kosikhar/Analog-Drum-Machine/README.md

# Analog-Drum-Machine
Capstone 2019 Analog Drum Machine project.
