kosikhar/Analog-Drum-Machine/Mixer/Notes on Line Level.docx

# Notes on Line Level for Mixer Circuit

Andrew Schroeder | 1452924 | 2019-02-18

Current output from instruments: 2V
