kosikhar/Analog-Drum-Machine/Cowbell/Block Diagram/Block Diagram-1.jpg

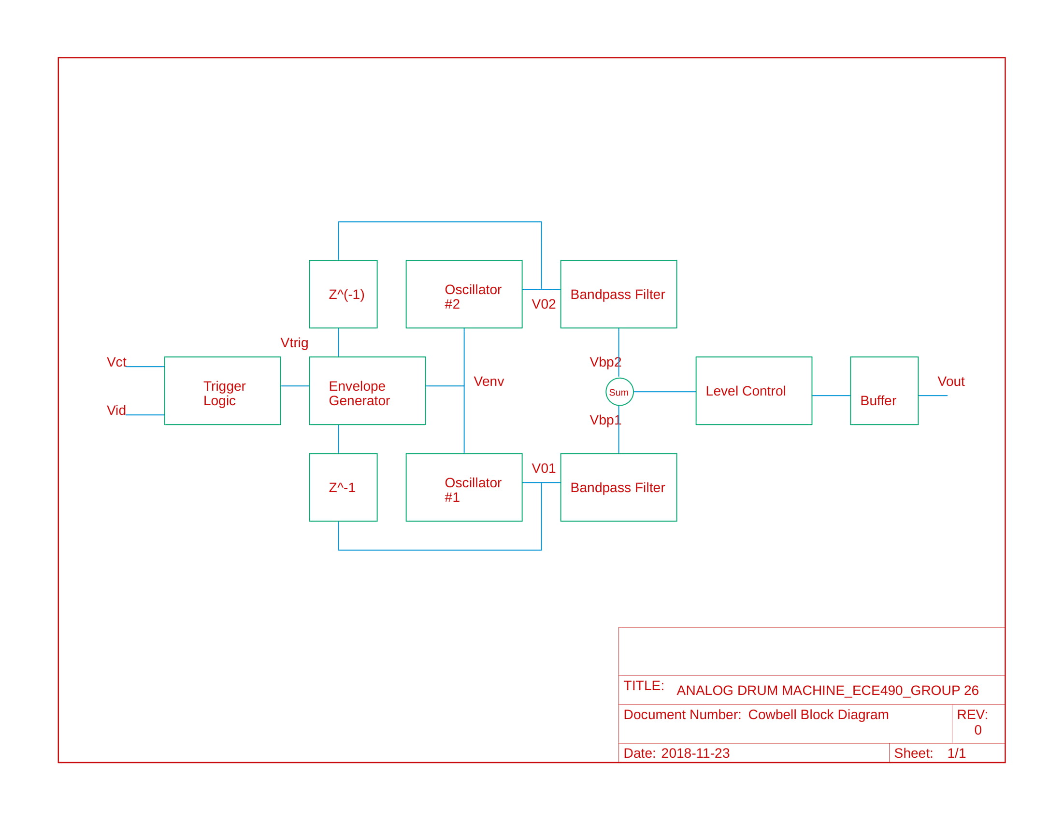
Cowbell/Block Diagram/Block Diagram-1.jpg
