kosikhar/Analog-Drum-Machine/Cowbell/Eagle Files/Cowbell_Brd.png

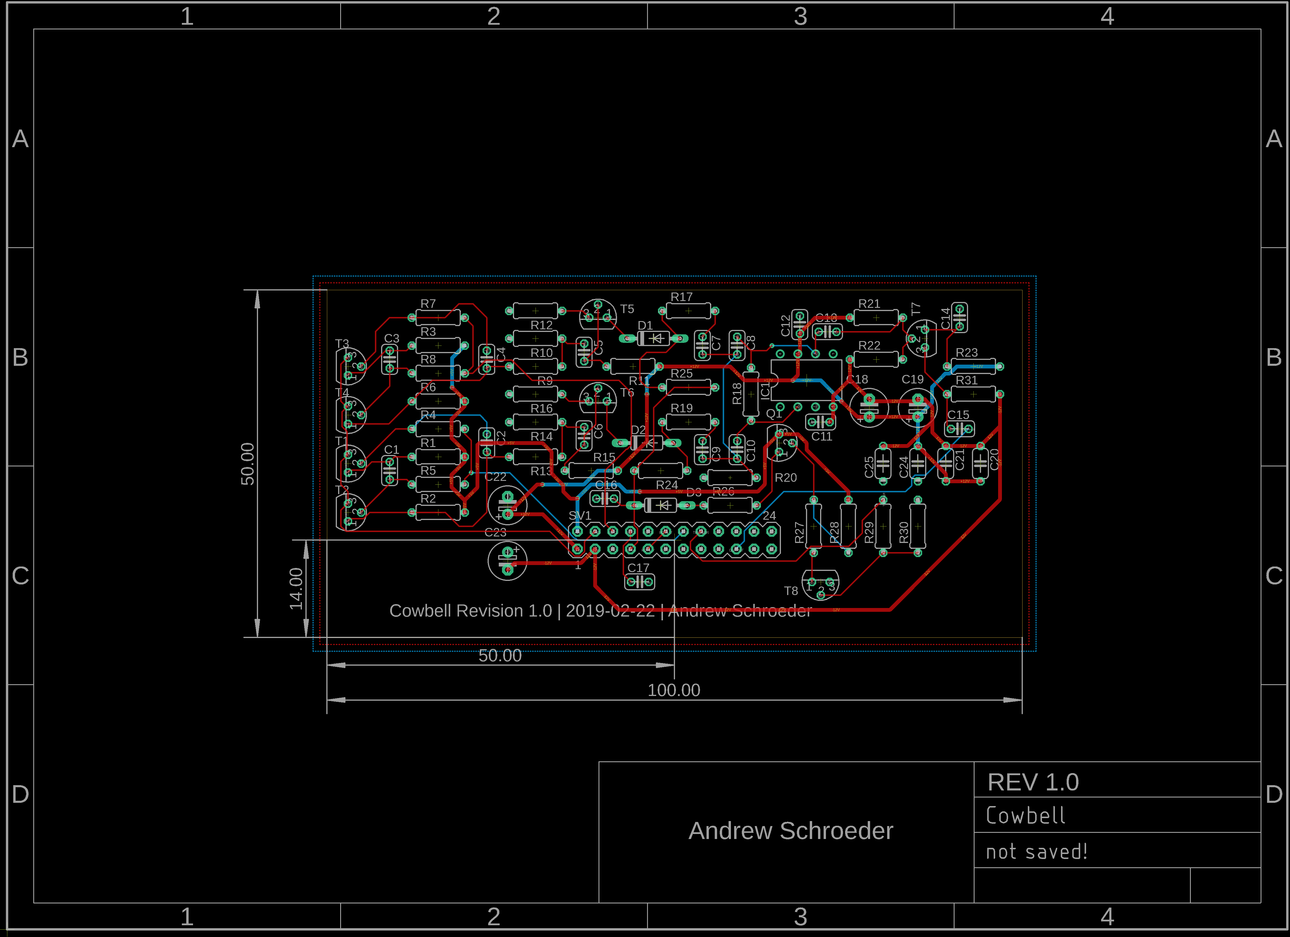
Cowbell/Eagle Files/Cowbell_Brd.png
