kosikhar/Analog-Drum-Machine/Cowbell/Eagle Files/Cowbell_Sch.png

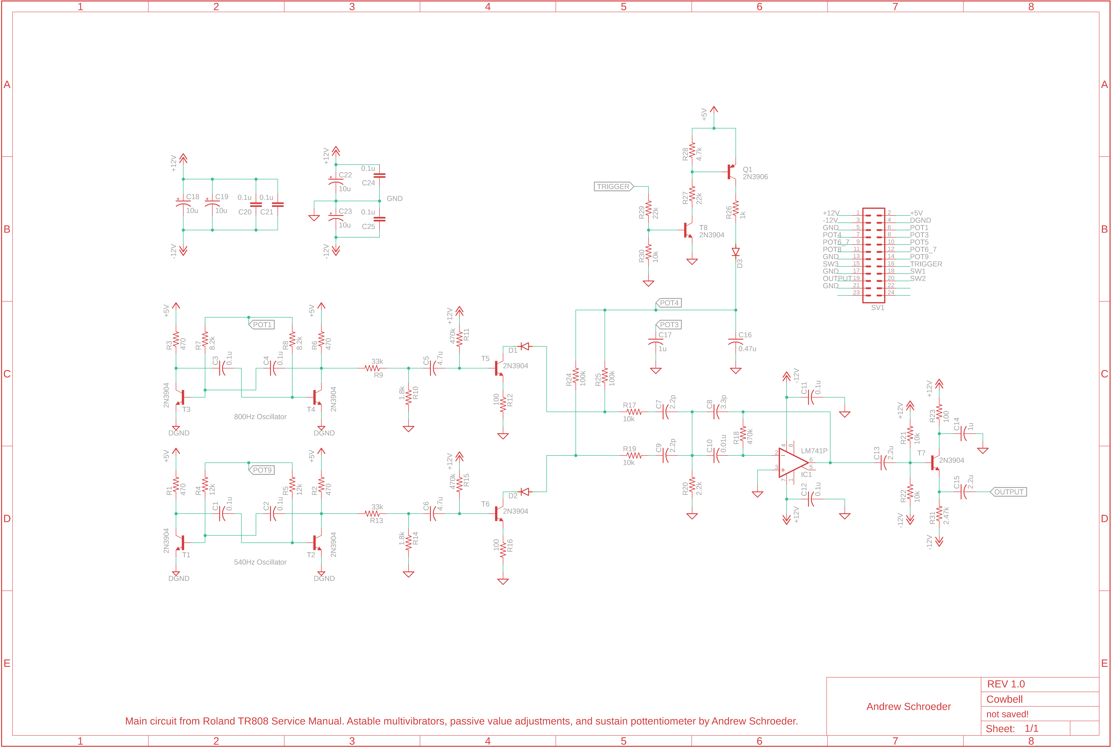
Cowbell/Eagle Files/Cowbell_Sch.png
