kosikhar/Analog-Drum-Machine/Mixer/Design References/Working with Cranky Op-Amps_files/hs-opamp-schem.png

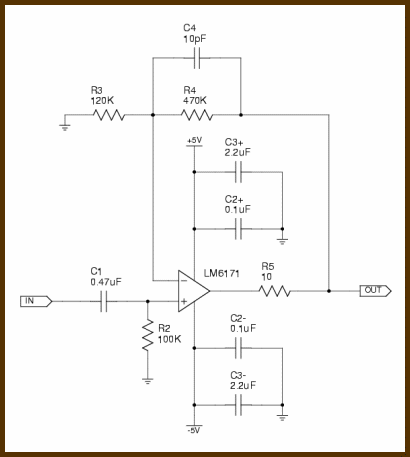
Mixer/Design References/Working with Cranky Op-Amps_files/hs-opamp-schem.png
