kosikhar/Analog-Drum-Machine/Mixer/Eagle Files/Mixer_Brd.png

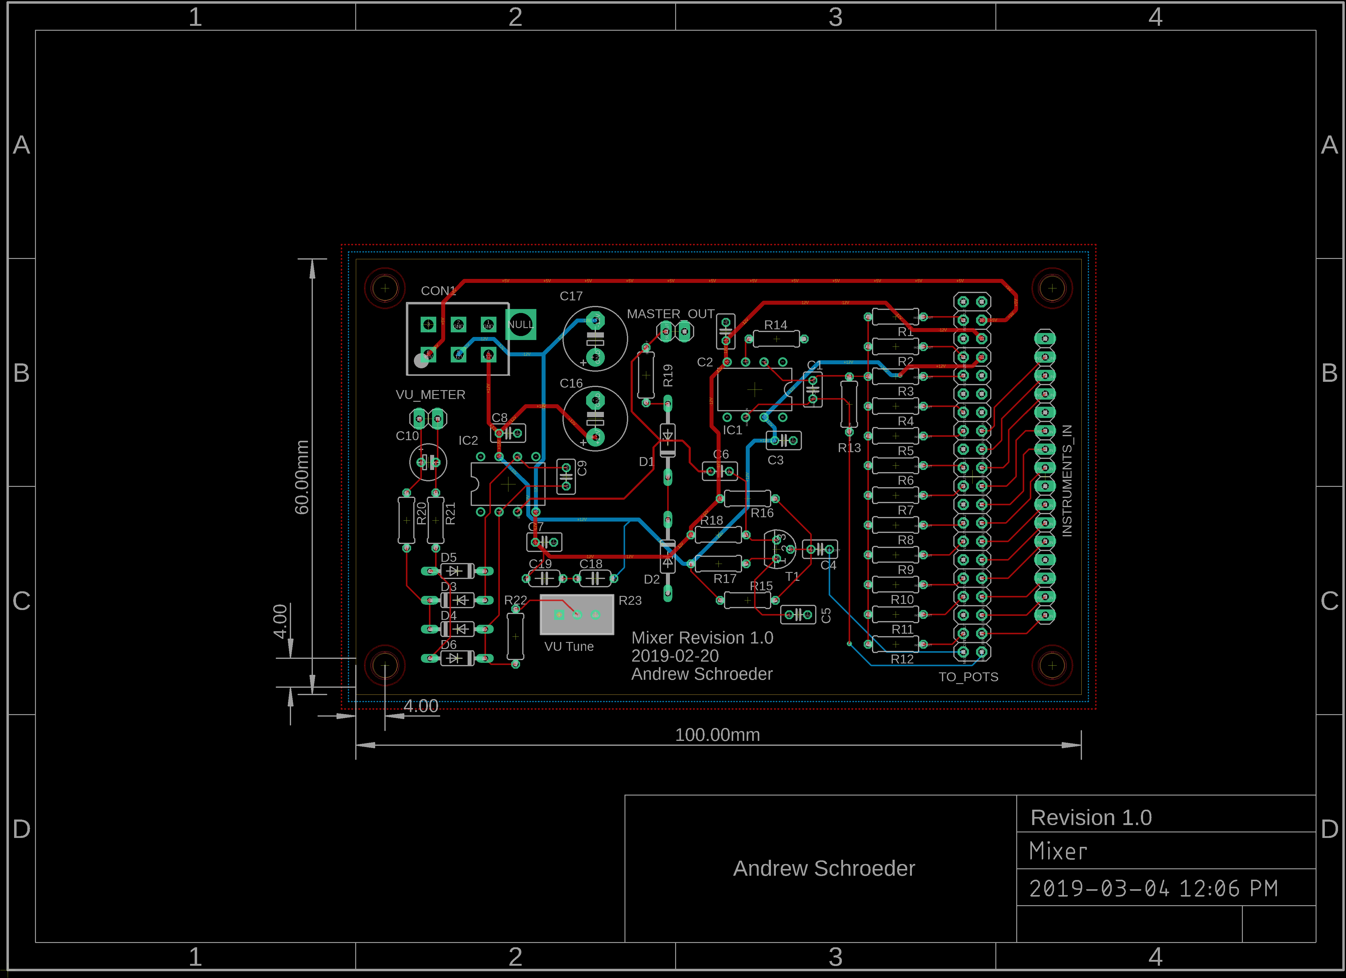
Mixer/Eagle Files/Mixer_Brd.png
