kosikhar/Analog-Drum-Machine/Mixer/Eagle Files/Mixer_Sch.png

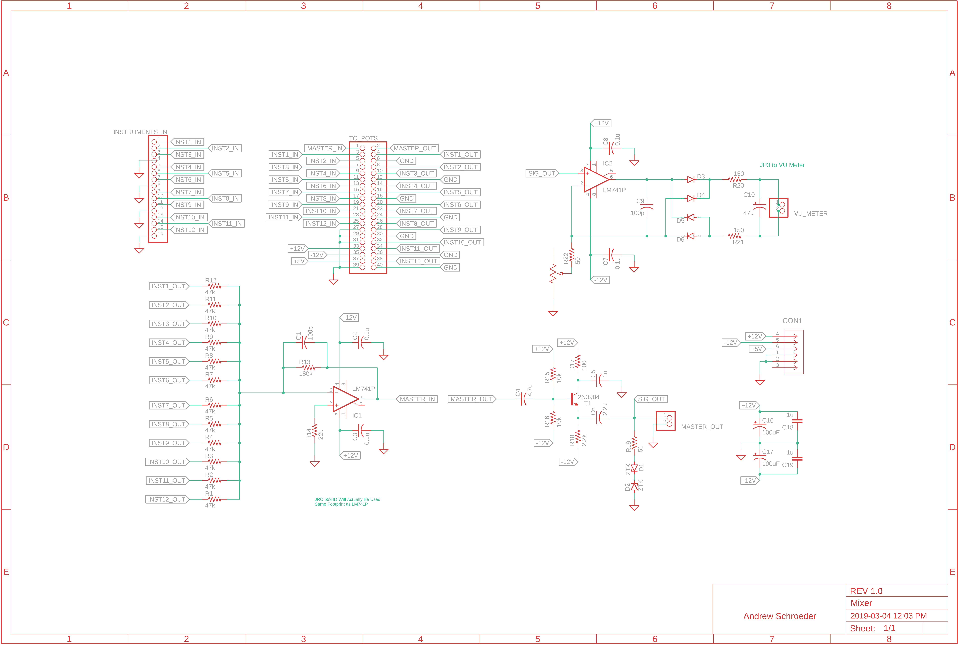
Mixer/Eagle Files/Mixer_Sch.png
