kosikhar/Analog-Drum-Machine/Cowbell/CB_BOM.xlsx

Shematic Reference Number | Part Description | Manufacturer Part Number | Price | Quantity Required | Owned | Total Cost | Location | Notes
C1, C6 | capacitor, 10µF | UCA2G100MPD1TD | $1.19 | 2 | 0 | $2.38 | ECE 302 or 303 Lab Kit
C2, C7 | capacitor, 2.2nF | VY1222M47Y5UQ63V0 | $0.66 | 2 | 0 | $1.32 | ECE 302 or 303 Lab Kit
C3 | capacitor, 10nF | C981U103MYVDBA7317 | $1.06 | 1 | 0 | $1.06 | Michael
C4, C15 | capacitor, 2.2µF | UMA1V2R2MCD2TP | $2.35 | 2 | 0 | $2.35 | General
C5, C9 | capacitor, 1µF | UVK1H010MDD1TD | $2.81 | 2 | 0 | $2.81 | General
C8 | capacitor, 3.3nF | DE2E3KY332MA3BM02F | $0.63 | 1 | 0 | $0.63 | CB Bag
C10 | capacitor, 470nF | C322C474M5U5TA | $0.72 | 1 | 0 | $0.72 | General
C11, C12 | capacitor, 15nF | K153K10X7RF5UH5 | $0.29 | 2 | 0 | $0.58 | CB Bag
C13, C14 | capacitor, 33nF | K333K15X7RF5TL2 | $0.34 | 2 | 0 | $0.68 | General
D1, D, D3 | Diode | 1n4148 | $0.93 | 3 | 0 | $0.93 | General
Q1, Q2, Q4-Q9 | NPN BJT | 2N3904 |  | 0 | 8 | $0.00 | Rick
Q3 | PNP BJT | 2N3906 |  | 0 | 1 | $0.00 | Rick
R1, R10, R17 | resistor, 33K | CF14JT33K0 | $0.63 | 3 | 0 | $0.63 | Resistor Bag
R2, R6, R11 | ` | CF14JT2K20 | $0.63 | 3 | 0 | $0.63 | Rick
R3, R7, R12 | resistor, 470K | CF14JT470K | $0.63 | 3 |  | $0.63 | Resistor Bag
R4, R13, R31 | resistor, 100 | CF14JT100R | $0.63 | 3 |  | $0.63 | Resistor Bag
R5, R8, R9, R16, R22 | resistor, 10K | CF14JT10K0 | $0.63 | 5 |  | $0.63 | Resistor Bag
R14, R15 | resistor, 100K | CF14JT100K | $0.63 | 2 |  | $0.63 | Resistor Bag
R18, R34 | resistor, 1K | CF14JT1K00 | $0.63 | 2 |  | $0.63 | Resistor Bag
R19, R21 | resistor, 22K | CF14JT22K0 | $0.63 | 2 |  | $0.63 | Resistor Bag
R20 | resistor, 4.7K | CF14JT4K70 | $0.63 | 1 |  | $0.63 | Resistor Bag
R23, R24, R27, R28 | resistor, 390 | CF14JT390R | $0.63 | 4 |  | $0.63 | Rick
R25, R26, R29, R30 | Duel Gang Log Pot, 100K | PDB182-K430K-104A | $2.81 | 2 |  | $5.62
R32 | resistor, 2.4K | CF14JT2K40 | $0.63 | 1 |  | $0.63 | Rick
R33 | resistor, 8K | CF14JT8K00 | $0.63 | 1 |  | $0.63
U1 | Op Amp | LM741 |  | 0 | 1 | $0.00
 |  |  |  |  |  | $26.64
 |  |  |  |  |  | #NAME?
