kosikhar/Analog-Drum-Machine/Mixer/Mixer_BOM.xlsx

Shematic Reference Number | Part Description | Digikey Part Number | Price | Quantity | Total Cost | Notes | Parts Received | Location of Parts
C1, C2, C5, C6 | capacitor, 100nF | 493-10420-1-ND | $14.24 | 26 | $14.24 | For 100 | 100 | Mixer Bag, General Bag
C4, C18 | capacitor, 2.2µF | 493-10467-1-ND | $4.70 | 13 | $4.70 | For 20 | 30 | Mixer Bag
C8 | capacitor, 10µF | 493-7383-1-ND | $1.24 | 1 | $1.24 |  | Use 4.7uF | Mixer Bag
C16 | capacitor, 4.7µF | 493-13004-1-ND | $1.04 | 1 | $1.04 |  | 5 | Mixer Bag
C17 | capacitor, 1µF | 493-12567-1-ND | $0.41 | 1 | $0.41 |  | 30 | General Bag
Q1 | bipolar transistor | 2N3904 |  | 0
R1 | resistor, 80.6K | RNF14FTD80K6CT-ND | $0.15 | 1 | $0.15 |  | 3 | Mixer Bag
R2, R4 | resistor, 1K | CF14JT1K00CT-ND | $0.16 | 24 | $0.16
R3, R5-R12, R15-R18, R21-R23 | resistor, 47K | CF14JT47K0CT-ND | $1.13 | 16 | $1.13 | For 25
R13 | resistor, 100 | CF14JT100RCT-ND | $0.16 | 1 | $0.16
R14 | resistor, 2.4K | PPC2.4KW-1CT-ND | $0.35 | 1 | $0.35
U2, U3 | Op Amp | uA741 |  | 13
U1, U4 | Pot | Rtot=50K wiper=1 |  | 13 |  |  | 1 | Mixer Bag
C3, C7 | capacitor, 100pF | BC5223CT-ND | $4.38 | 13 | $4.38 |  | 2 | Mixer Bag
 |  |  |  |  | $27.96
