kosikhar/Analog-Drum-Machine/Power Supply/Power Supply BOM V4.xlsx

Description | Digikey Part Number | Quantity | Individual Cost | Total
33VCT XFMR (already have) | HM563-ND | 1 | $36.11 | $36.11
6.3VCT XFMR (already have) | 237-1917-ND | 1 | $11.01 | $11.01
4A NPN | KSD526YTU-ND | 2 | $1.06 | $2.12
4A PNP | KSB596YTU-ND | 1 | $1.23 | $1.23
700mA NPN | KSC2331YTACT-ND | 2 | $0.62 | $1.24
700mA PNP | KSA931YTACT-ND | 1 | $0.57 | $0.57
LM741 | LM741CNNS/NOPB-ND | 1 | $1.31 | $1.31
8 pin DIP socket | AE9986-ND | 1 | $0.25 | $0.25
3A rectifier diode | 1N5402DICT-ND | 8 | $0.55 | $4.40
2.3A 47uH inductor | 732-3769-ND | 3 | $1.36 | $4.08
4.7V Zener | 1N5230B-ND | 2 | $0.20 | $0.40
9.1V Zener | 1N5239B-ND | 2 | $0.20 | $0.40
5.1V Zener | 1N5231CTRCT-ND | 1 | $0.20 | $0.20
6.2V Zener | 1N5234B-ND | 1 | $0.20 | $0.20
15V Zener | 1N5245BFS-ND | 1 | $0.20 | $0.20
50V 6800uF Capacitor, 1000 hours at 105C | 493-1349-ND | 2 | $5.25 | $10.50
50V 1uF ceramic capacitor | 445-173579-1-ND | 10 | $0.32 | $3.20
50V 0.1uF ceramic capacitor | 445-173588-1-ND | 10 | $0.26 | $2.60
25V 100uF capacitor, 5000 hours at 105C | 1189-2237-ND | 3 | $0.33 | $0.99
16V 10,000uF capacitor, 1000 hours at 105C | 493-12463-ND | 1 | $2.82 | $2.82
Fuse Holder 5x20mm | F6094-ND | 3 | $0.68 | $2.04
2A, 250VAC Fuse, 5x20mm | 507-1249-ND | 1 | $0.31 | $0.31
Chassis mount fuse holder, 5x20mm | F1502-ND | 1 | $2.25 | $2.25
1A, 250VAC Fuse, 5x20mm | 507-1261-ND | 1 | $0.30 | $0.30
Thyristor | C106M1GOS-ND | 3 | $0.93 | $2.79
1K resistor, 0.5W | CF12JT1K00CT-ND | 2 | $0.15 | $0.30
100 ohm resistor, 0.5W | CF12JT100RCT-ND | 4 | $0.15 | $0.60
IEC 3 pin power connector | Q212-ND | 1 | $1.16 | $1.16
Power Switch | EG1510-ND | 1 | $1.61 | $1.61
 |  |  |  | $95.19
