kosikhar/Analog-Drum-Machine/Analog Drums/BOM - Analog Drum.xlsx

Description | Part # | Digikey # | Digikey Link | Price | Quantity | # Owned | Total | Notes: | TOTAL
Signal NPN | 2N3904 | 2N3904-APCT-ND | https://www.digikey.ca/product-detail/en/micro-commercial-co/2N3904-AP/2N3904-APCT-ND/950591 | 0.27 | 3 | 0 | 0.81 | Doesn't have to 2N3904, 2N2222 will also work fine. | 28.09
Signal PNP | 2N3906 | 2N3906-APCT-ND | https://www.digikey.ca/product-detail/en/micro-commercial-co/2N3906-AP/2N3906-APCT-ND/950592 | 0.27 | 2 | 0 | 0.54
Diode | 1N4148 | 1N4148FS-ND | https://www.digikey.ca/product-detail/en/on-semiconductor/1N4148/1N4148FS-ND/458603 | 0.14 | 4 | 0 | 0.56 | Doesn't have to be this diode, but diode needs to be small sig
OP Amp | LM741CN | LM741CNNS/NOPB-ND | https://www.digikey.ca/product-detail/en/texas-instruments/LM741CN-NOPB/LM741CNNS-NOPB-ND/6322 | 1.36 | 5 | 5 | 0 | EE Club/Rick
50k linear Pot | P160KNP-0QC15B50K | 987-1733-ND | https://www.digikey.ca/product-detail/en/tt-electronics-bi/P160KNP-0QC15B50K/987-1733-ND/5957477 | 1.12 | 5 | 5 | 0 | We using the pots that we already have
10k Trim Pot | PV36W103C01B00 | 490-2875-ND | https://www.digikey.ca/product-detail/en/bourns-inc/PV36W103C01B00/490-2875-ND/666502 | 2.35 | 4 | 4 | 0 | These are in EE Club room
100k Trim Pot | PV36W104C01B00 | 490-2876-ND | https://www.digikey.ca/product-detail/en/bourns-inc/PV36W104C01B00/490-2876-ND/666503 | 2.35 | 6 | 0 | 14.1 | Sorry
 |  |  |  |  |  |  | 0
Resistors |  |  |  |  |  |  | 0
2.2M |  |  |  | 0.15 | 1 | 0 | 0.15
1M |  |  |  | 0.15 | 2 | 2 | 0 | Get whatever resistor
100k |  |  |  | 0.15 | 2 | 1 | 0.15
47k |  |  |  | 0.15 | 3 | 0 | 0.45
22k |  |  |  | 0.15 | 2 | 0 | 0.3
11k |  |  |  | 0.15 | 1 | 0 | 0.15 | Yes I need it to be 11k
10k |  |  |  | 0.15 | 2 | 2 | 0
8.2k |  |  |  | 0.15 | 1 | 1 | 0
4.7k |  |  |  | 0.06 | 10 | 10 | 0
2.7k |  |  |  | 0.15 | 1 | 1 | 0
1k |  |  |  | 0.15 | 2 | 2 | 0
220 |  |  |  | 0.15 | 1 | 1 | 0
 |  |  |  |  |  |  | 0
Capacitors |  |  |  |  |  |  | 0 | I would prefer ceramics
100uF |  |  |  |  | 4 | 0 | 0 | EE Lab Kits
10uF |  |  |  |  | 1 | 0 | 0 | EE Lab Kits
2.2uF | FG24X7R1H225KRT06 | 445-173378-1-ND | https://www.digikey.ca/product-detail/en/tdk-corporation/FG24X7R1H225KRT06/445-173378-1-ND/5811983 | 0.85 | 4 | 0 | 3.4
1uF | FG28X5R1H105KRT06 | 445-173579-1-ND | https://www.digikey.ca/product-detail/en/tdk-corporation/FG28X5R1H105KRT06/445-173579-1-ND/5812184 | 0.45 | 3 | 0 | 1.35
0.22uF | K223K15X7RF5TL2 | BC1080CT-ND | https://www.digikey.ca/product-detail/en/vishay-bc-components/K223K15X7RF5TL2/BC1080CT-ND/286702 | 0.32 | 1 | 0 | 0.32
0.15uF | FG18X7R1E154KNT06 | 445-173262-1-ND | https://www.digikey.ca/product-detail/en/tdk-corporation/FG18X7R1E154KNT06/445-173262-1-ND/5811867 | 0.37 | 1 | 0 | 0.37
0.1uF | SR215C104KAR | 478-3188-ND | https://www.digikey.ca/product-detail/en/avx-corporation/SR215C104KAR/478-3188-ND/936830 | 0.199 | 10 | 0 | 1.99
0.047uF | K473K15X7RF5TL2 | BC1082CT-ND | https://www.digikey.ca/product-detail/en/vishay-bc-components/K473K15X7RF5TL2/BC1082CT-ND/286704 | 0.34 | 1 | 0 | 0.34
0.022uF | FG28X7R1H224KRT06 | 445-173594-1-ND | https://www.digikey.ca/product-detail/en/tdk-corporation/FG28X7R1H224KRT06/445-173594-1-ND/5812199 | 0.41 | 2 | 0 | 0.82
 |  |  |  |  |  |  | 0
Connector |  |  |  |  |  |  | 0
12x2 Male Header | 61302421021 | 732-5359-ND | https://www.digikey.ca/product-detail/en/wurth-electronics-inc/61302421021/732-5359-ND/4846868 | 2.29 | 1 | 0 | 2.29
