kosikhar/Analog-Drum-Machine/Sequencer/Complex/BOM - Sequencer.xlsx

Description | Part # | Digikey # | Digikey Link | Price | Quantity | # Owned | Total | Notes: | TOTAL
D Flip-Flip | SN74HC273N | 296-1587-5-ND | https://www.digikey.ca/product-detail/en/texas-instruments/SN74HC273N/296-1587-5-ND/277233 | 0.81 | 8 | 8 | 0 |  | 42.78
8-Bit Transiever | SN74HC245N | 296-1584-5-ND | https://www.digikey.ca/product-detail/en/texas-instruments/SN74HC245N/296-1584-5-ND/277230 | 0.78 | 12 | 0 | 9.36
SRAM (2K x 8) | 6116SA15TPG | 800-2603-5-ND | https://www.digikey.ca/product-detail/en/idt-integrated-device-technology-inc/6116SA15TPG/800-2603-5-ND/2008361 | 6.76 | 1 | 0 | 6.76
SIPO Shift Register with Output Reg | SN74AHC594N | 296-33681-5-ND | https://www.digikey.ca/products/en/integrated-circuits-ics/logic-shift-registers/712?k=SN74AHC594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 | 0.92 | 2 | 0 | 1.84
3-Bit Counter | SN74HC590AN | 296-1599-5-ND | https://www.digikey.ca/products/en/integrated-circuits-ics/logic-counters-dividers/731?k=sn74hc590a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 | 0.97 | 3 | 0 | 2.91
8-1 MUX | SN74HC151N | 296-8236-5-ND | https://www.digikey.ca/product-detail/en/texas-instruments/SN74HC151N/296-8236-5-ND/376974 | 0.8 | 3 | 0 | 2.4
NPN | 2N3904-AP | 2N3904-APCT-ND | https://www.digikey.ca/product-detail/en/micro-commercial-co/2N3904-AP/2N3904-APCT-ND/950591 | 0.27 | 16 | 0 | 4.32
8 - 3 Priority Encoder | SN74HC148N | 296-8233-5-ND | https://www.digikey.ca/product-detail/en/texas-instruments/SN74HC148N/296-8233-5-ND/376979 | 0.61 | 3 | 0 | 1.83 | Need to Change from SN54LS348N
NAND 2 Input (4-Pack) | SN74LS00N | 296-1626-5-ND | https://www.digikey.ca/product-detail/en/texas-instruments/SN74LS00N/296-1626-5-ND/277272 | 1.76 | 16 | 16 | 0 | Same Chip as in 210 Lab
NAND 3 Input (3-Pack) | SN74HC10N | 296-8214-5-ND | https://www.digikey.ca/product-detail/en/texas-instruments/SN74HC10N/296-8214-5-ND/376902 | 0.72 | 12 | 0 | 8.64
NAND 4 Input (2-Pack) | SN74HC20N | SN74HC20N | https://www.digikey.ca/product-detail/en/texas-instruments/SN74HC20N/296-12892-5-ND/476048 | 0.59 | 8 | 0 | 4.72
