kosikhar/Analog-Drum-Machine/(list of files, cad)

Other CAD files:
Enclosure/Parts/Wood_Cutting_Outline.SLDPRT
