kosikhar/Analog-Drum-Machine/Mixer/Simulation Results/step_Instrument_Volume_1_0.1_0.2_Frequency_Response.PNG

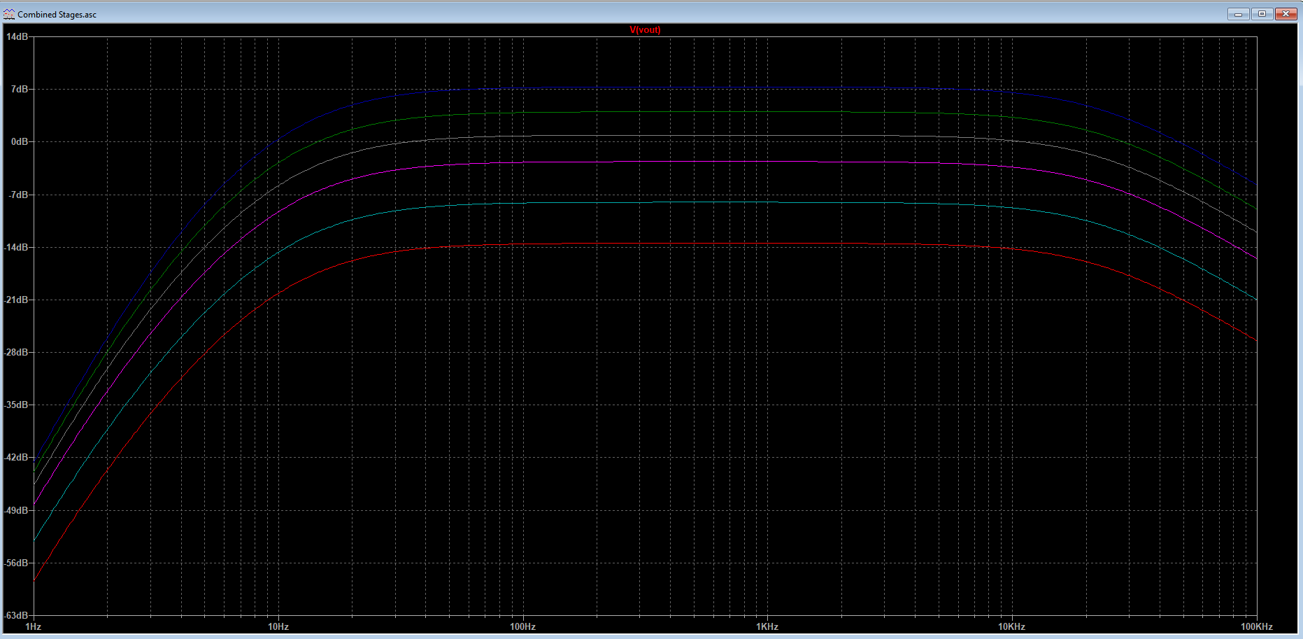
Mixer/Simulation Results/step_Instrument_Volume_1_0.1_0.2_Frequency_Response.PNG
