kosikhar/Analog-Drum-Machine/Mixer/Prototype Characterization/VU Meter values.xlsx

DB | Current (mA)
-40 | 0.038
-30 | 0.13
-20 | 0.22
-10 | 0.42
-7 | 0.53
-5 | 0.61
-3 | 0.74
-1 | 0.87
0 | 0.96
1 | 1.05
2 | 1.15
3 | 1.25
4 | 1.39
5 | 1.548
Very Max: | 1.98
