kosikhar/Analog-Drum-Machine/Mixer/Prototype Characterization/Line Level Notes.docx

# Line Level Notes

Andrew Schroeder | 2019-02-18

Output level from instruments: 2V_(pp) =1V_p =0.707V_(rms) =0.637V_(avg)

A VU meter configured for professional line level reads 0dB when the input has 1.125V_(avg) , meaning that a reading of +4dB will be shown when a sin wave of 2V_(rms) is present, the maximum undistorted level.

Level (dB) | V_(pp) (V) | V_p (V) | V_(rms) (V) | V_(avg) (V) | Necessary Gain (V/V)
0 | 3.53 | 1.77 | 1.25 | 1.125 | 1.77
+4 | 5.66 | 2.83 | 2 | 1.80 | 2.83
