kosikhar/Analog-Drum-Machine/Mixer/Prototype Characterization/Mixer Characterization.xlsx

Sheet: Prototype
Signal Frequency(Hz) | Vpp | Gain (V/V) | Gain (dB)
5 | 0.616 | 0.267826087 | -11.44294248
10 | 1.18 | 0.5130434783 | -5.796916574 | For a 2Vpp Input Signal
11 | 1.2 | 0.5217391304 | -5.650931799 | Maximum Output Signal at MidBand (1000Hz): 3.40Vpp
12 | 1.27 | 0.552173913 | -5.158482301 | 2.09546% difference between Max Output and +4 dBu Line Level (Pro)
13 | 1.34 | 0.5826086957 | -4.692460753
14 | 1.44 | 0.6260869565 | -4.067306878
15 | 1.49 | 0.647826087 | -3.770831352
16 | 1.56 | 0.6782608696 | -3.372064753
17 | 1.58 | 0.6869565217 | -3.261414981
18 | 1.68 | 0.7304347826 | -2.728371086
19 | 1.7 | 0.7391304348 | -2.625578293
20 | 1.76 | 0.7652173913 | -2.324303364
30 | 1.96 | 0.852173913 | -1.389435293
50 | 2.12 | 0.9217391304 | -0.7078395018
100 | 2.24 | 0.9739130435 | -0.2295963537
500 | 2.28 | 0.9913043478 | -0.07585978034
1000 | 2.3 | 1 | 0
2000 | 2.26 | 0.9826086957 | -0.1523879374
4000 | 2.26 | 0.9826086957 | -0.1523879374
6000 | 2.26 | 0.9826086957 | -0.1523879374
8000 | 2.16 | 0.9391304348 | -0.5454816973
10000 | 2.1 | 0.9130434783 | -0.7901708257
12000 | 2 | 0.8695652174 | -1.213956807
14000 | 1.92 | 0.8347826087 | -1.568532146
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
