kosikhar/Analog-Drum-Machine/Mixer/Simulation Results/Instrument_Count_VS_Frequency_ResponsePNG.PNG

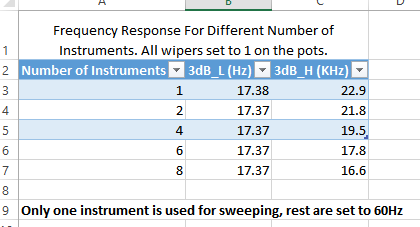
Mixer/Simulation Results/Instrument_Count_VS_Frequency_ResponsePNG.PNG
