kosikhar/Analog-Drum-Machine/Mixer/Combined Stages.pdf

# INPUT1

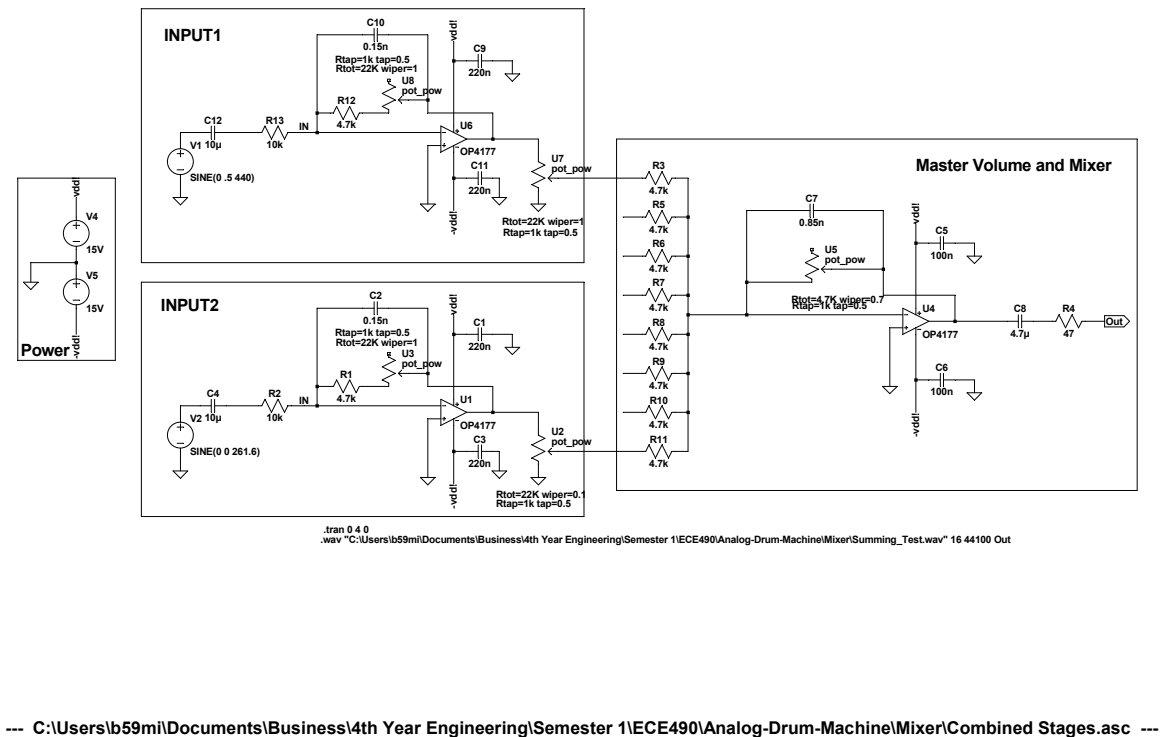
[picture p9: page 1]

Master Volume and Mixer

.tran 0 4 0
.wav "C:\Users\b59mi\Documents\Business\4th Year Engineering\Semester 1\ECE490\Analog-Drum-Machine\Mixer\Summing_Test.wav" 16 44100 Out

--- C:\Users\b59mi\Documents\Business\4th Year Engineering\Semester 1\ECE490\Analog-Drum-Machine\Mixer\Combined Stages.asc ---
