kosikhar/Analog-Drum-Machine/Cowbell/Block Diagram/Cowbell_Circuit.pdf

## Trigger Logic

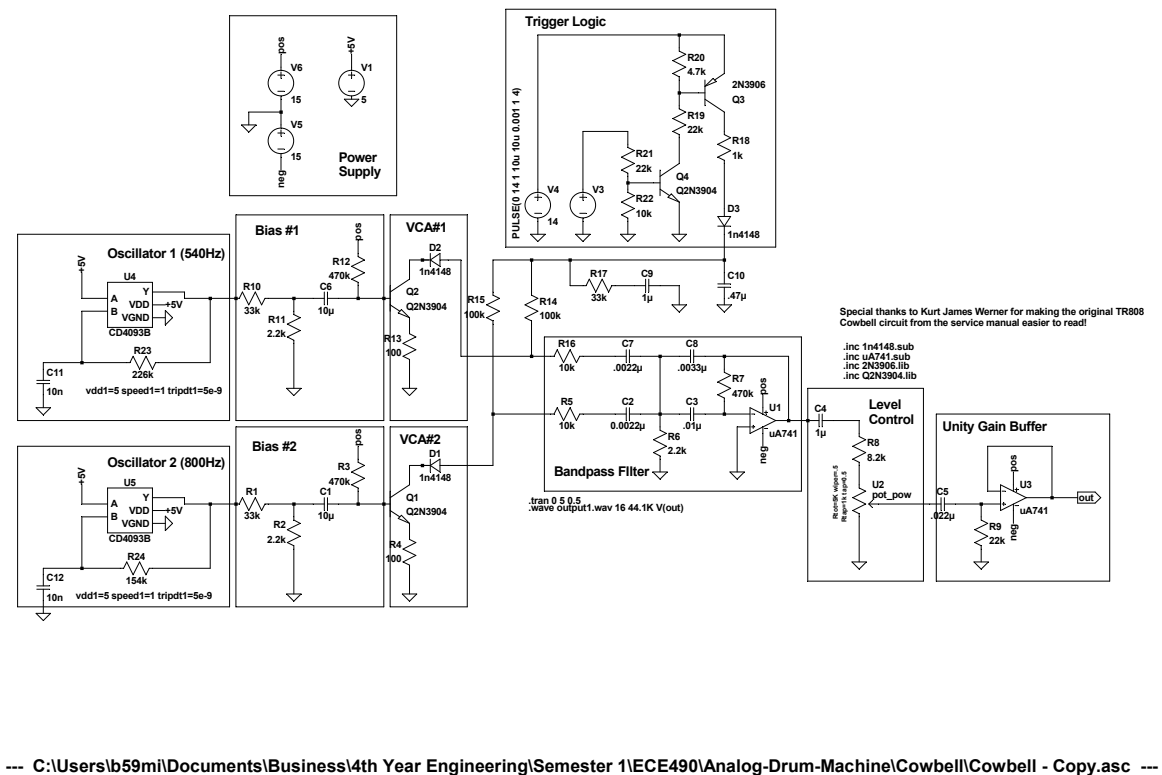
[picture p10: page 1]

Special thanks to Kurt James Werner for making the original TR808
Cowbell circuit from the service manual easier to read!

.tran 0 5 0.5 .wave output1.wav 16 44.1K V(out)

--- C:\Users\b59mi\Documents\Business\4th Year Engineering\Semester 1\ECE490\Analog-Drum-Machine\Cowbell\Cowbell - Copy.asc ---
