kosikhar/Analog-Drum-Machine/Analog Drums/Block Diagram - Drums/Drum Block Diagram.pdf

A

1 | 2 | 3 | 4 | 5 | 6

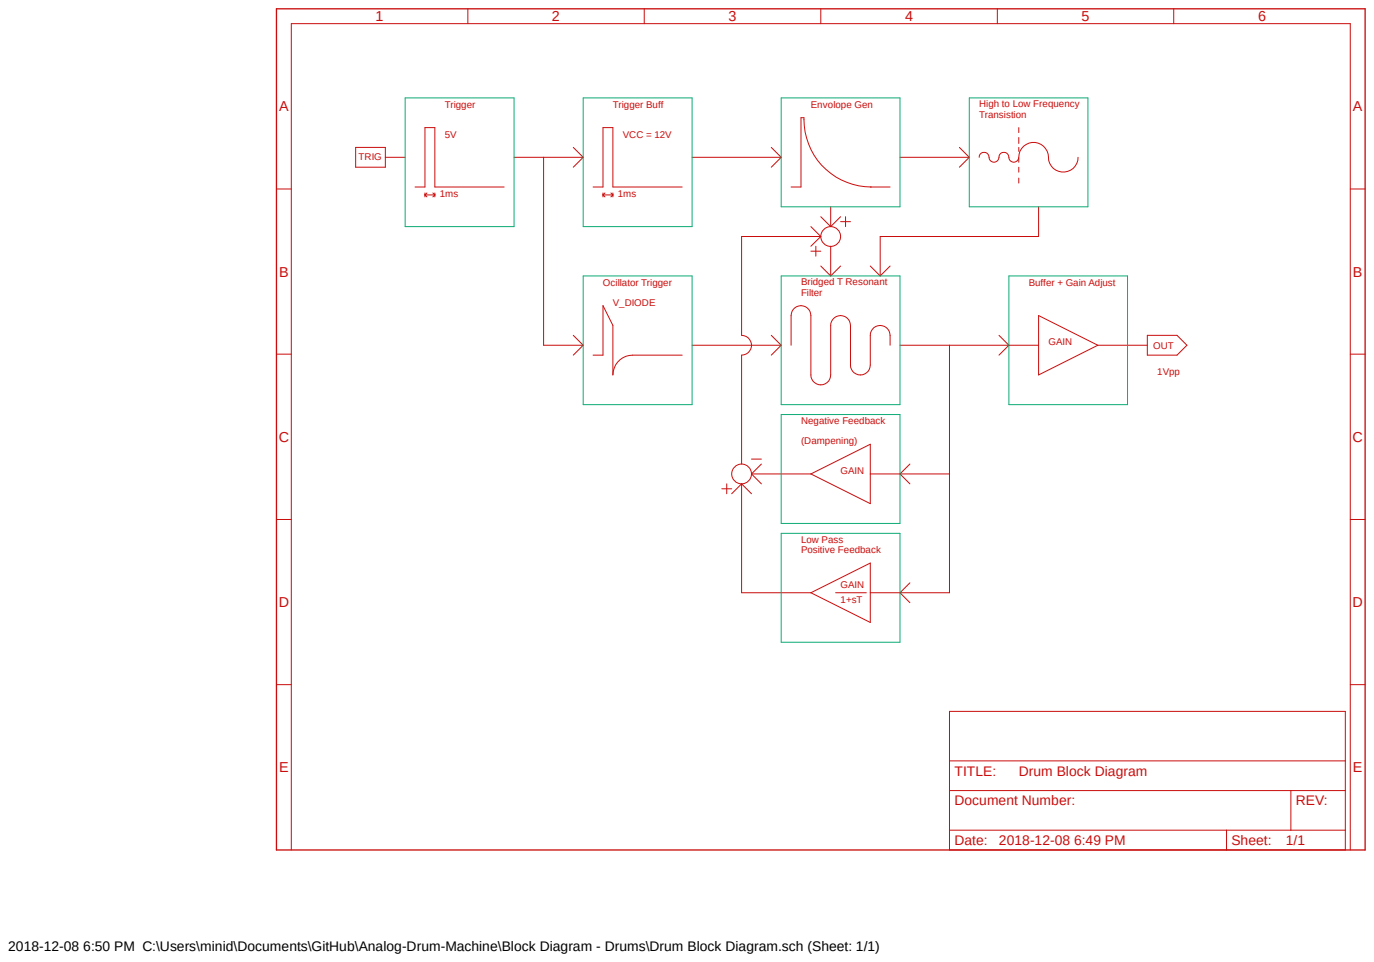
[picture p11: page 1]
Trigger; Trigger Buff; VCC = 12V; Envolope Gen; Ocillator Trigger; V_DIODE; Bridged T Resonant Filter; Negative Feedback; Low Pass Positive Feedback; GAIN; GAIN 1+sT; TRIG; OUT; 1Vpp; (Dampening); Transistion A; TITLE:

High to Low Frequency

Buffer + Gain Adjust

Drum Block Diagram

Document Number: | REV:

Date: 2018-12-08 6:49 PM | Sheet: 1/1

2018-12-08 6:50 PM C:\Users\minid\Documents\GitHub\Analog-Drum-Machine\Block Diagram - Drums\Drum Block Diagram.sch (Sheet: 1/1)
