kosikhar/Analog-Drum-Machine/Mixer/Input_Module.pdf

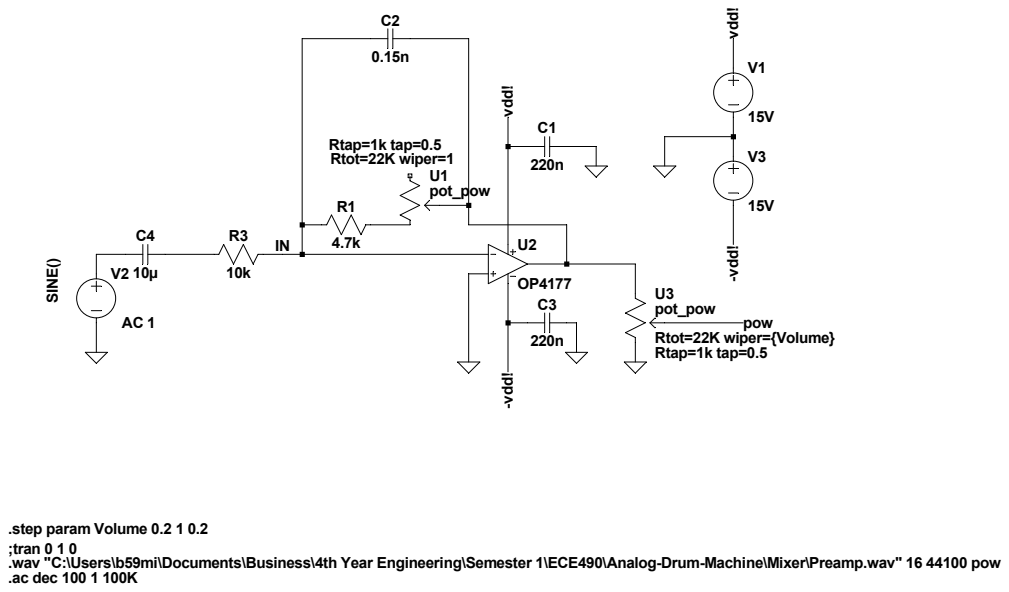
[picture p12: page 1]

.step param Volume 0.2 1 0.2
;tran 0 1 0
.wav "C:\Users\b59mi\Documents\Business\4th Year Engineering\Semester 1\ECE490\Analog-Drum-Machine\Mixer\Preamp.wav" 16 44100 pow
.ac dec 100 1 100K
