kosikhar/Analog-Drum-Machine/Mixer/Mixer Block Diagram.pdf

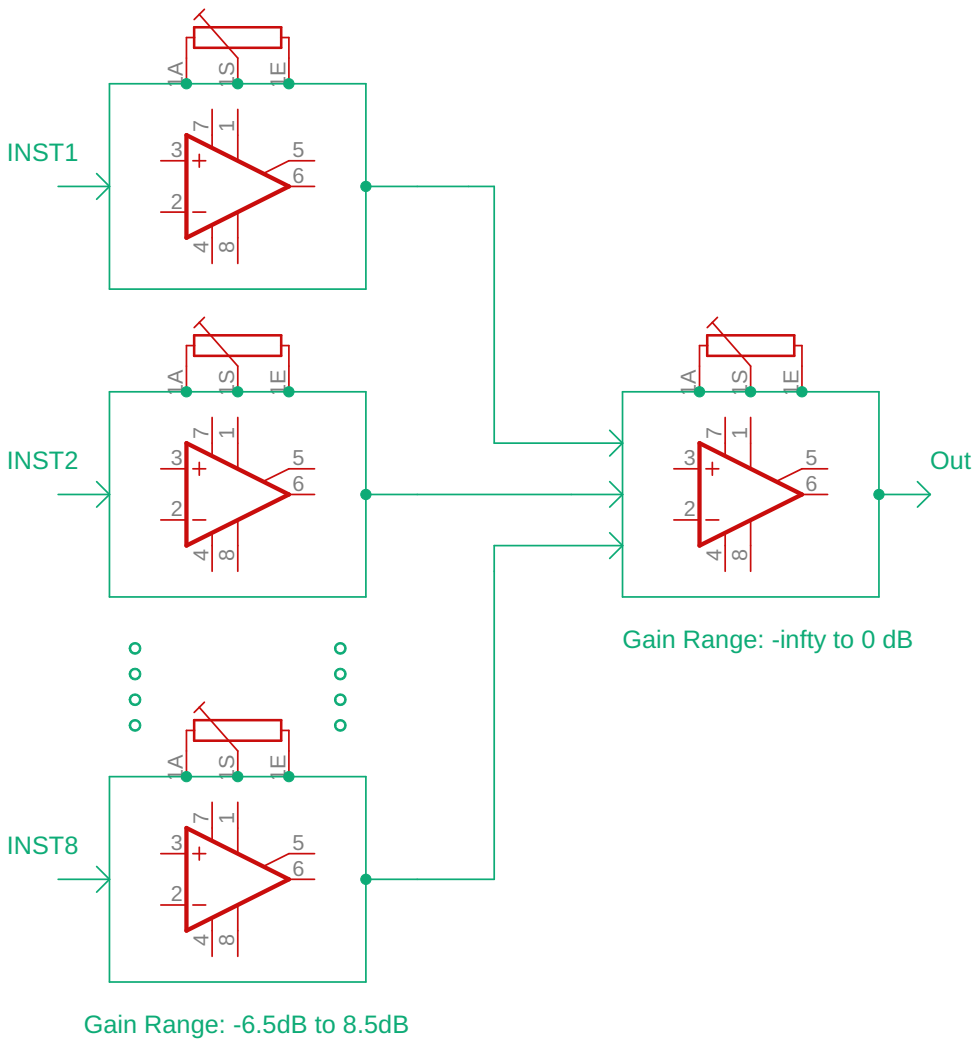
[picture p13: page 1]

Gain Range: -infty to 0 dB
