kosikhar/Analog-Drum-Machine/Mixer/Summing_Stage.pdf

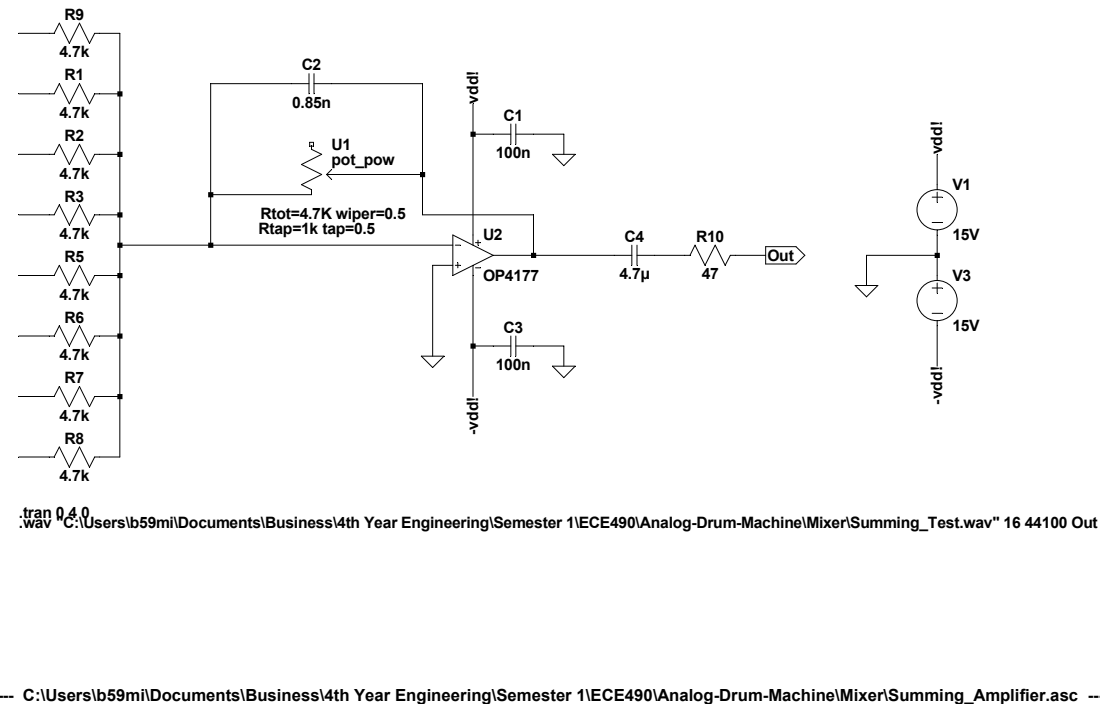
[picture p14: page 1]

.wav "C:\Users\b59mi\Documents\Business\4th Year Engineering\Semester 1\ECE490\Analog-Drum-Machine\Mixer\Summing_Test.wav" 16 44100 Out .tran 0 4 0

--- C:\Users\b59mi\Documents\Business\4th Year Engineering\Semester 1\ECE490\Analog-Drum-Machine\Mixer\Summing_Amplifier.asc ---
