kosikhar/Analog-Drum-Machine/Cowbell/Block Diagram/Block Diagram.pdf

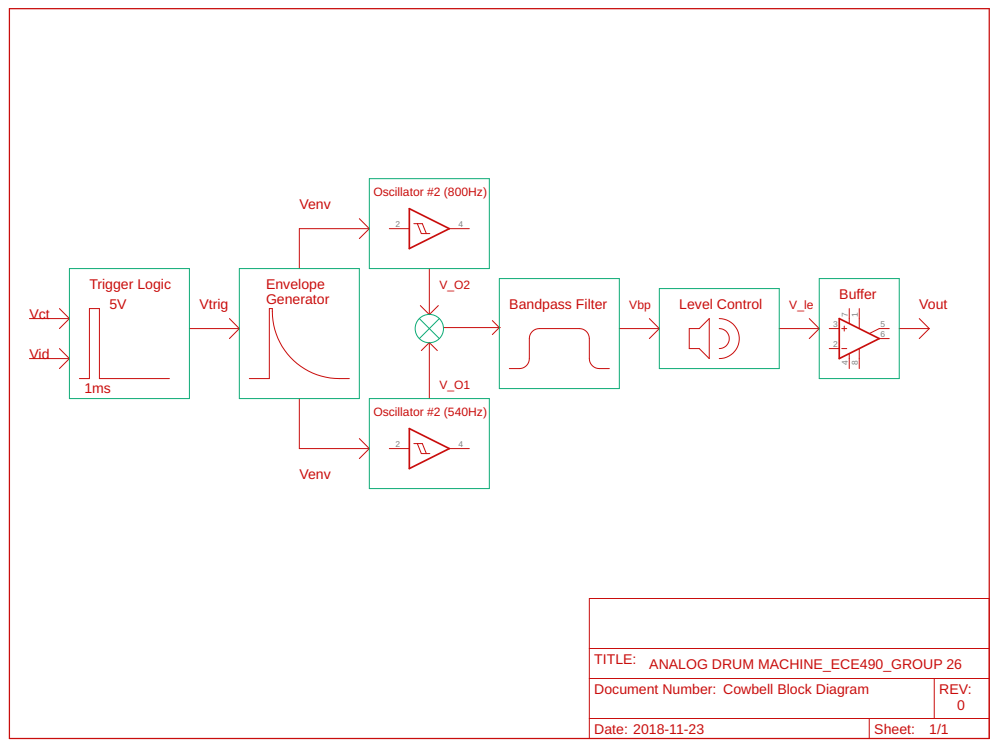
[picture p15: page 1]

Document Number: Cowbell Block Diagram | REV: 0

Date: 2018-11-23 | Sheet: 1/1
