kosikhar/Analog-Drum-Machine/Sequencer/Basic/Sequencer Block Diagram.pdf

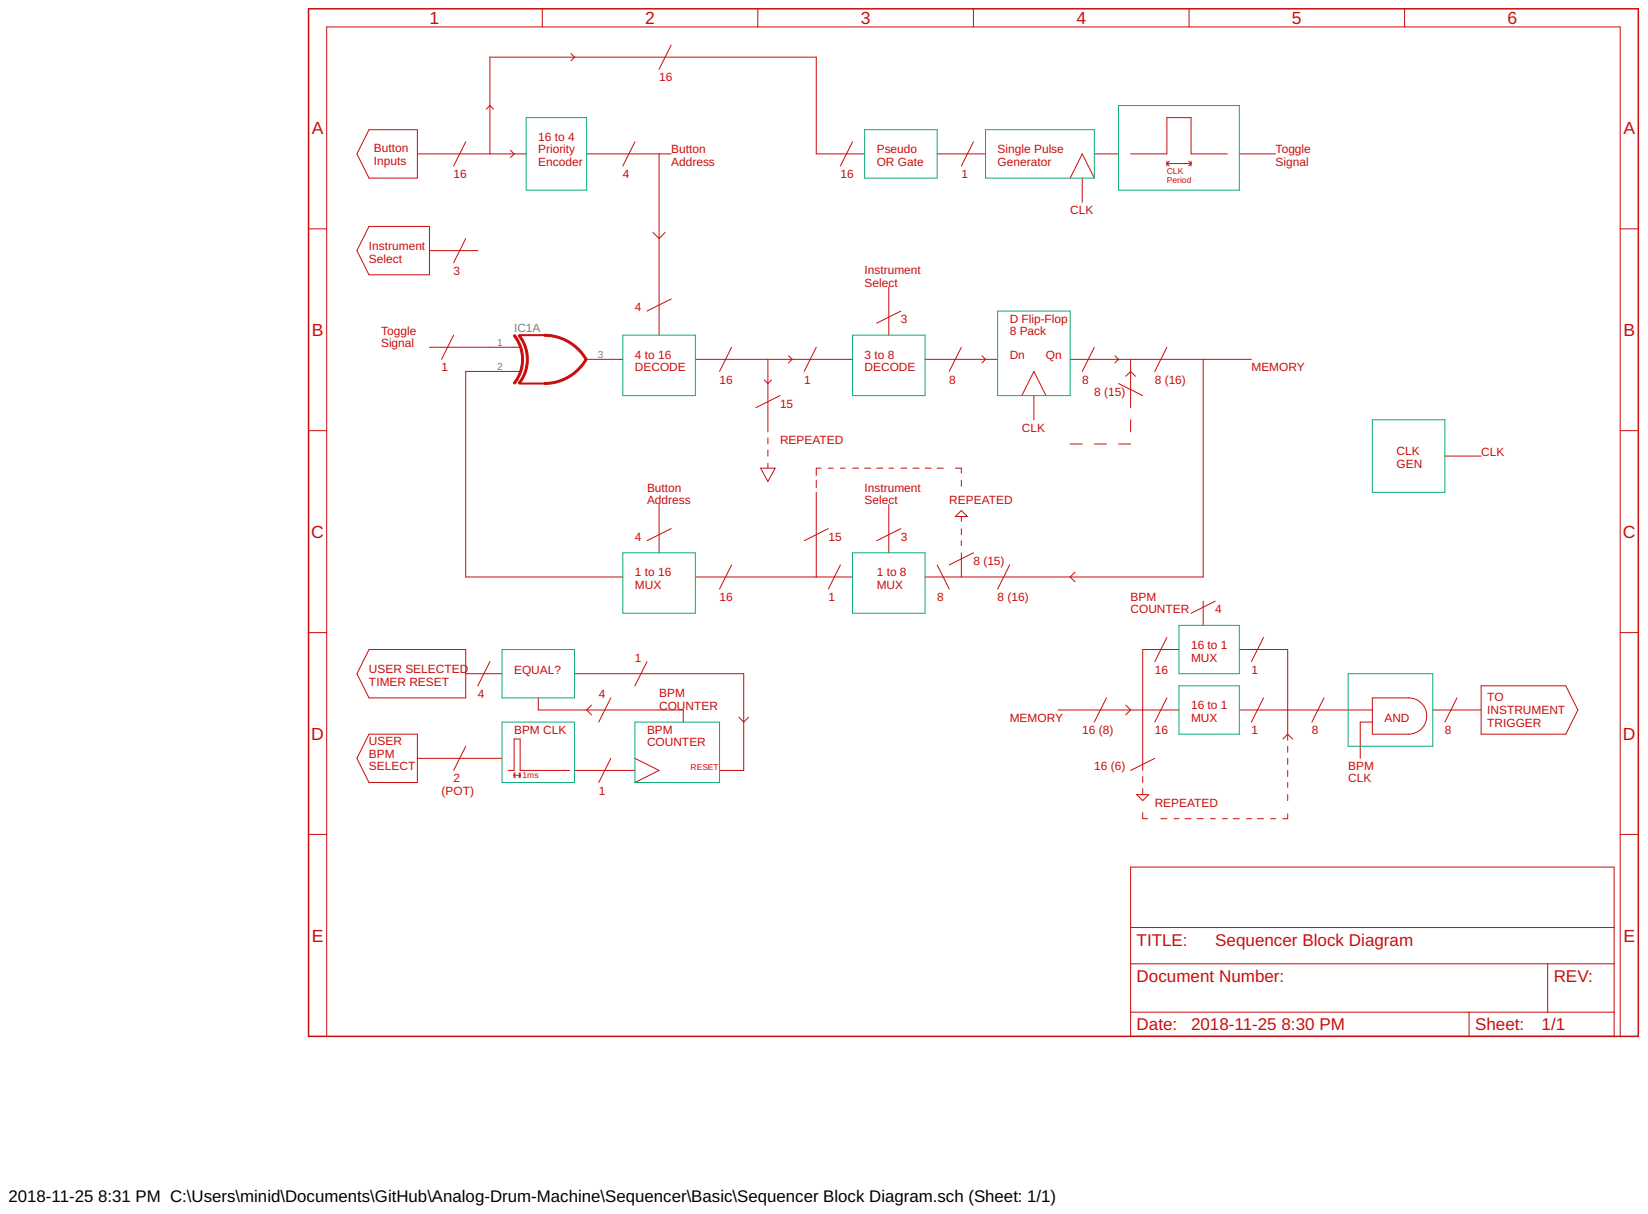
[picture p16: page 1]

Document Number: | REV:

Date: 2018-11-25 8:30 PM | Sheet: 1/1

2018-11-25 8:31 PM C:\Users\minid\Documents\GitHub\Analog-Drum-Machine\Sequencer\Basic\Sequencer Block Diagram.sch (Sheet: 1/1)
