kosikhar/Analog-Drum-Machine/Sequencer/Complex/Sequencer Block Diagram.pdf

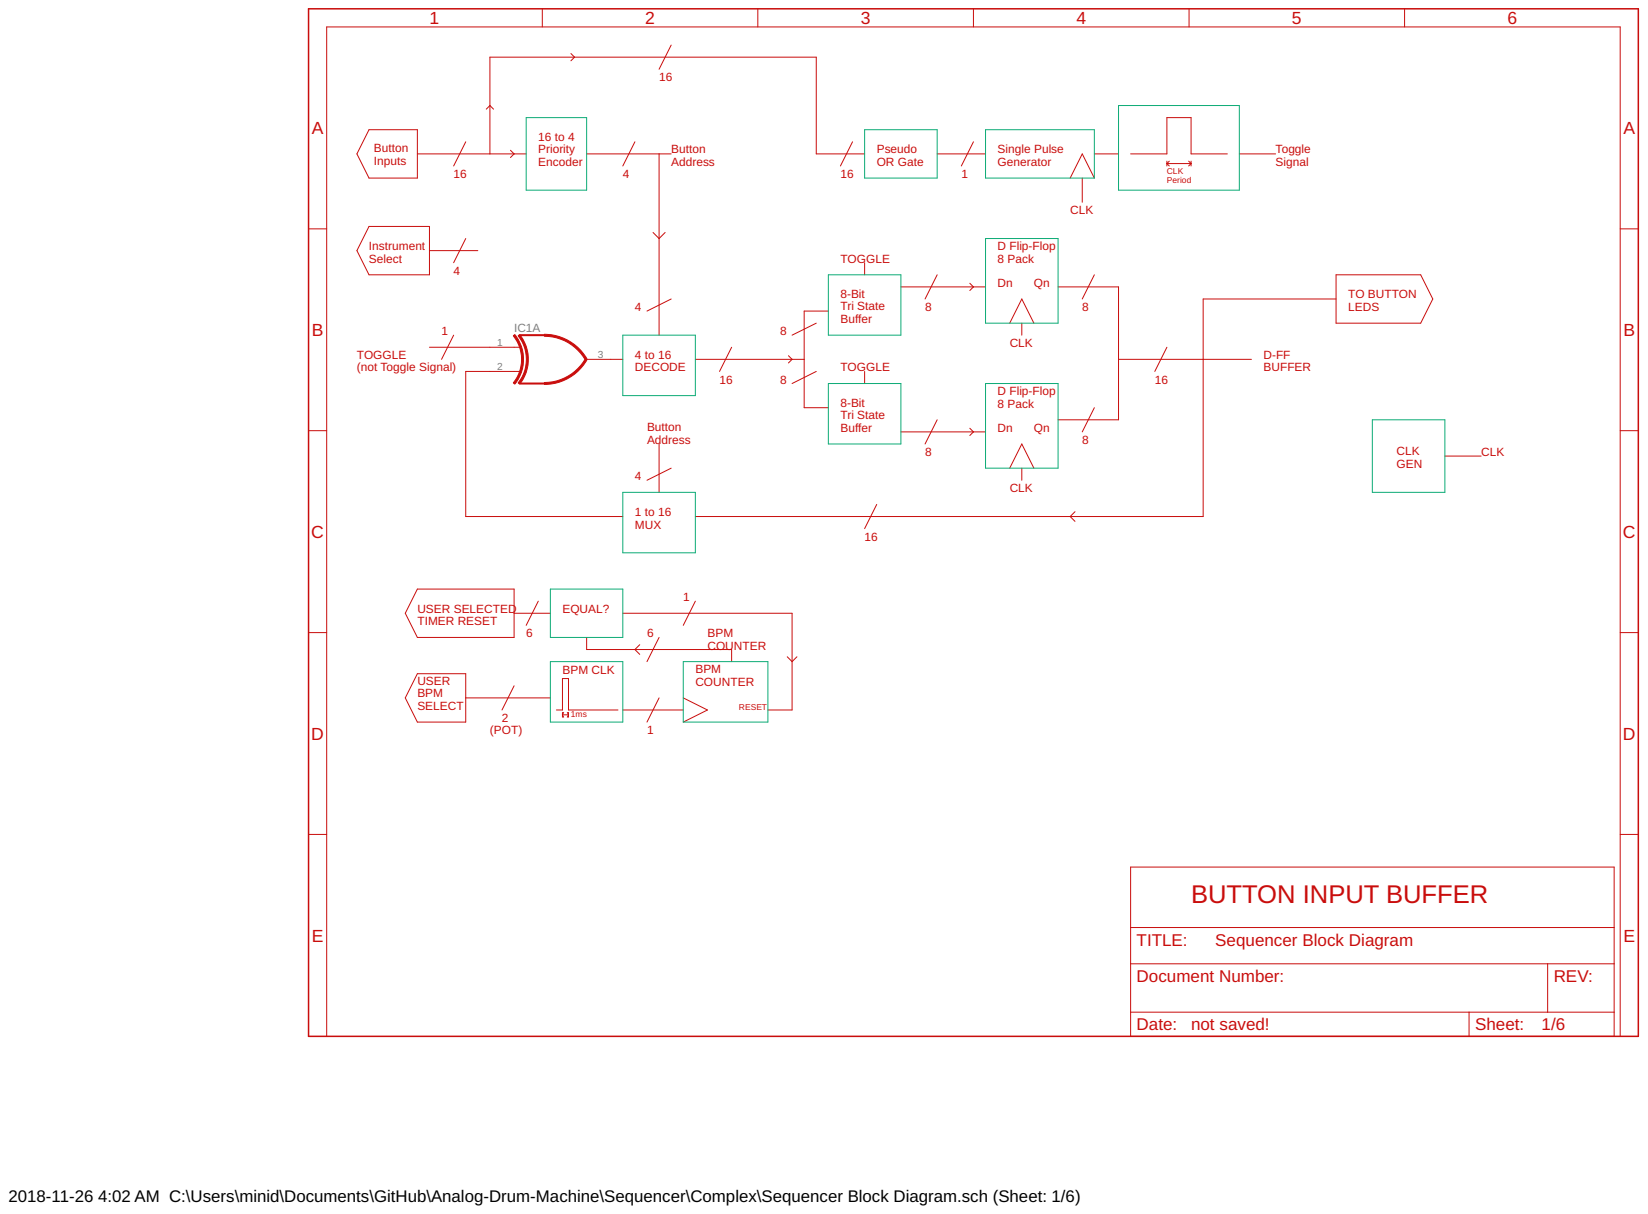
[picture p17: page 1]

Document Number: | REV:

Date: not saved! | Sheet: 1/6

2018-11-26 4:02 AM C:\Users\minid\Documents\GitHub\Analog-Drum-Machine\Sequencer\Complex\Sequencer Block Diagram.sch (Sheet: 1/6)

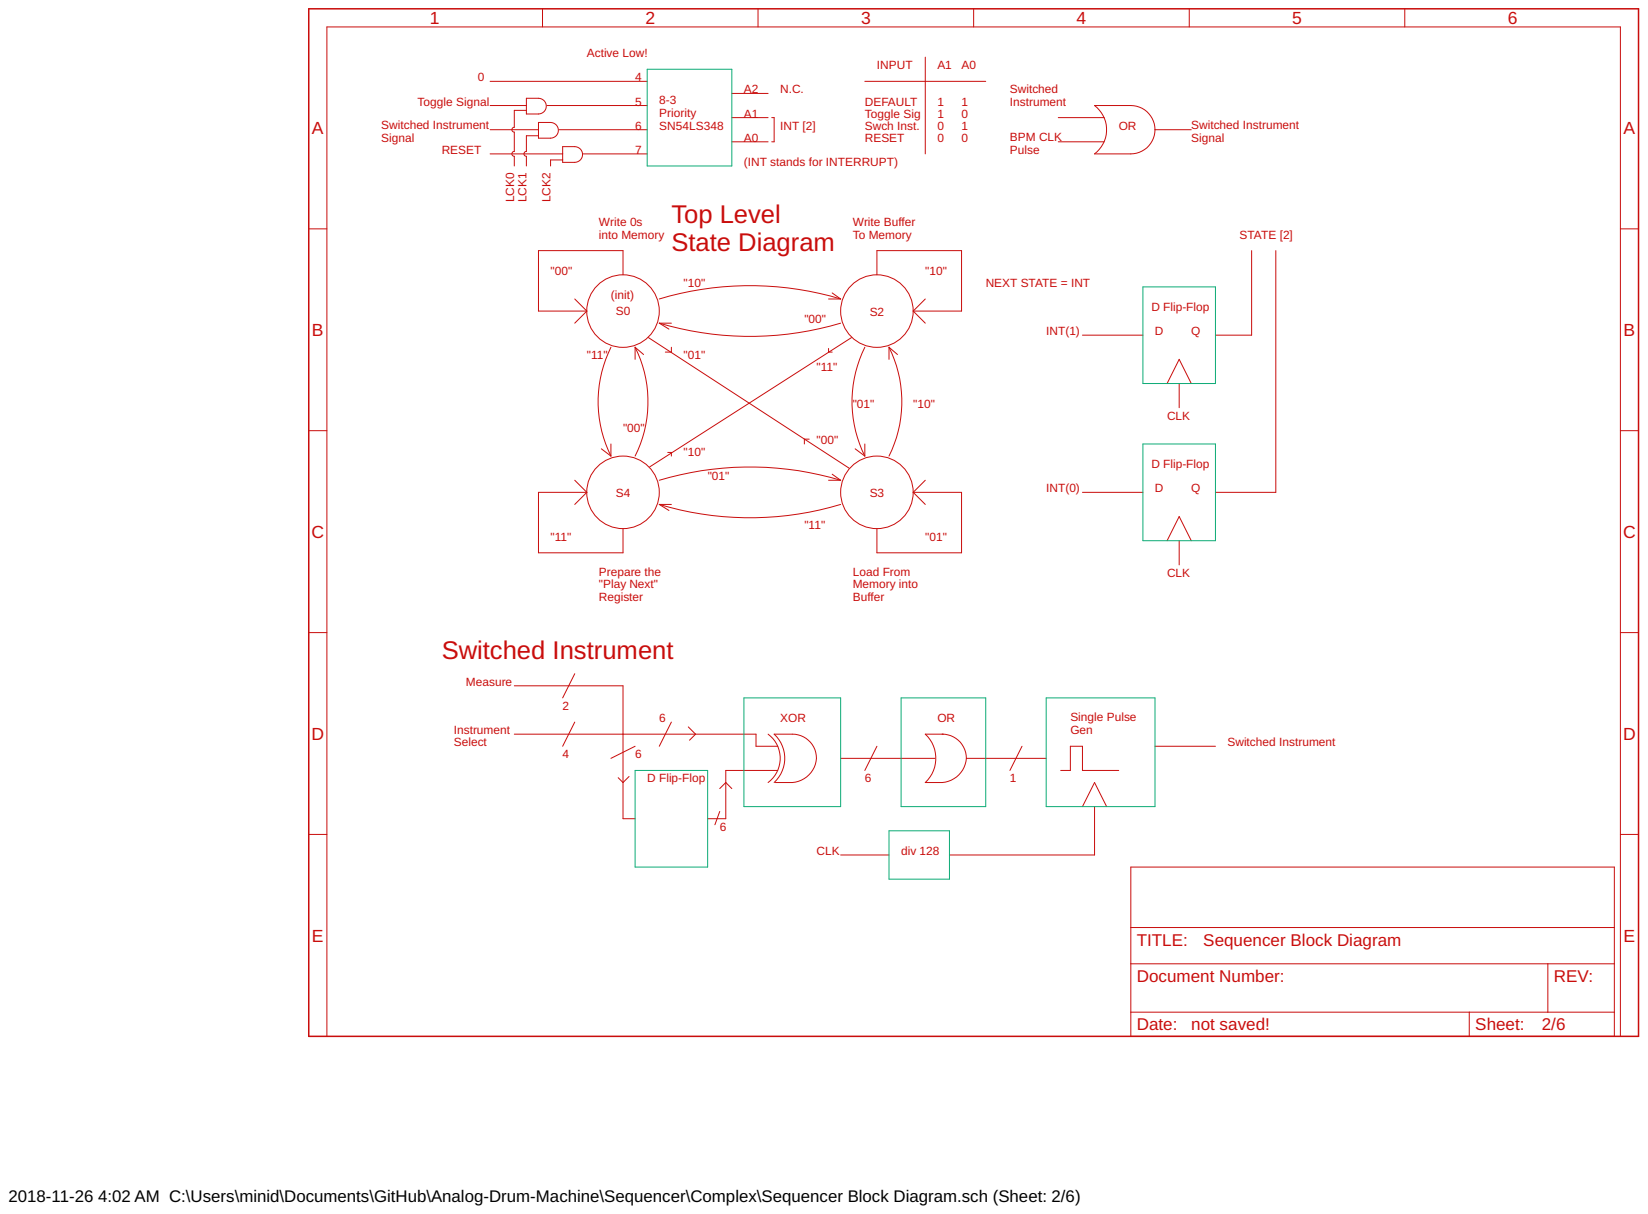
[picture p18: page 2]

Active Low!

(INT stands for INTERRUPT)

Write Buffer To Memory

Document Number: | REV:

Date: not saved! | Sheet: 2/6

2018-11-26 4:02 AM C:\Users\minid\Documents\GitHub\Analog-Drum-Machine\Sequencer\Complex\Sequencer Block Diagram.sch (Sheet: 2/6)

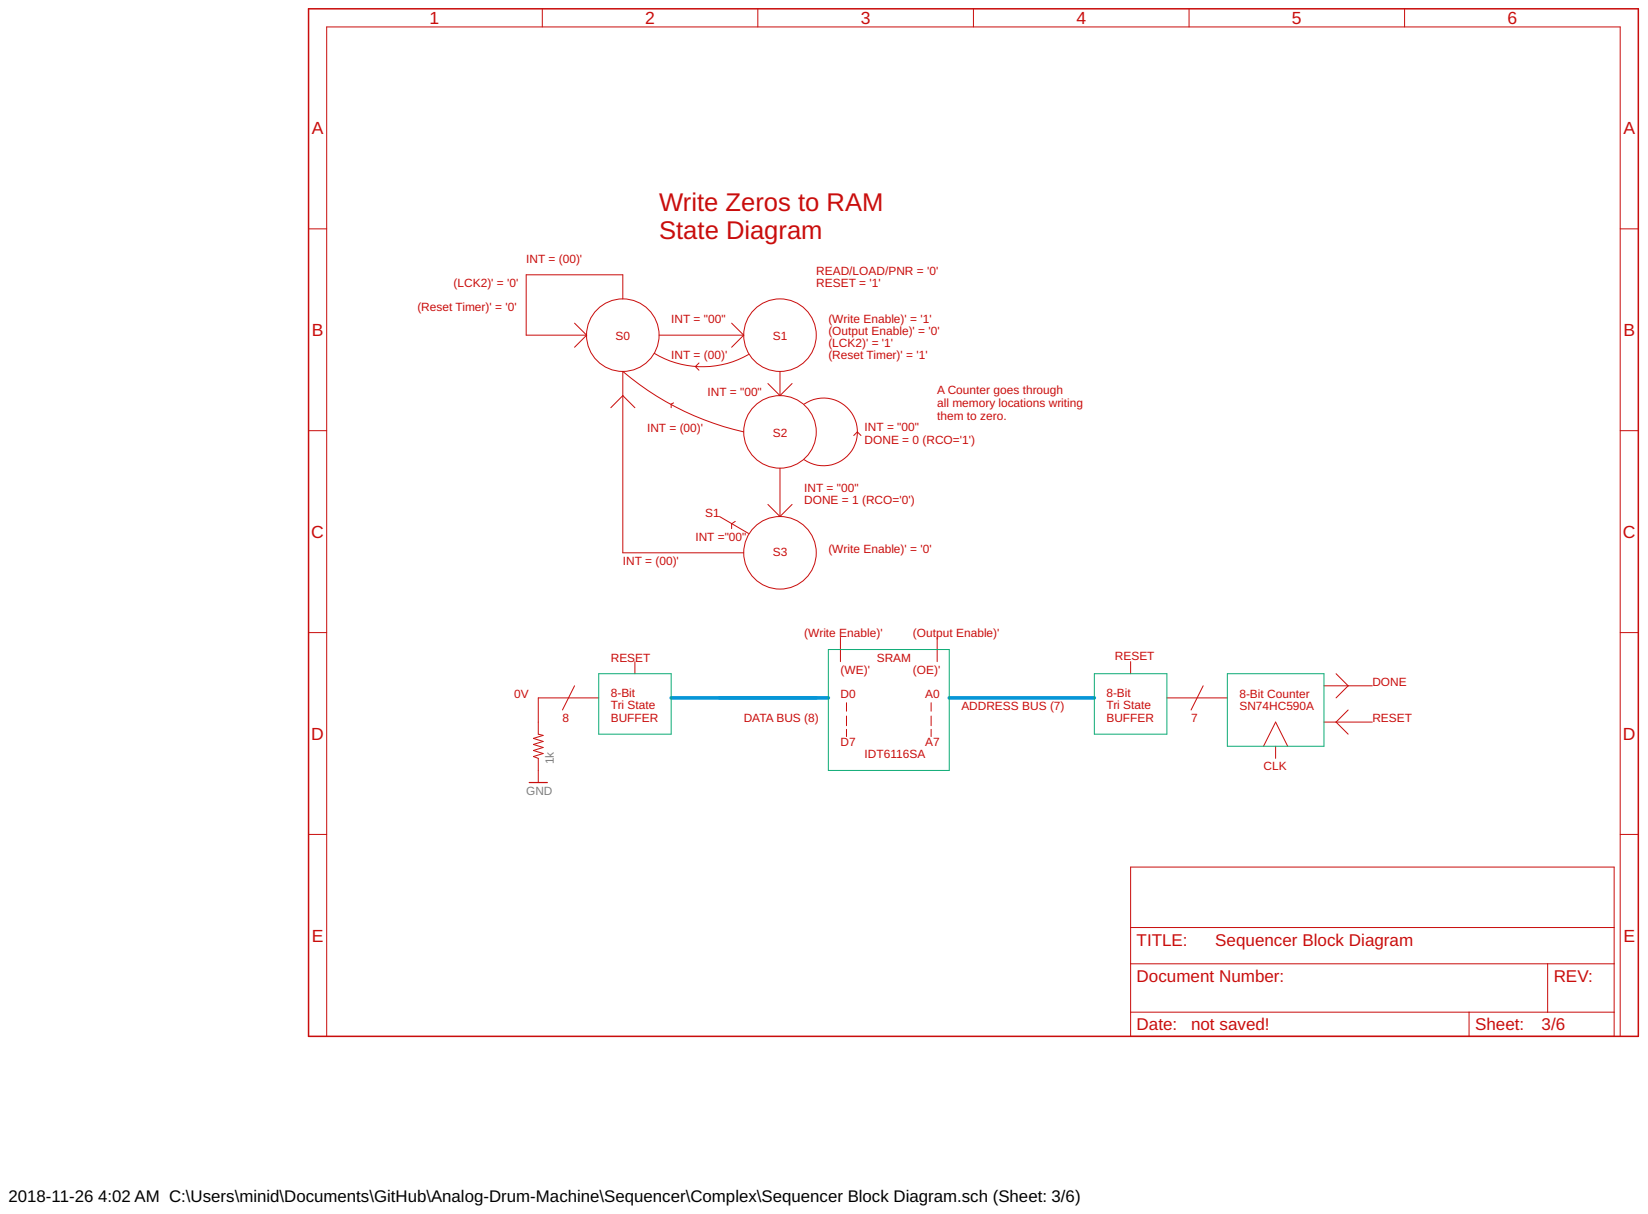
[picture p19: page 3]

READ/LOAD/PNR = '0' RESET = '1' (Write Enable)' = '1' (Output Enable)' = '0' (LCK2)' = '1' S2

all memory locations writing
them to zero.

Document Number: | REV:

Date: not saved! | Sheet: 3/6

2018-11-26 4:02 AM C:\Users\minid\Documents\GitHub\Analog-Drum-Machine\Sequencer\Complex\Sequencer Block Diagram.sch (Sheet: 3/6)

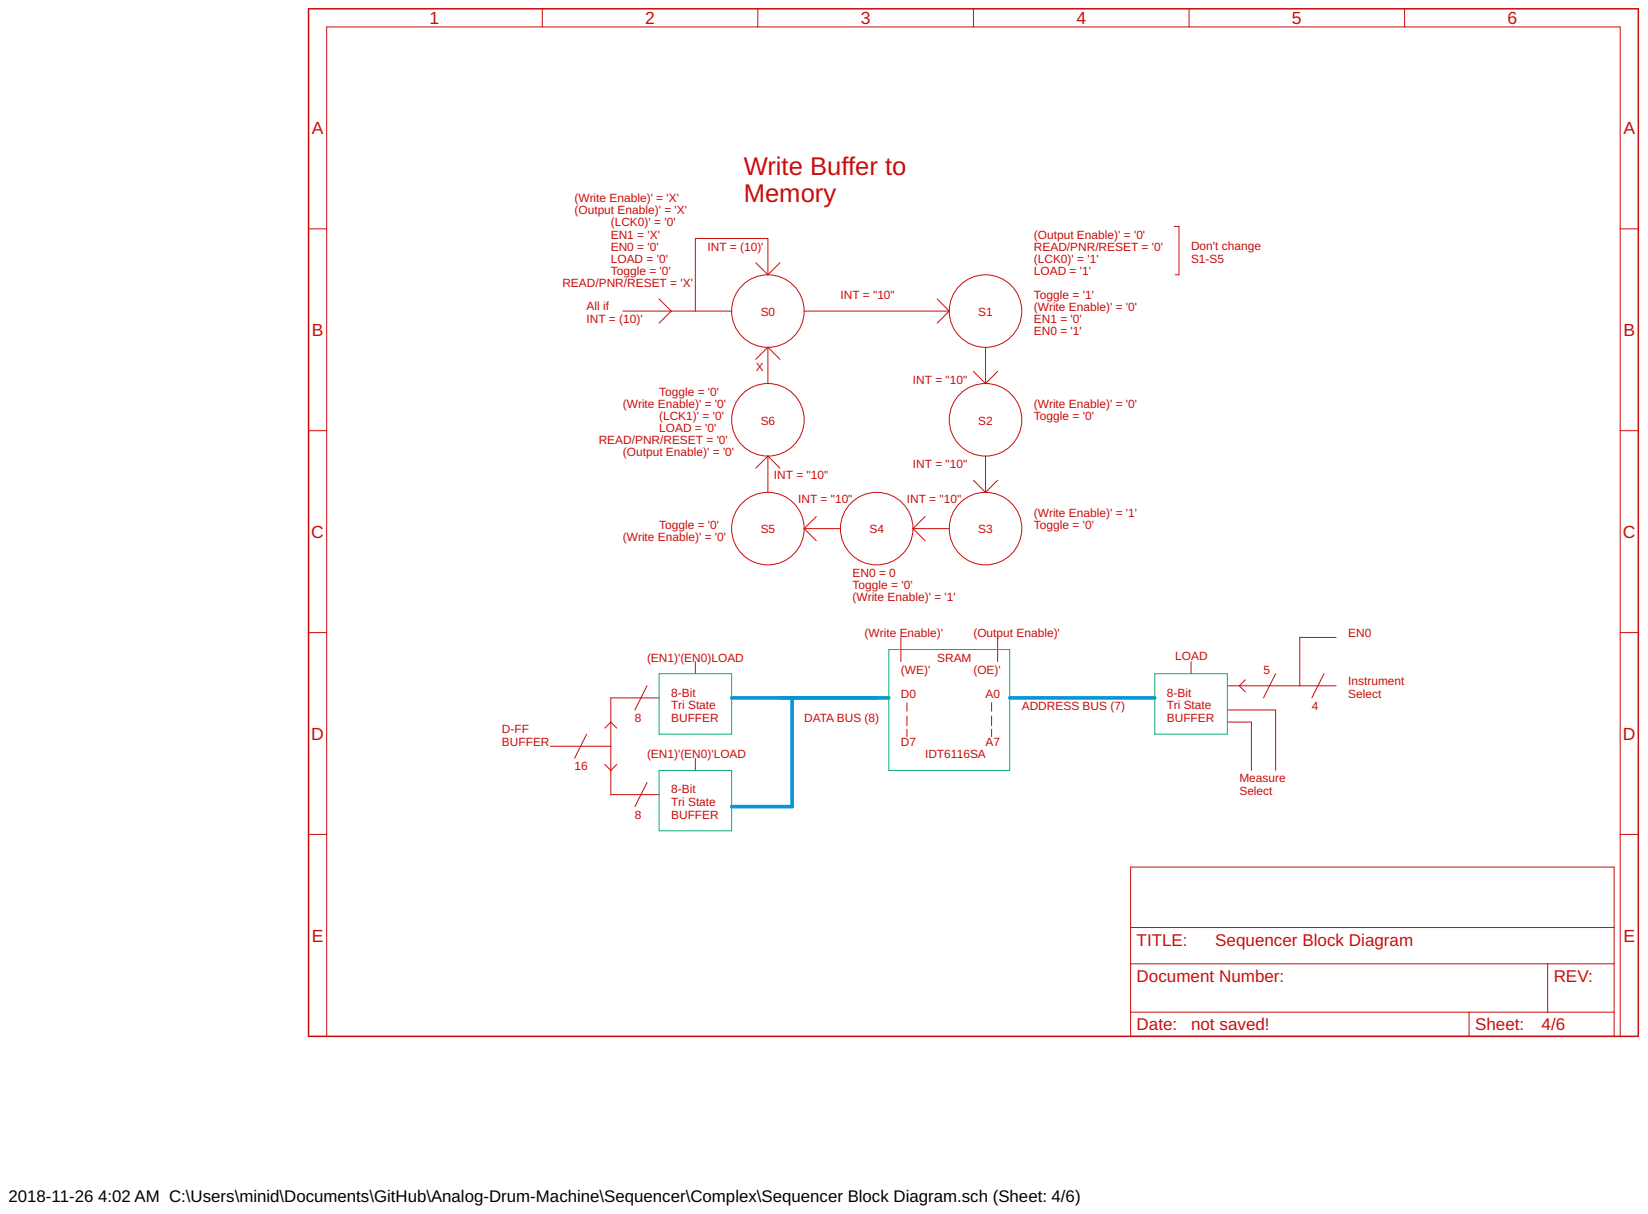
[picture p20: page 4]

(Write Enable)' = 'X' (Output Enable)' = 'X'

Toggle = '0' READ/PNR/RESET = 'X' EN1 = 'X' EN0 = '0'

(Output Enable)' = '0' READ/PNR/RESET = '0'

(Write Enable)' = '0' (LCK1)' = '0' LOAD = '0' READ/PNR/RESET = '0' (Output Enable)' = '0'

Document Number: | REV:

Date: not saved! | Sheet: 4/6

2018-11-26 4:02 AM C:\Users\minid\Documents\GitHub\Analog-Drum-Machine\Sequencer\Complex\Sequencer Block Diagram.sch (Sheet: 4/6)

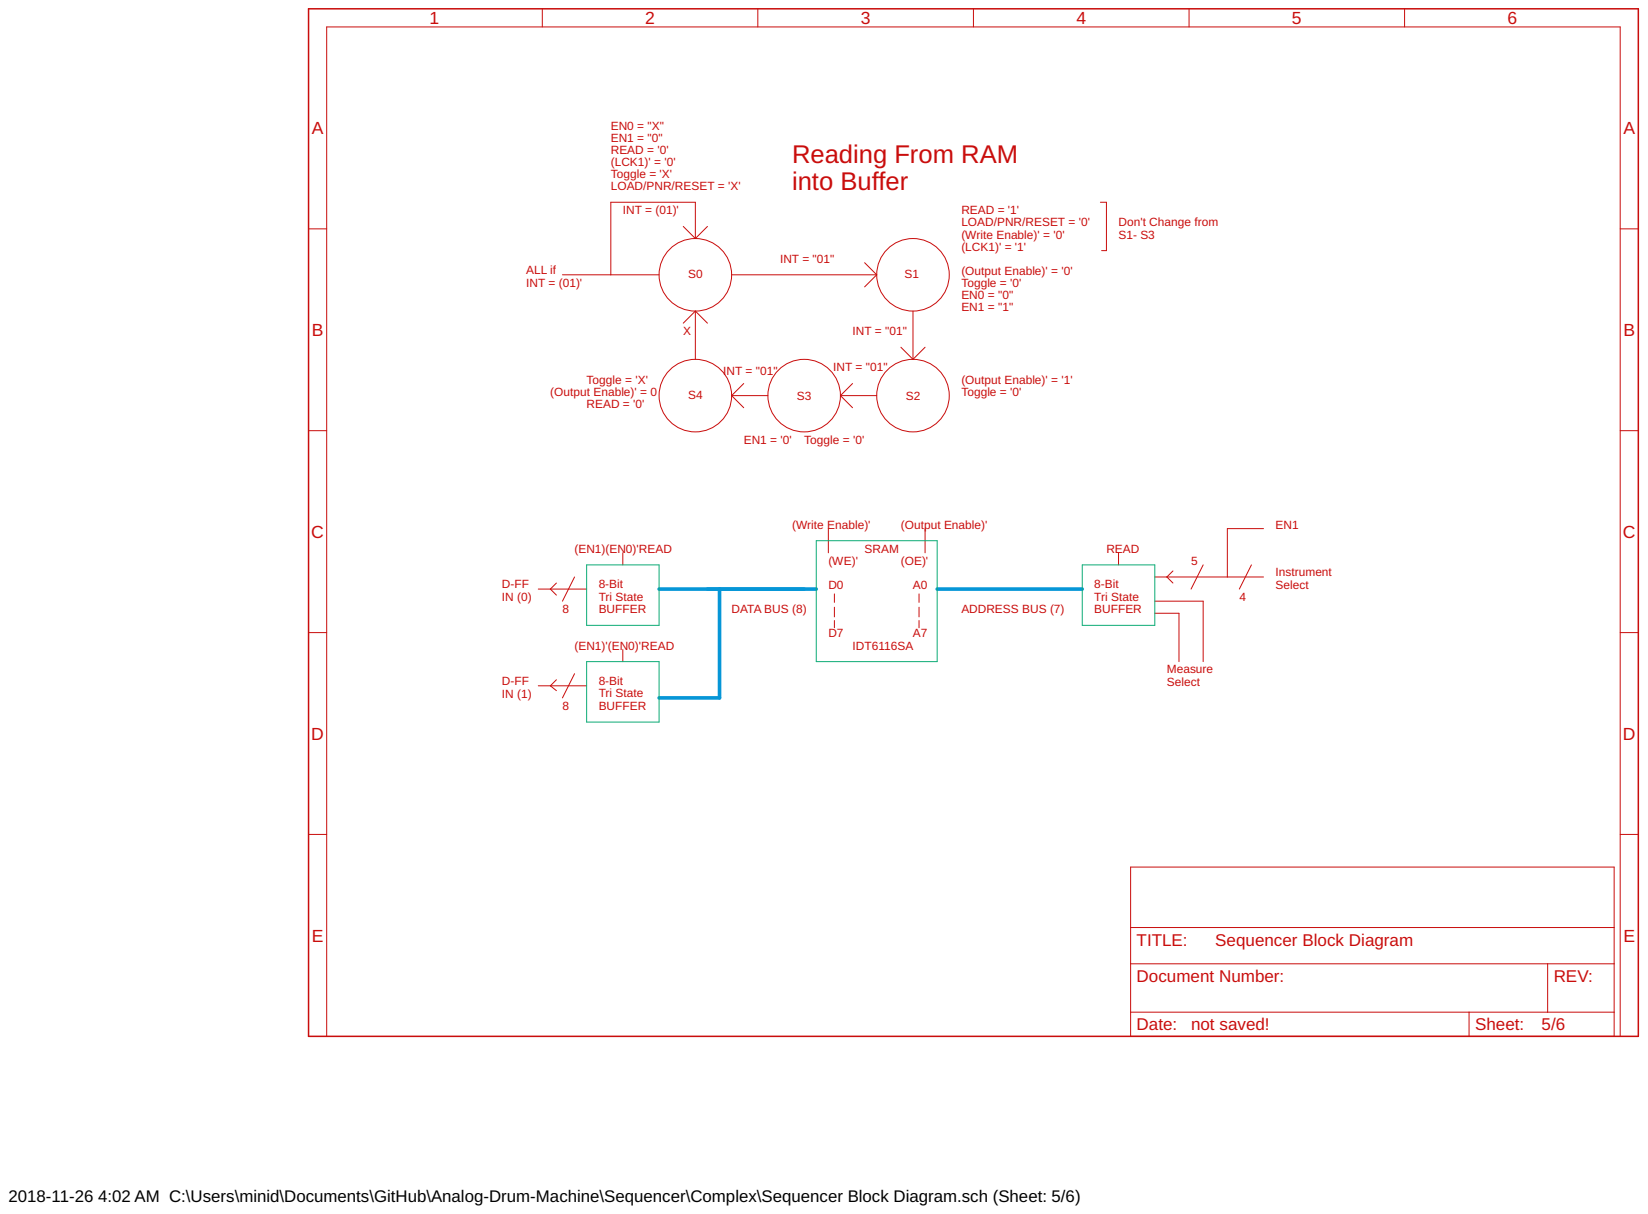
[picture p21: page 5]

READ = '0' (LCK1)' = '0' Toggle = 'X' LOAD/PNR/RESET = 'X' EN0 = "X" EN1 = "0"

READ = '1' Toggle = '0'
LOAD/PNR/RESET = '0' (Write Enable)' = '0' (Output Enable)' = '0' (LCK1)' = '1' EN0 = "0"

Document Number: | REV:

Date: not saved! | Sheet: 5/6

2018-11-26 4:02 AM C:\Users\minid\Documents\GitHub\Analog-Drum-Machine\Sequencer\Complex\Sequencer Block Diagram.sch (Sheet: 5/6)

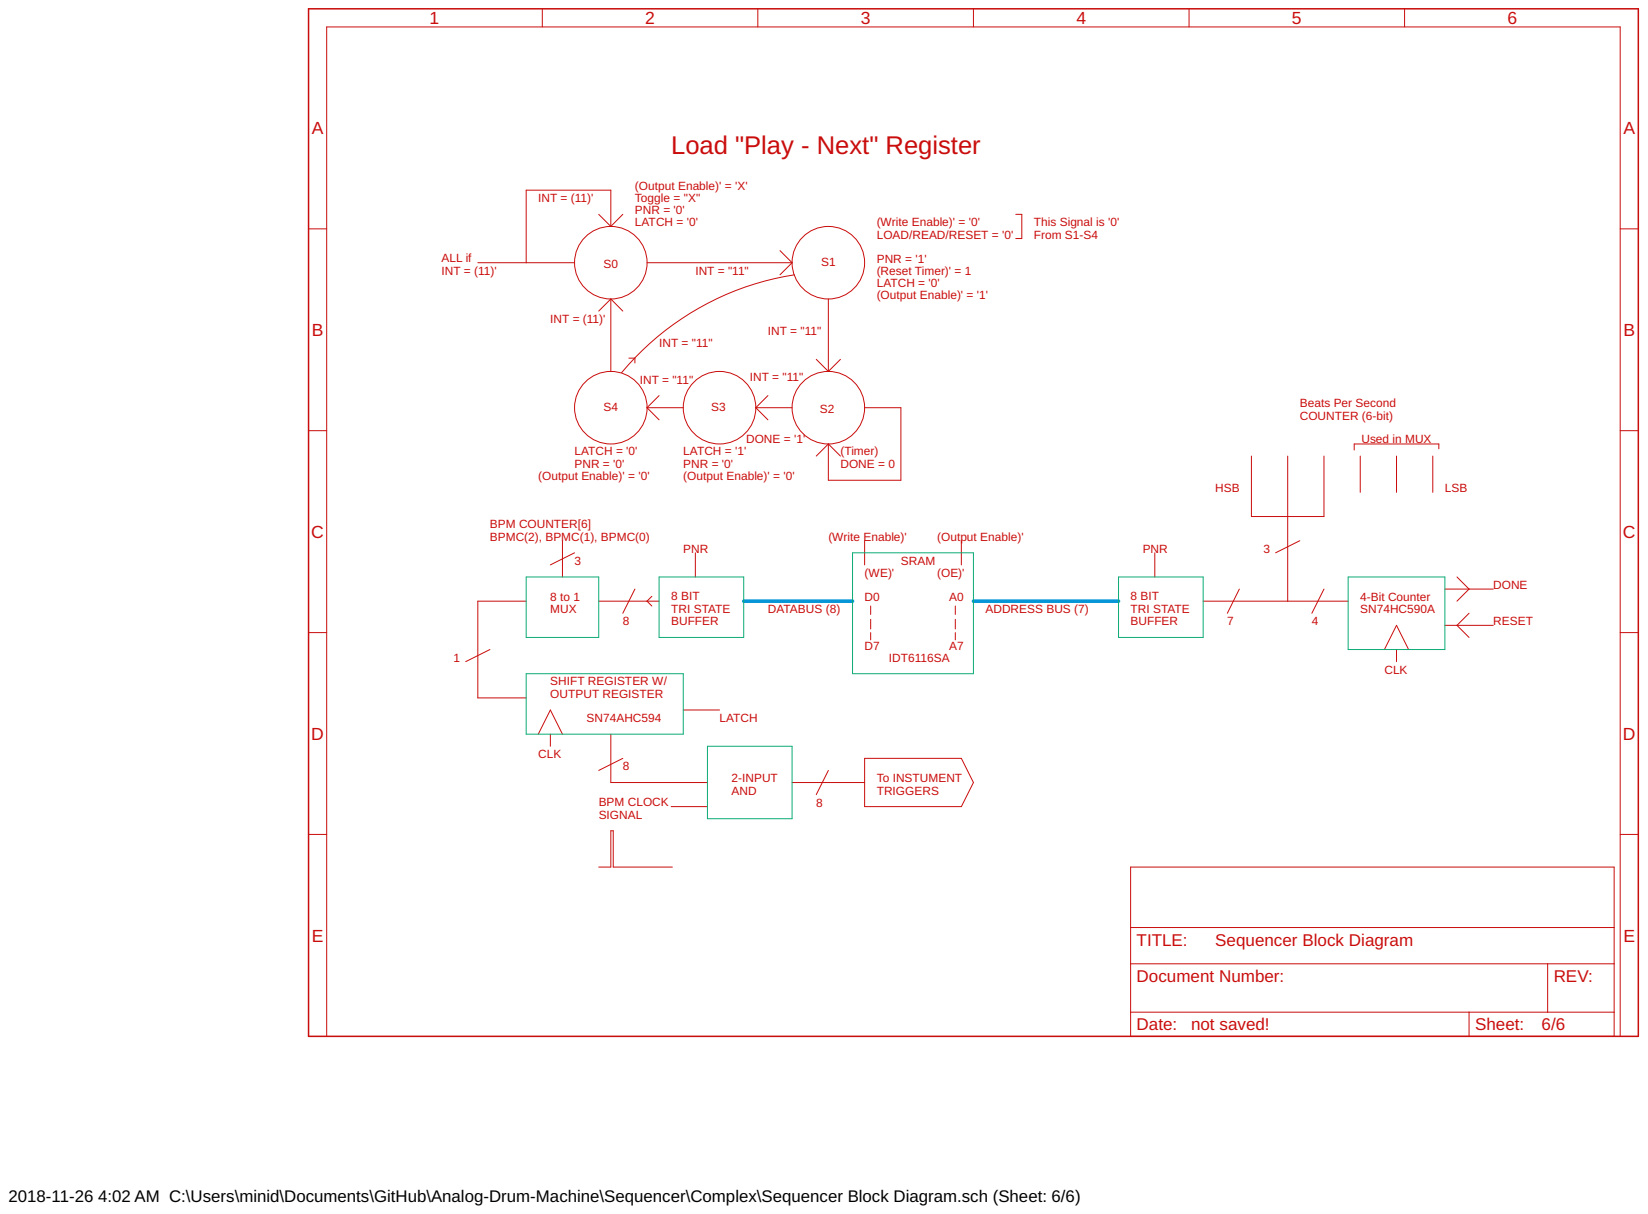
[picture p22: page 6]

Load "Play - Next" Register

This Signal is '0' From S1-S4

LATCH = '1' PNR = '0' LATCH = '0' PNR = '0'

Document Number: | REV:

Date: not saved! | Sheet: 6/6

2018-11-26 4:02 AM C:\Users\minid\Documents\GitHub\Analog-Drum-Machine\Sequencer\Complex\Sequencer Block Diagram.sch (Sheet: 6/6)
