kosikhar/Analog-Drum-Machine/Analog Drums/Simulation/monochrome.pdf

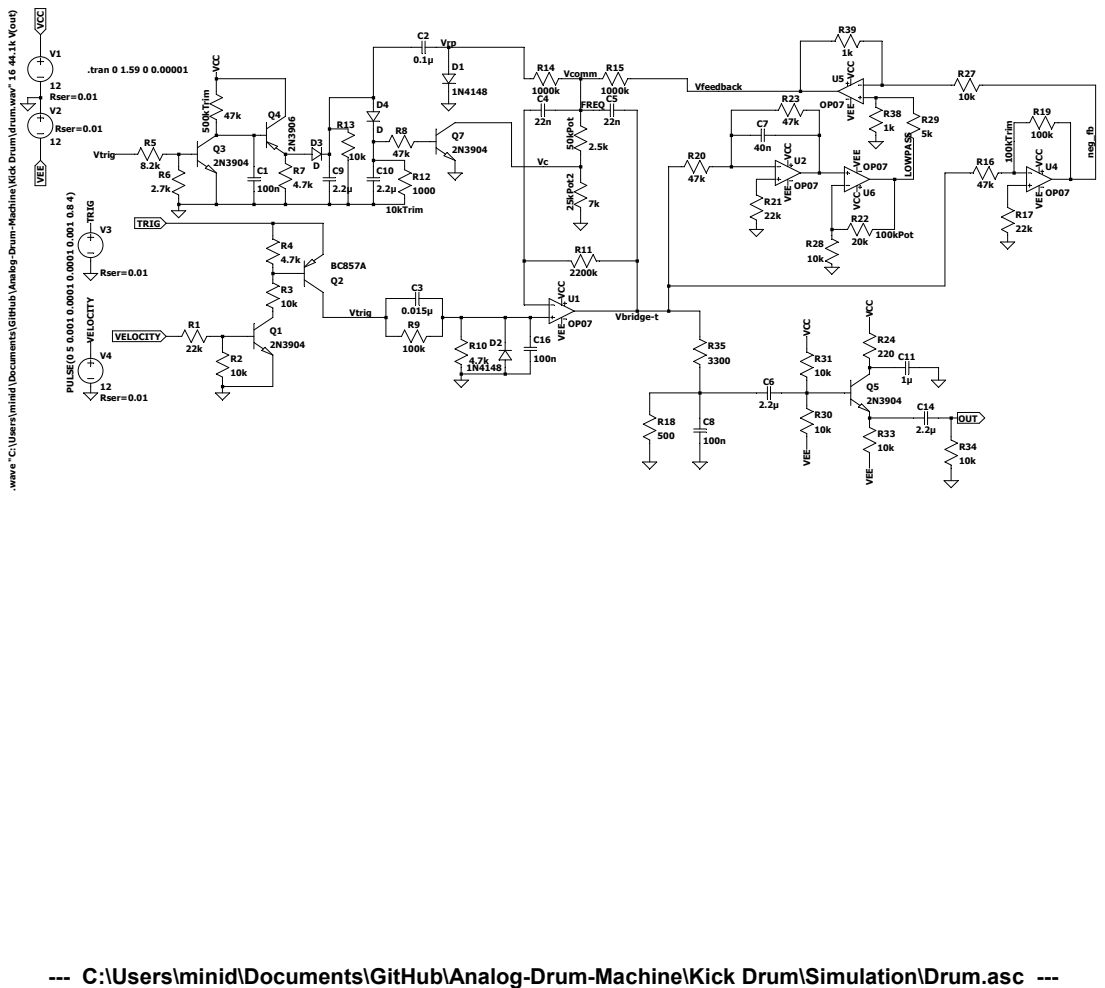
[picture p23: page 1]

--- C:\Users\minid\Documents\GitHub\Analog-Drum-Machine\Kick Drum\Simulation\Drum.asc ---
