kosikhar/Analog-Drum-Machine/Mixer/Draft1.asc

Q1: npn
R1: res; 4.7k
R2: res; 47k
R3: res; 1Meg
V1: voltage; PULSE(0 3.3 1 1m 1m 1 2 3)
V2: voltage; 3.3
Named nets: 0, LED-, 3V3
.tran 10
