kosikhar/Analog-Drum-Machine/Power Supply/12V Supply.asc

C1: cap; 6800µ
C2: cap; 6800µ
C3: cap; 1µ
C4: cap; 1µf
C8: cap; 100µ
C9: cap; 100µ
D1: diode; RR601BM4S
D2: diode; RR601BM4S
D3: diode; RR601BM4S
D4: diode; RR601BM4S
D5: zener; 1N750
D6: zener; 1N750
D8: zener; BZX84B9V1L
D9: zener; BZX84B9V1L
L1: ind2; 330µ
L2: ind2; 12.5µ
L3: ind2; 12.5µ
L4: ind; 47µ
L5: ind; 47µ
Q1: npn; KSC2331YTA
Q2: pnp; KSA596YTU
Q3: npn; KSD526YTU
Q4: pnp; KSA931YTA
R1: res; 0.1
R2: res; 1000
R3: res; 1k
R4: res; 1k
R6: res; 12
R9: res; 12
V1: voltage; SINE(0 169.7 60 0 0 0)
Named nets: 0, Xmfr_primary, Xfmr_secondary, Xmfr_sec_neg, rect_neg, rect_pos, +12V, -12V
K L1 L2 L3 1
.tran 0 0.5 0 0.001
.MODEL KSD526YTU AKO: 2SCR542P (Bf=15 Vceo=80)
.MODEL KSC2331YTA AKO: 2SCR514P (Bf=40 Vceo=60)
.MODEL KSA596YTU AKO: 2SAR542P (Bf=15 Vceo=80)
.MODEL KSA931YTA AKO: 2SAR514P (Bf=40 Vceo=60)
