kosikhar/Analog-Drum-Machine/Power Supply/5V Supply.asc

C1: cap; 10000µ
C3: cap; 1µ
C4: cap; 100µ
D1: diode; RR601BM4S
D2: diode; RR601BM4S
D3: diode; RR601BM4S
D4: diode; RR601BM4S
D5: zener; 5.1VZENER
D6: zener; 6.2VZener
L1: ind2; 1.5m
L2: ind2; 4.134µ
L4: ind; 47µ
Q1: npn; KSC2331YTA
Q2: npn; KSD526YTU
Q3: npn; KSC2331YTA
Q4: pnp; BC640TA
R1: res; 0.1
R2: res; 1000
R3: res; 100
R4: res; 200
R7: res; 5
U2: opamp2; uA741
V1: voltage; SINE(0 169.7 60 0 0 0)
V2: voltage; 12
V3: voltage; -12
Named nets: 0, Xmfr_primary, Xfmr_secondary, Xmfr_sec_neg, rect_neg, rect_pos, +12V, -12V, 5V, Vin
K L1 L2 1
.tran 0 0.1 0 0.001
.MODEL 5.1VZENER AKO: BZX84B6V2L (bv=5.1)
.inc uA741.sub
.MODEL 6.2VZener AKO: KDZ9_1B (bv=6.2)
.MODEL BC640TA AKO: 2SAR512P (bf=40 Vceo=80 icrating=1)
.MODEL KSD526YTU AKO: 2SCR542P (Bf=15 Vceo=80)
.MODEL KSC2331YTA AKO: 2SCR514P (Bf=40 Vceo=60)
