kosikhar/Analog-Drum-Machine/Power Supply/Power Supply V2.asc

C1: cap; 10000µ
C2: cap; 10000µ
C3: cap; 1µ
C4: cap; 1µf
C5: cap; 50µ
C6: cap; 10µ
C7: cap; 1µ
D1: diode; RR601BM4S
D2: diode; RR601BM4S
D3: diode; RR601BM4S
D4: diode; RR601BM4S
D5: zener; 1N750
D6: zener; 1N750
D7: zener; 5.1VZENER
D8: zener; BZX84B9V1L
D9: zener; BZX84B9V1L
D10: zener; 6.2VZener
D11: diode; RR2L4S
L1: ind2; 330µ
L2: ind2; 12.5µ
L3: ind2; 12.5µ
L4: ind; 47µ
L5: ind; 47µ
Q1: npn; KSC2331YTA
Q2: pnp; KSA596YTU
Q3: npn; KSD526YTU
Q4: pnp; KSA931YTA
Q5: npn; KSC2331YTA
Q6: npn; KSD526YTU
Q7: pnp; SS8550DTA
Q8: pnp; SS8550DTA
R1: res; 0.1
R2: res; 1000
R3: res; 1k
R4: res; 1k
R5: res; 240
R6: res; 12
R7: res; 600
R9: res; 12
R10: res; 1250
R11: res; 50
R12: res; 3.33
U1: LT1001
V1: voltage; SINE(0 169.7 60 0 0 0)
Named nets: 0, Xmfr_primary, Xfmr_secondary, Xmfr_sec_neg, rect_neg, rect_pos, +12V, -12V, 5V
K L1 L2 L3 1
.tran 0 0.05 0 0.001
.MODEL KSD526YTU AKO: 2SCR542P (Bf=15 Vceo=80)
.MODEL KSC2331YTA AKO: 2SCR514P (Bf=40 Vceo=60)
.MODEL 5.1VZENER AKO: 1N750 (bv=5.1)
.MODEL KSA596YTU AKO: 2SAR542P (Bf=15 Vceo=80)
.MODEL KSA931YTA AKO: 2SAR514P (Bf=40 Vceo=60)
.MODEL 6.2VZener AKO: KDZ9_1B (bv=6.2)
.MODEL SS8550DTA AKO: 2SAR512P (bf=40 Vceo=25 icrating=1.5)
