kosikhar/Analog-Drum-Machine/Power Supply/Power Supply.asc

C1: cap; 3300µ
C2: cap; 3300µ
C3: cap; 3300µ
C4: cap; 3300µ
C5: cap; 1000µ
D1: schottky; PDS5100
D2: schottky; PDS5100
D3: schottky; PDS5100
D4: schottky; PDS5100
D5: zener; KDZ20B
D6: zener; KDZ15B
L1: ind2; 330µ
L2: ind2; 100µ
L3: ind2; 100µ
L4: ind; 47µ
L5: ind; 47µ
Q1: npn; 2N3904
Q2: npn; ZTX1048A
Q3: npn; 2N3904
Q4: npn; ZTX1048A
Q5: npn; 2N3904
Q6: npn; ZTX1048A
R1: res; 0.1
R2: res; 1000
R3: res; 1000
R4: res; 1000
R5: res; 100
R6: res; 1000
R7: res; 10
R8: res; 1000
R9: res; 100
R10: res; 10
U1: OP07
U2: OP07
V1: voltage; SINE(0 169.7 60 0 0 0)
Named nets: 0, Xmfr_primary, Xfmr_secondary, Xmfr_sec_neg, rect_neg, rect_pos, LC_rect_pos, LC_rect_neg, stg1_pos, stg2_pos, stg3_pos
K L1 L2 L3 1
.tran 0 1 0.1 0.001
