kosikhar/Analog-Drum-Machine/Kick Drum/Drum.asc

C1: cap; 10µ
C2: cap; 0.033µ
C3: cap; 0.015µ
C4: cap; 0.02µ
C5: cap; 0.02µ
C6: cap; 1µ
C7: cap; 0.1µ
C8: cap; 0.94µ
C9: cap; 20µ
C10: cap; 30µ
D1: diode; 1N4148
D2: diode; 1N4148
Q1: npn; BC547B
Q2: pnp; BC857A
Q3: npn; BC547B
Q4: npn; BC547B
Q5: npn; BC547B
Q6: npn; BC547B
Q7: npn; BC547B
R1: res; 22k
R2: res; 10k
R3: res; 10k
R4: res; 4.7k
R5: res; 8.2k
R6: res; 2.7k
R7: res; 100k
R8: res; 10k
R9: res; 100k
R10: res; 4.7k
R11: res; 1000k
R12: res; 5k
R13: res; 20k
R14: res; 1000k
R15: res; 470k
R16: res; 220
R17: res; 5k
R18: res; 10k
R19: res; 5k
R20: res; 47k
R21: res; 22k
R22: res; 200k
R23: res; 47k
R24: res; 5k
R25: res; 5k
R26: res; 5k
R27: res; 22k
R28: res; 10k
R29: res; 5k
R30: res; 10k
R31: res; 10k
U1: OP07
U2: OP07
U3: OP07
V1: voltage; 15; Rser=0.01
V2: voltage; 15; Rser=0.01
V3: voltage; PULSE(0 5 0.001 0.001 0.001 0.01 0.8 4); Rser=0.01
V4: voltage; 10; Rser=0.01
Named nets: VEE, VCC, 0, TRIG, VELOCITY, Vtrig, Venvelope, Vrp, Vbridge-t, Vcomm, Vc, Vlevel, Vtone, OUT, Vfeedback, DECAY, LOWPASS, FREQ
.wave "H:\\My Drive\\Random\\LT Spice\\808\\kickdrum\\drum.wav" 16 44.1k V(out)
.tran 0 4 0 0.00001
