kosikhar/Analog-Drum-Machine/Mixer/LTspice Files/Combined Stages.asc

C1: cap; 60p
C3: cap; 2.2µ
C5: cap; 0.1µ
C6: cap; 0.1µ
C8: cap; 1µ
C9: cap; 2.2µ
C10: cap; 2.2µ
C11: cap; 1µ
C12: cap; 2.2µ
C13: cap; 2.2µ
C14: cap; 1µ
C15: cap; 2.2µ
C16: cap; 4.7µ
C17: cap; 1µ
C18: cap; 4.7µ
C19: cap; 2.2µ
C20: cap; 1µ
C21: cap; 2.2µ
C22: cap; 2.2µ
C23: cap; 1µ
C24: cap; 2.2µ
C25: cap; 2.2µ
C26: cap; 1µ
C27: cap; 2.2µ
C28: cap; 2.2µ
C29: cap; 1µ
C30: cap; 2.2µ
D1: zener; BZX84B9V1L
D2: zener; BZX84B9V1L
Q1: npn; 2N3904
Q3: npn; 2N3904
Q4: npn; 2N3904
Q5: npn; 2N3904
Q6: npn; 2N3904
Q7: npn; 2N3904
Q8: npn; 2N3904
Q9: npn; 2N3904
R1: res; 240k
R2: res; 221
R3: res; 47k
R5: res; 47k
R6: res; 47k
R7: res; 47k
R8: res; 47k
R9: res; 47k
R10: res; 47k
R11: res; 10k
R12: res; 10k
R13: res; 100
R14: res; 2.2k
R15: res; 47k
R16: res; 47k
R18: res; 22k
R20: res; 10k
R21: res; 47k
R22: res; 47k
R23: res; 47k
R24: res; 10k
R25: res; 10k
R26: res; 220
R27: res; 10k
R28: res; 10k
R29: res; 220
R30: res; 10k
R31: res; 10k
R32: res; 10k
R33: res; 220
R34: res; 10k
R35: res; 10k
R36: res; 10k
R37: res; 220
R38: res; 10k
R39: res; 10k
R40: res; 10k
R41: res; 220
R42: res; 10k
R43: res; 10k
R44: res; 10k
R45: res; 220
R46: res; 10k
R47: res; 10k
R48: res; 10k
R49: res; 220
R50: res; 10k
U1: potentiometer_standard; Rtot=50K wiper=1; ""
U2: opamp2; uA741
U4: potentiometer_standard; Rtot=50K wiper=1; ""
U5: potentiometer_standard; Rtot=50K wiper=1; ""
U6: potentiometer_standard; Rtot=50K wiper=1; ""
U7: potentiometer_standard; Rtot=50K wiper=1; ""
U8: potentiometer_standard; Rtot=50K wiper=1; ""
U9: potentiometer_standard; Rtot=50K wiper=1; ""
U10: potentiometer_standard; Rtot=50K wiper=1; ""
V2: voltage; SINE(0 1 10)
V3: voltage; SINE(0 1 60)
V4: voltage; 12V
V5: voltage; 12V
V6: voltage; SINE(0 1 60)
V7: voltage; SINE(0 1 60)
V8: voltage; SINE(0 1 60)
V9: voltage; SINE(0 1 60)
V10: voltage; SINE(0 1 60)
Named nets: 0, vdd!, -vdd!, Vout, 3, 4, 5, 6, 7, 8
.inc uA741.sub
.wav "C:\\Users\\b59mi\\Documents\\Business\\4th Year Engineering\\Semester 1\\ECE490\\Analog-Drum-Machine\\Mixer\\Preamp.wav" 16 44100 Vout
;ac dec 1 1 100k
.tran 1s
