kosikhar/Analog-Drum-Machine/Cowbell/Ltspice Files/Cowbell.asc

C1: cap; 4.7µ
C2: cap; 0.0022µ
C3: cap; .01µ
C4: cap; 2.2µ
C5: cap; 1µ
C6: cap; 4.7µ
C7: cap; .0022µ
C8: cap; .0033µ
C9: cap; 1µ
C10: cap; .47µ
C11: cap; 0.1µ
C12: cap; 0.1µ
C13: cap; 0.1µ
C14: cap; 0.1µ
C15: cap; 2.2µ
D1: diode; 1n4148
D2: diode; 1n4148
D3: diode; 1n4148
Q1: npn; Q2N3904
Q2: npn; Q2N3904
Q3: pnp; 2N3906
Q4: npn; Q2N3904
Q5: npn; 2N3904
Q6: npn; 2N3904
Q7: npn; 2N3904
Q8: npn; 2N3904
Q9: npn; 2N3904
R1: res; 33k
R2: res; 1.8k
R3: res; 470k
R4: res; 100
R5: res; 10k
R6: res; 2.2k
R7: res; 470k
R8: res; 10k
R9: res; 10k
R10: res; 33k
R11: res; 1.8k
R12: res; 470k
R13: res; 100
R14: res; 100k
R15: res; 100k
R16: res; 10k
R18: res; 1k
R19: res; 22k
R20: res; 4.7k
R21: res; 22k
R22: res; 10k
R23: res; 470
R24: res; 470
R25: res; 8.2k
R26: res; 8.2k
R27: res; 470
R28: res; 470
R29: res; 12k
R30: res; 12k
R31: res; 100
R32: res; 2.47k
U1: opamp2; uA741
U2: potentiometer_standard; Rtot=50K wiper=.5; ""
U3: potentiometer_standard; Rtot=50K wiper=.5; ""
U4: potentiometer_standard; Rtot=50K wiper=0.5; ""
V4: voltage; PULSE(0 5 1s 50p 50p 1m 1.001)
V5: voltage; 12
V6: voltage; 12
V7: voltage; 5
V8: voltage; 5
Named nets: 0, pos, neg, Vout
.inc Q2N3904.lib
Special thanks to Kurt James Werner for making the original TR808
Cowbell circuit from the service manual easier to read!
.inc 1n4148.sub
.inc uA741.sub
.tran 0 5 0.5
.wave output.wav 16 44.1K Vout
Trigger Logic
.inc 2N3906.lib
Oscillator 2: 800Hz
Oscillator 1: 540 Hz
