kosikhar/Analog-Drum-Machine/Analog Drums/Simulation/Drum.asc

25kPot2: res; 7k
50kPot: res; 2.5k
500kTrim: res; 47k
C1: cap; 100n
C2: cap; 0.1µ
C3: cap; 0.015µ
C4: cap; 22n
C5: cap; 22n
C6: cap; 2.2µ
C7: cap; 40n
C8: cap; 100n
C9: cap; 2.2µ
C10: cap; 2.2µ
C11: cap; 1µ
C14: cap; 2.2µ
C16: cap; 100n
D1: diode; 1N4148
D2: diode; 1N4148
D3: diode
D4: diode
Q1: npn; 2N3904
Q2: pnp; BC857A
Q3: npn; 2N3904
Q4: pnp; 2N3906
Q5: npn; 2N3904
Q7: npn; 2N3904
R1: res; 22k
R2: res; 10k
R3: res; 10k
R4: res; 4.7k
R5: res; 8.2k
R6: res; 2.7k
R7: res; 4.7k
R8: res; 47k
R9: res; 100k
R10: res; 4.7k
R11: res; 2200k
R12: res; 1000
R13: res; 10k
R14: res; 1000k
R15: res; 1000k
R16: res; 47k
R17: res; 22k
R18: res; 500
R19: res; 100k
R20: res; 47k
R21: res; 22k
R22: res; 20k
R23: res; 47k
R24: res; 220
R27: res; 10k
R28: res; 10k
R29: res; 52k
R30: res; 10k
R31: res; 10k
R33: res; 10k
R34: res; 10k
R35: res; 3300
R38: res; 1k
R39: res; 1k
U1: OP07
U2: OP07
U4: OP07
U5: OP07
U6: OP07
V1: voltage; 12; Rser=0.01
V2: voltage; 12; Rser=0.01
V3: voltage; PULSE(0 5 0.001 0.0001 0.0001 0.001 0.8 4); Rser=0.01
V4: voltage; 12; Rser=0.01
Named nets: VEE, VCC, 0, TRIG, VELOCITY, Vtrig, Vrp, Vbridge-t, Vcomm, Vc, OUT, Vfeedback, LOWPASS, FREQ, neg_fb, 10kTrim, 100kPot, 100kTrim
.wave "C:\\Users\\minid\\Documents\\GitHub\\Analog-Drum-Machine\\Kick Drum\\drum.wav" 16 44.1k V(out)
.tran 0 1.59 0 0.00001
