kosikhar/Analog-Drum-Machine/Snare/PCB/Snare.brd

## EAGLE design Snare/PCB/Snare.brd (2019-03-07)

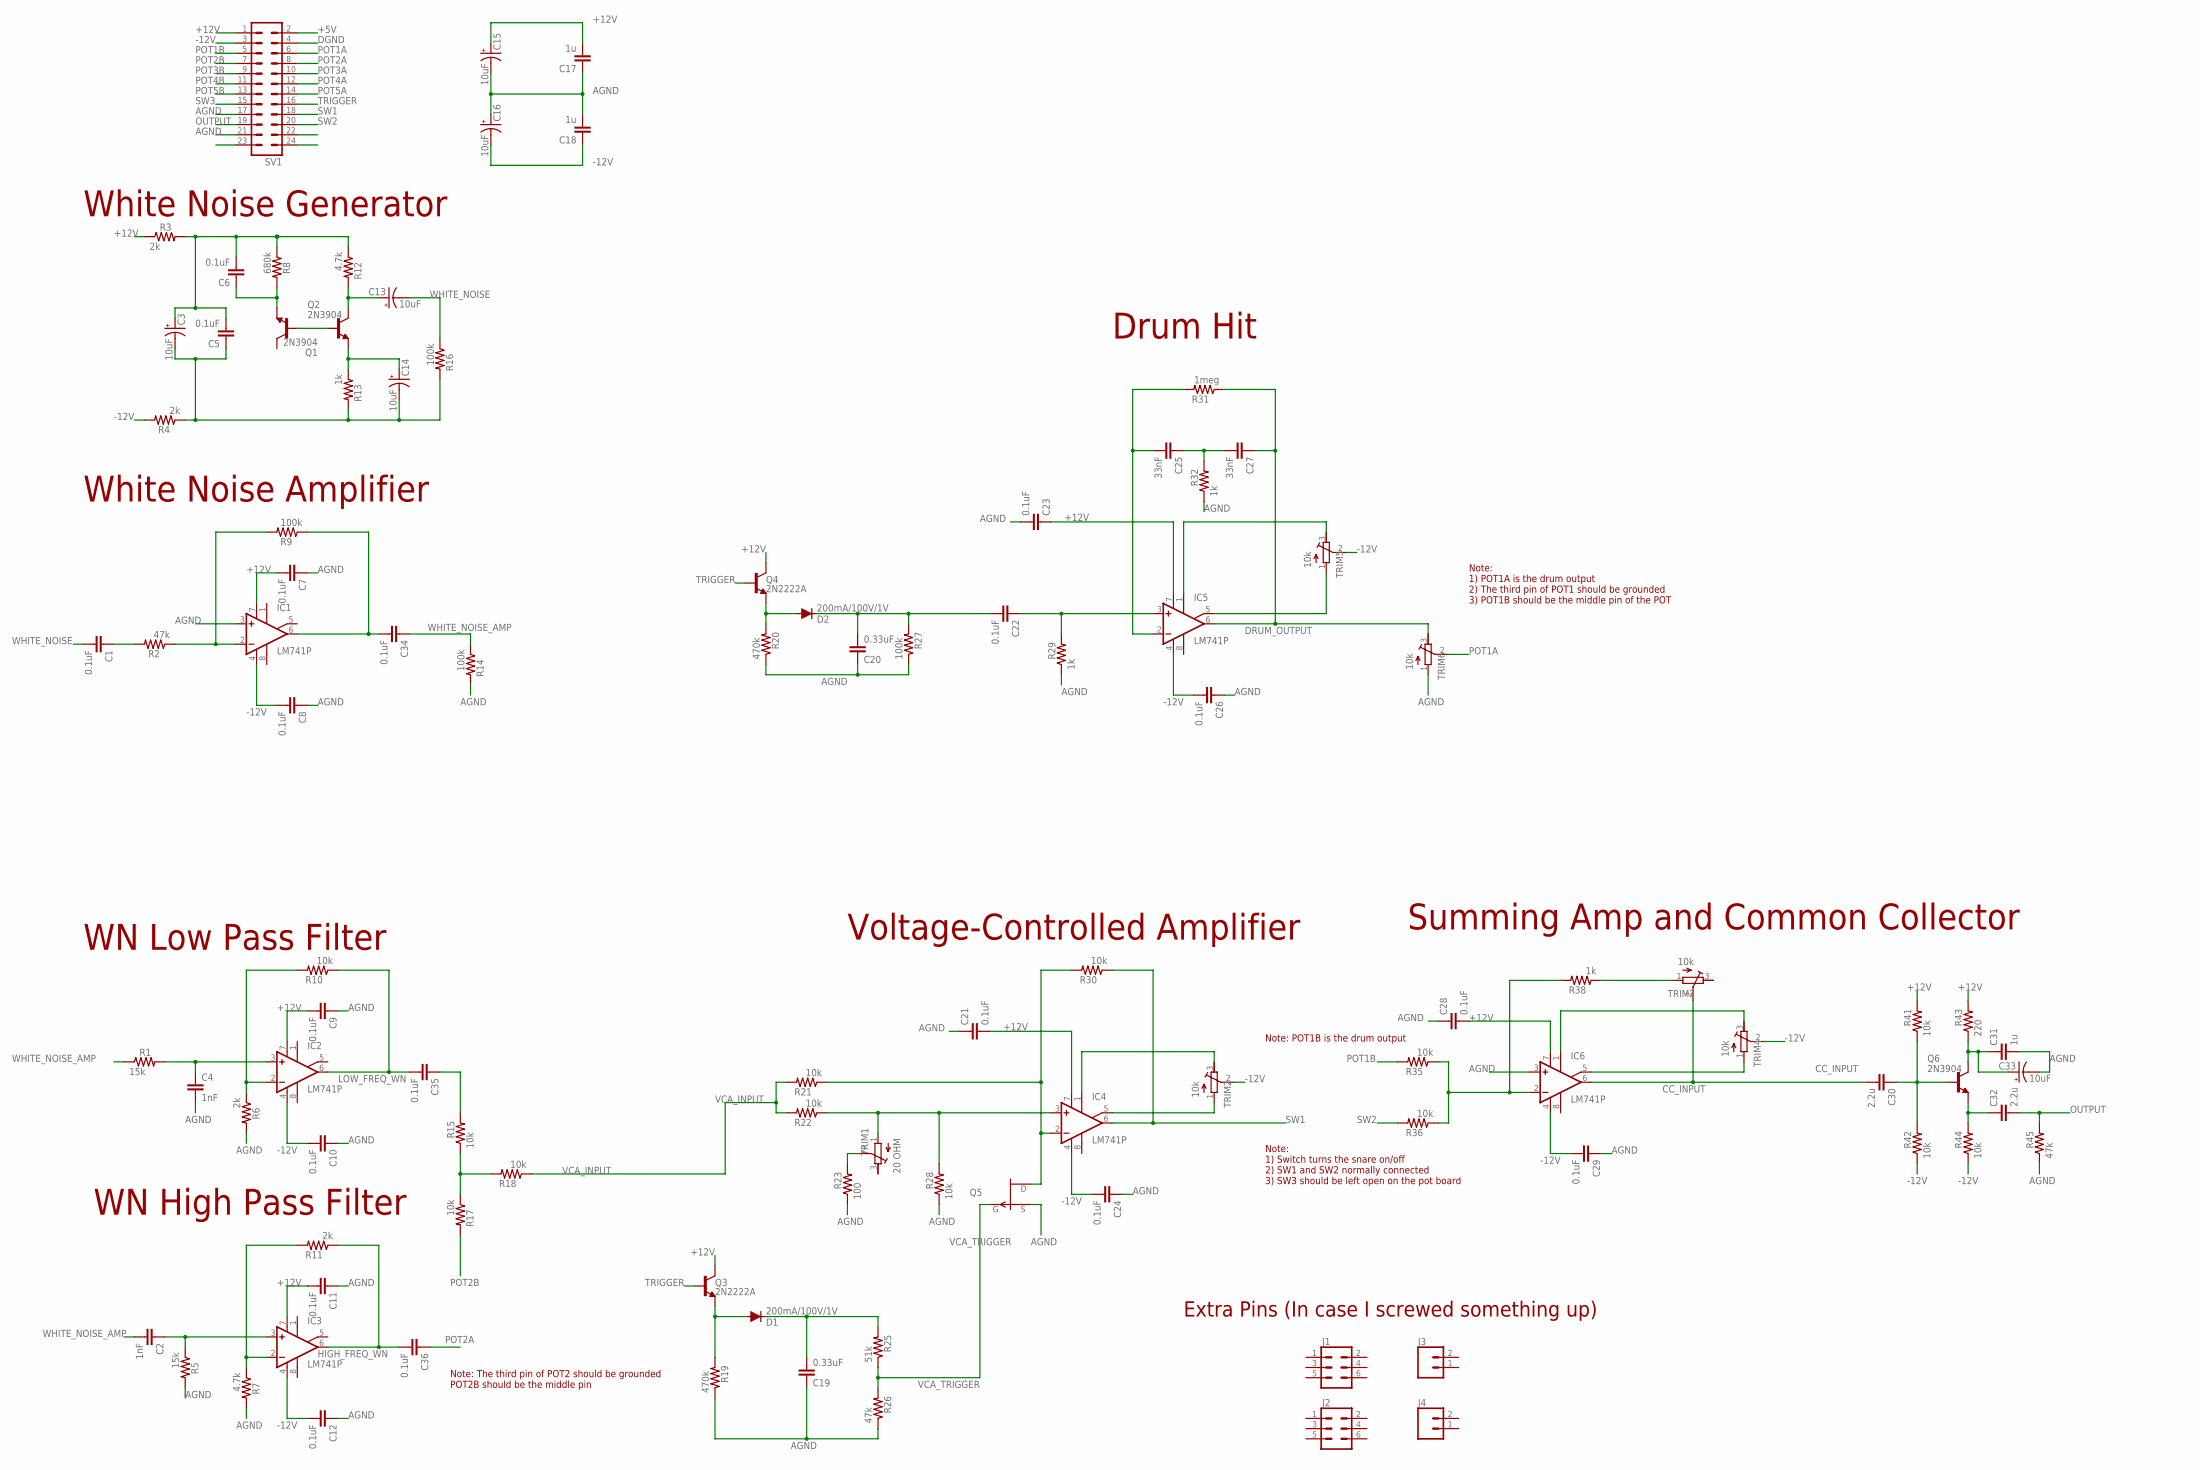
[picture p24: schematic Snare.sch]

Parts:
C1, C5, C6, C7, C8, C9, C10, C11, C12, C21, C22, C23, C24, C26, C28, C29, C34, C35, C36: 0.1uF; C050-024X044
C2, C4: 1nF; C050-024X044
C3, C13, C14, C15, C16, C33: 10uF; E2,5-6
C17, C18, C31: 1u; C050-024X044
C19, C20: 0.33uF; C050-024X044
C25, C27: 33nF; C050-024X044
C30, C32: 2.2u; C050-024X044
D1, D2: 200mA/100V/1V; DIODE-1N4148
IC1, IC2, IC3, IC4, IC5, IC6: LM741P; DIL08
J1, J2: CONN_03X2NO_SILK; 2X3-NS
J3, J4: CONN_021X02_NO_SILK; 1X02_NO_SILK
Q1, Q2, Q6: 2N3904; TO92
Q3, Q4: 2N2222A; TO-92
Q5: J176; TO-92
R1, R5: 15k; 0207/10
R2, R26, R45: 47k; 0207/10
R3, R4, R6, R11: 2k; 0207/10
R7, R12: 4.7k; 0207/10
R8: 680k; 0207/10
R9, R14, R16, R27: 100k; 0207/10
R10, R15, R17, R18, R21, R22, R28, R30, R35, R36, R41, R42, R44: 10k; 0207/10
R13, R29, R32, R38: 1k; 0207/10
R19, R20: 470k; 0207/10
R23: 100; 0207/10
R25: 51k; 0207/10
R31: 1meg; 0207/10
R43: 220; 0207/10
SV1: MA12-2
TRIM1: 20 OHM; RTRIM64W
TRIM2, TRIM3, TRIM4, TRIM5, TRIM6: 10k; RTRIM64W

Connections:
+5V: SV1.2
+12V: C7.2, C9.2, C11.2, C15.+, C17.2, C21.2, C23.1, C28.2, IC1.7 (V+), IC2.7 (V+), IC3.7 (V+), IC4.7 (V+), IC5.7 (V+), IC6.7 (V+), Q3.1 (C), Q4.1 (C), R3.1, R41.2, R43.2, SV1.1
-12V: C8.2, C10.2, C12.2, C16.-, C18.1, C24.2, C26.2, C29.2, IC1.4 (V-), IC2.4 (V-), IC3.4 (V-), IC4.4 (V-), IC5.4 (V-), IC6.4 (V-), R4.2, R42.1, R44.1, SV1.3, TRIM2.2 (S), TRIM4.2 (S), TRIM5.2 (S)
AGND: C4.2, C7.1, C8.1, C9.1, C10.1, C11.1, C12.1, C15.-, C16.+, C17.1, C18.2, C19.1, C20.1, C21.1, C23.2, C24.1, C26.1, C28.1, C29.1, C31.2, C33.-, IC1.3 (+IN), IC6.3 (+IN), Q5.3 (S), R5.2, R6.2, R7.2, R14.2, R19.1, R20.1, R23.1, R26.1, R27.1, R28.1, R29.1, R32.1, R45.1, SV1.17, SV1.21, TRIM6.1 (A)
CC_INPUT: C30.2, IC6.6 (OUT), TRIM3.2 (S)
DGND: SV1.4
DRUM_OUTPUT: C27.1, IC5.6 (OUT), R31.1, TRIM6.3 (E)
HIGH_FREQ_WN: C36.2, IC3.6 (OUT), R11.1
LOW_FREQ_WN: C35.2, IC2.6 (OUT), R10.1
unnamed: R15.1, R17.1, R18.2
unnamed: IC6.2 (-IN), R35.1, R36.1, R38.2
unnamed: R38.1, TRIM3.1 (A)
unnamed: IC6.5 (ON2), TRIM4.1 (A)
unnamed: C14.+, Q2.3 (E), R13.1
unnamed: C3.+, C5.2, C6.2, R3.2, R8.1, R12.1
unnamed: IC6.1 (ON1), TRIM4.3 (E)
unnamed: C25.1, C27.2, R32.2
unnamed: C34.2, IC1.6 (OUT), R9.1
unnamed: C35.1, R15.2
unnamed: Q1.2 (B), Q2.2 (B)
unnamed: C6.1, Q1.3 (E), R8.2
unnamed: C3.-, C5.1, C14.-, R4.1, R13.2, R16.2
unnamed: IC1.2 (-IN), R2.1, R9.2
unnamed: IC3.2 (-IN), R7.1, R11.2
unnamed: C1.1, R2.2
unnamed: C13.+, Q2.1 (C), R12.2
unnamed: C2.1, IC3.3 (+IN), R5.1
unnamed: IC2.2 (-IN), R6.1, R10.2
unnamed: C4.1, IC2.3 (+IN), R1.2
unnamed: C20.2, C22.2, D2.C, R27.2
unnamed: C30.1, Q6.2 (B), R41.1, R42.2
unnamed: C32.1, Q6.3 (E), R44.2
unnamed: C31.1, C33.+, Q6.1 (C), R43.1
unnamed: D2.A, Q4.3 (E), R20.2
unnamed: C22.1, IC5.3 (+IN), R29.2
unnamed: R23.2, TRIM1.2 (S)
unnamed: C25.2, IC5.2 (-IN), R31.2
unnamed: IC5.1 (ON1), TRIM5.3 (E)
unnamed: IC5.5 (ON2), TRIM5.1 (A)
unnamed: IC4.3 (+IN), R22.1, R28.2, TRIM1.1 (A)
unnamed: IC4.2 (-IN), Q5.1 (D), R21.1, R30.2
unnamed: IC4.1 (ON1), TRIM2.3 (E)
unnamed: C19.2, D1.C, R25.2
unnamed: IC4.5 (ON2), TRIM2.1 (A)
unnamed: D1.A, Q3.3 (E), R19.2
OUTPUT: C32.2, R45.2, SV1.19
POT1A: SV1.6, TRIM6.2 (S)
POT1B: R35.2, SV1.5
POT2A: C36.1, SV1.8
POT2B: R17.2, SV1.7
POT3A: SV1.10
POT3B: SV1.9
POT4A: SV1.12
POT4B: SV1.11
POT5A: SV1.14
POT5B: SV1.13
SW1: IC4.6 (OUT), R30.1, SV1.18
SW2: R36.2, SV1.20
SW3: SV1.15
TRIGGER: Q3.2 (B), Q4.2 (B), SV1.16
VCA_INPUT: R18.1, R21.2, R22.2
VCA_TRIGGER: Q5.2 (G), R25.1, R26.2
WHITE_NOISE: C1.2, C13.-, R16.1
WHITE_NOISE_AMP: C2.2, C34.1, R1.1, R14.1

Notes on the sheet:
Note: The third pin of POT2 should be grounded POT2B should be the middle pin
Note: 1) POT1A is the drum output 2) The third pin of POT1 should be grounded 3) POT1B should be the middle pin of the POT
Note: POT1B is the drum output
Note: 1) Switch turns the snare on/off 2) SW1 and SW2 normally connected 3) SW3 should be left open on the pot board
White Noise Generator
White Noise Amplifier
WN Low Pass Filter
WN High Pass Filter
Drum Hit
Voltage-Controlled Amplifier
Summing Amp and Common Collector
Extra Pins (In case I screwed something up)

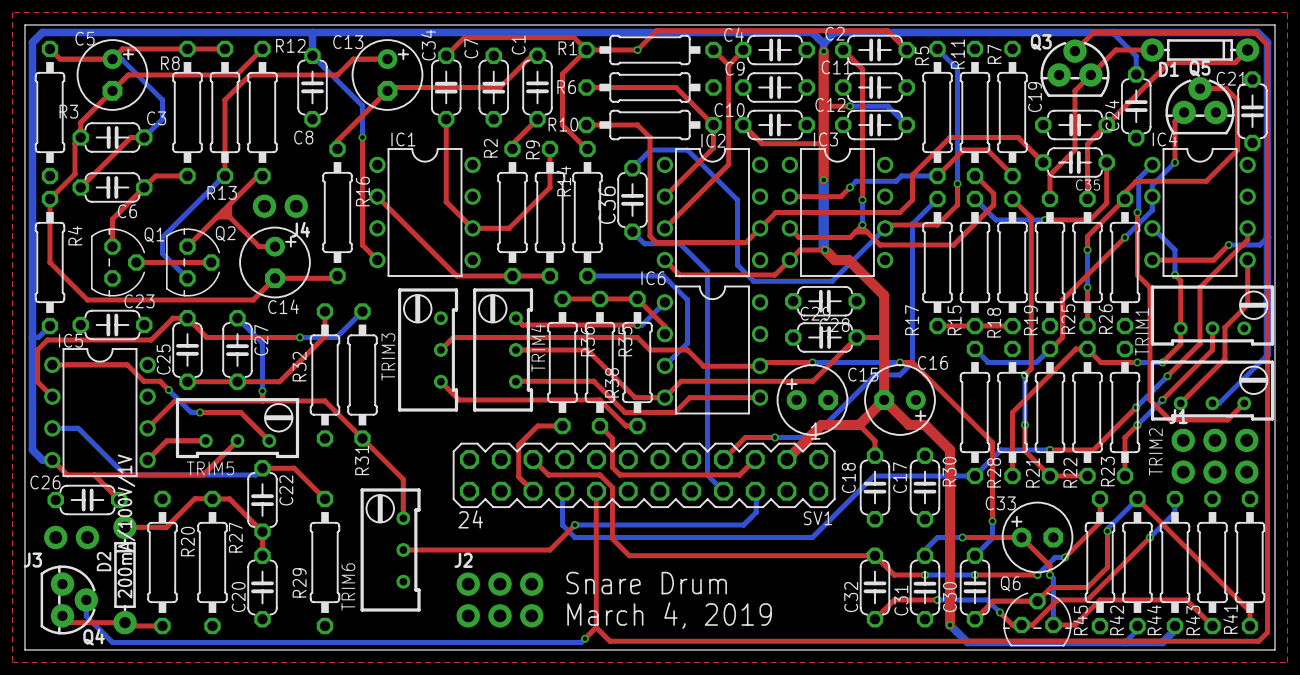
[picture p25: board Snare.brd from above]

Board: 2 copper layers, 100.0 x 50.0 mm, 100 parts (0 on the bottom side), 55 nets.
