kosikhar/Analog-Drum-Machine/Mixer/Eagle Files/Mixer.brd

## EAGLE design Mixer/Eagle Files/Mixer.brd (2019-03-07)

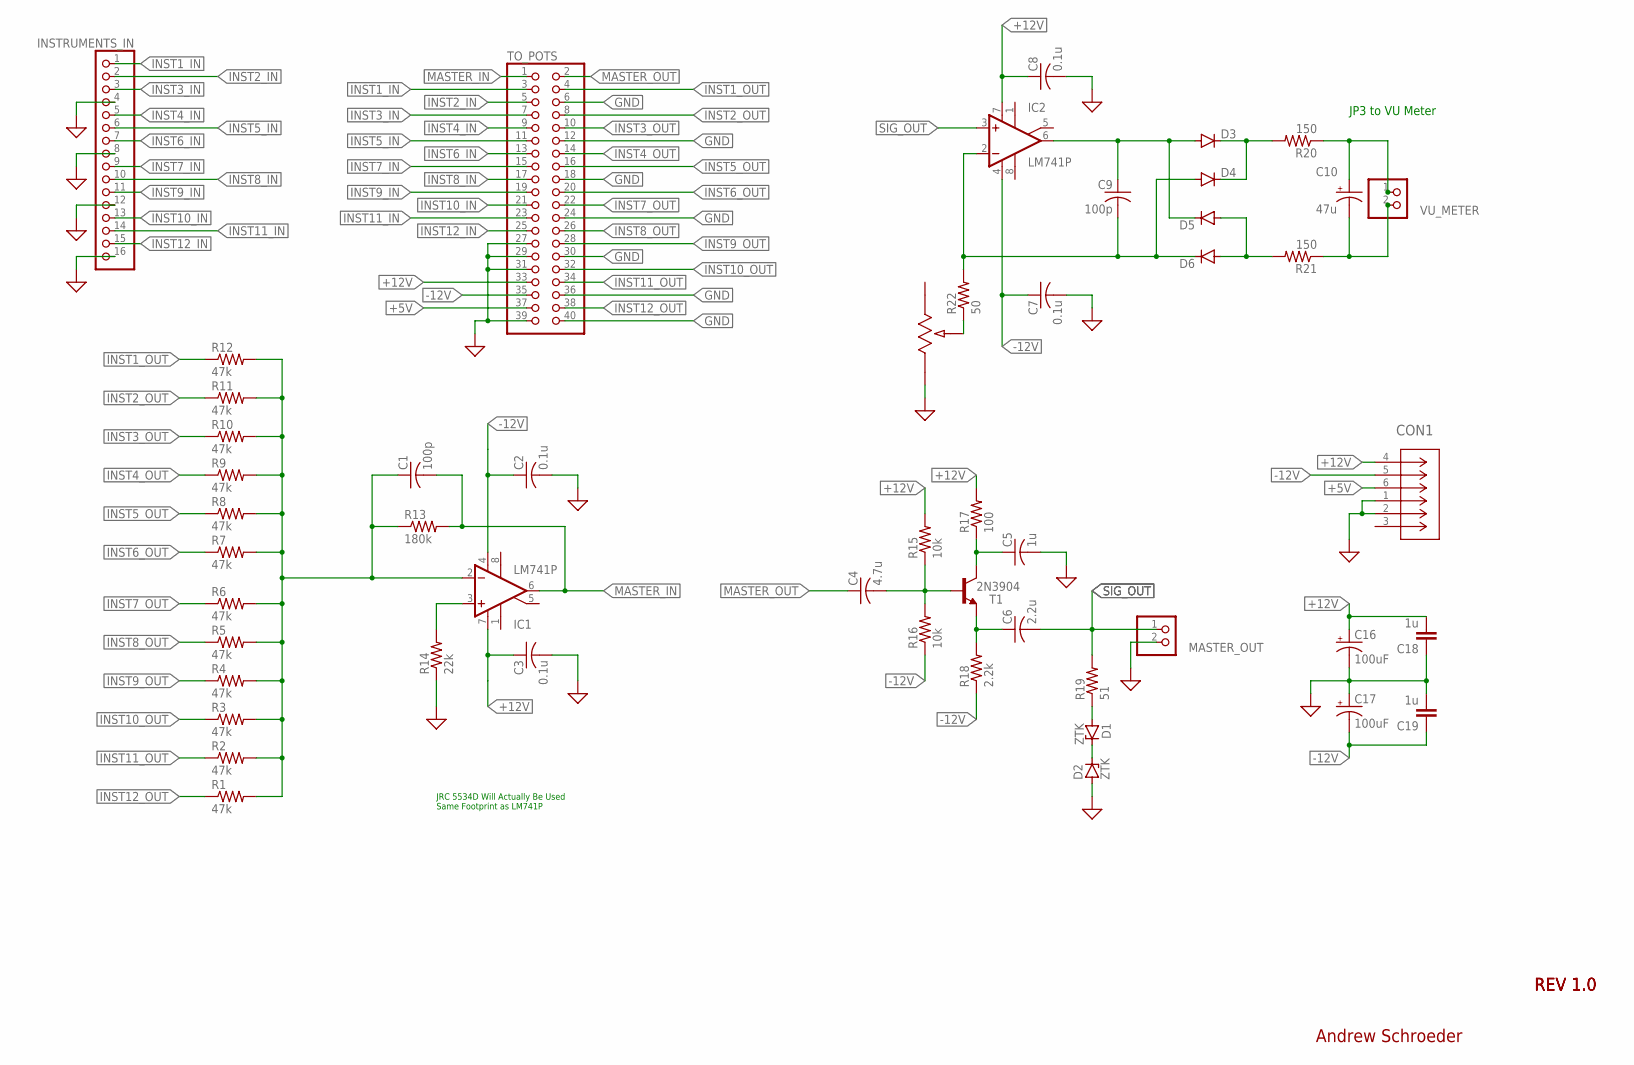
[picture p26: schematic Mixer.sch]

Parts:
C1, C9: 100p; C025-025X050
C2, C3, C7, C8: 0.1u; C025-025X050
C4: 4.7u; C025-025X050
C5: 1u; C025-025X050
C6: 2.2u; C025-025X050
C10: 47u; E2-5
C16, C17: 100uF; E5-8,5
C18, C19: 1u; C050-024X044
CON1: 1-770875-01-770875-0_VERTICAL; 1-770875-0
D1, D2: ZTK; DO35Z10
D3, D4, D5, D6: 1N4148DO35-7; DO35-7
IC1, IC2: LM741P; DIL08
INSTRUMENTS_IN: PINHD-1X16; 1X16
MASTER_OUT: PINHD-1X2; 1X02
R1, R2, R3, R4, R5, R6, R7, R8, R9, R10, R11, R12: 47k; 0207/7
R13: 180k; 0207/7
R14: 22k; 0207/7
R15, R16: 10k; 0207/7
R17: 100; 0207/7
R18: 2.2k; 0207/7
R19: 51; 0207/7
R20, R21: 150; 0207/7
R22: 50; 0207/7
R23: PV36W101C01B00; POT_PV36W
T1: 2N3904; TO92
TO_POTS: PINHD-2X20; 2X20
VU_METER: PINHD-1X2; 1X02

Connections:
+5V: CON1.6 (3), TO_POTS.37
+12V: C3.1, C8.1, C16.+, C18.2, CON1.4 (1), IC1.7 (V+), IC2.7 (V+), R15.2, R17.2, TO_POTS.33
-12V: C2.1, C7.1, C17.-, C19.1, CON1.5 (2), IC1.4 (V-), IC2.4 (V-), R16.1, R18.1, TO_POTS.35
GND: C2.2, C3.2, C5.2, C7.2, C8.2, C16.-, C17.+, C18.1, C19.2, CON1.1 (4), CON1.2 (5), D2.A, INSTRUMENTS_IN.4, INSTRUMENTS_IN.8, INSTRUMENTS_IN.12, INSTRUMENTS_IN.16, MASTER_OUT.2, R14.1, R23.3, TO_POTS.6, TO_POTS.12, TO_POTS.18, TO_POTS.24, TO_POTS.27, TO_POTS.29, TO_POTS.30, TO_POTS.31, TO_POTS.36, TO_POTS.39, TO_POTS.40
INST1_IN: INSTRUMENTS_IN.1, TO_POTS.3
INST1_OUT: R12.1, TO_POTS.4
INST2_IN: INSTRUMENTS_IN.2, TO_POTS.5
INST2_OUT: R11.1, TO_POTS.8
INST3_IN: INSTRUMENTS_IN.3, TO_POTS.7
INST3_OUT: R10.1, TO_POTS.10
INST4_IN: INSTRUMENTS_IN.5, TO_POTS.9
INST4_OUT: R9.1, TO_POTS.14
INST5_IN: INSTRUMENTS_IN.6, TO_POTS.11
INST5_OUT: R8.1, TO_POTS.16
INST6_IN: INSTRUMENTS_IN.7, TO_POTS.13
INST6_OUT: R7.1, TO_POTS.20
INST7_IN: INSTRUMENTS_IN.9, TO_POTS.15
INST7_OUT: R6.1, TO_POTS.22
INST8_IN: INSTRUMENTS_IN.10, TO_POTS.17
INST8_OUT: R5.1, TO_POTS.26
INST9_IN: INSTRUMENTS_IN.11, TO_POTS.19
INST9_OUT: R4.1, TO_POTS.28
INST10_IN: INSTRUMENTS_IN.13, TO_POTS.21
INST10_OUT: R3.1, TO_POTS.32
INST11_IN: INSTRUMENTS_IN.14, TO_POTS.23
INST11_OUT: R2.1, TO_POTS.34
INST12_IN: INSTRUMENTS_IN.15, TO_POTS.25
INST12_OUT: R1.1, TO_POTS.38
MASTER_IN: C1.2, IC1.6 (OUT), R13.2, TO_POTS.1
MASTER_OUT: C4.1, TO_POTS.2
unnamed: C9.1, D3.A, D5.C, IC2.6 (OUT)
unnamed: IC1.3 (+IN), R14.2
unnamed: C9.2, D4.A, D6.C, IC2.2 (-IN), R22.2
unnamed: C1.1, IC1.2 (-IN), R1.2, R2.2, R3.2, R4.2, R5.2, R6.2, R7.2, R8.2, R9.2, R10.2, R11.2, R12.2, R13.1
unnamed: D5.A, D6.A, R21.2
unnamed: C4.2, R15.1, R16.2, T1.2 (B)
unnamed: C10.+, R20.1, VU_METER.1
unnamed: C5.1, R17.1, T1.1 (C)
unnamed: D3.C, D4.C, R20.2
unnamed: C6.1, R18.2, T1.3 (E)
unnamed: C10.-, R21.1, VU_METER.2
unnamed: D1.A, R19.1
unnamed: R22.1, R23.2
unnamed: D1.C, D2.C
SIG_OUT: C6.2, IC2.3 (+IN), MASTER_OUT.1, R19.2

Notes on the sheet:
JRC 5534D Will Actually Be Used Same Footprint as LM741P
JP3 to VU Meter
REV 1.0
Andrew Schroeder

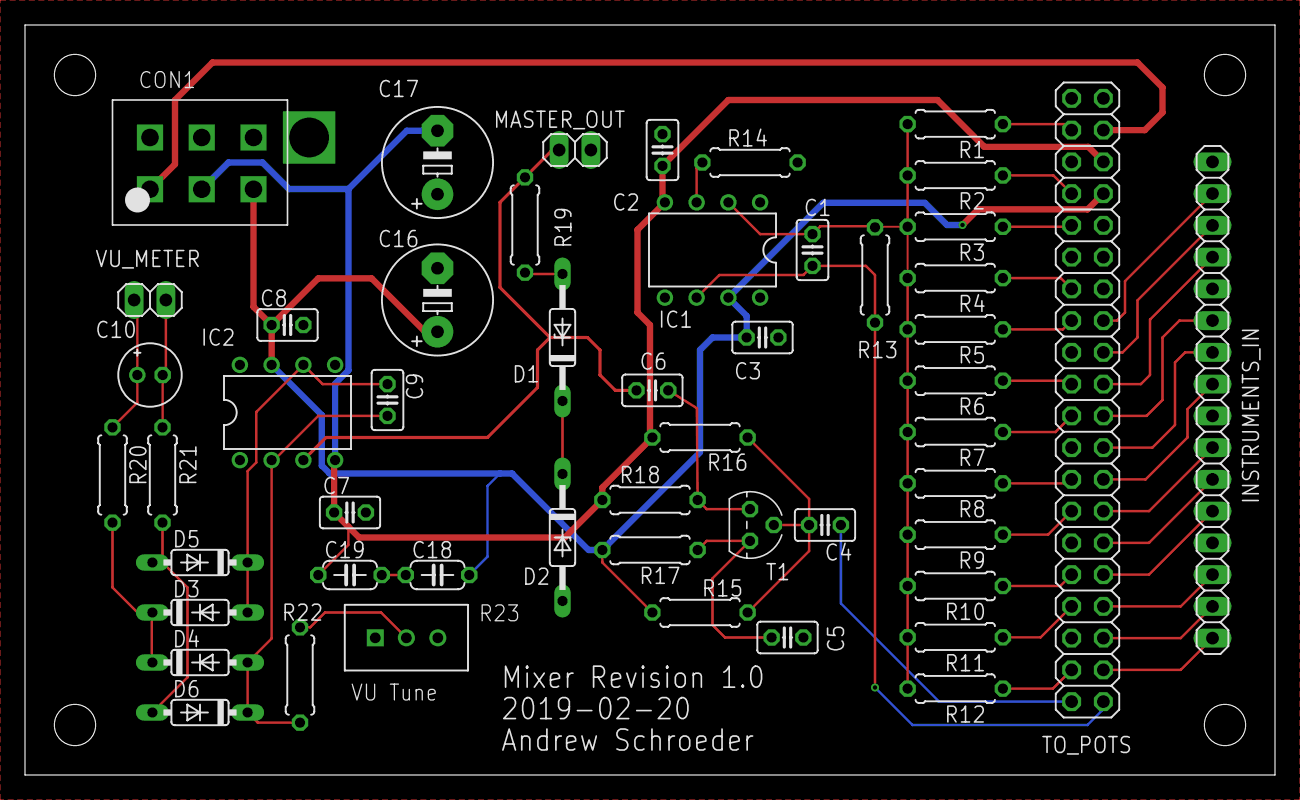
[picture p27: board Mixer.brd from above]

Board: 2 copper layers, 100.0 x 60.0 mm, 56 parts (0 on the bottom side), 45 nets.

Other parts of the board:
U$1, U$2, U$3, U$4: STAND-OFF
U$5: A5L-LOC
