kosikhar/Analog-Drum-Machine/Cowbell/Eagle Files/Cowbell.brd

## EAGLE design Cowbell/Eagle Files/Cowbell.brd (2019-03-07)

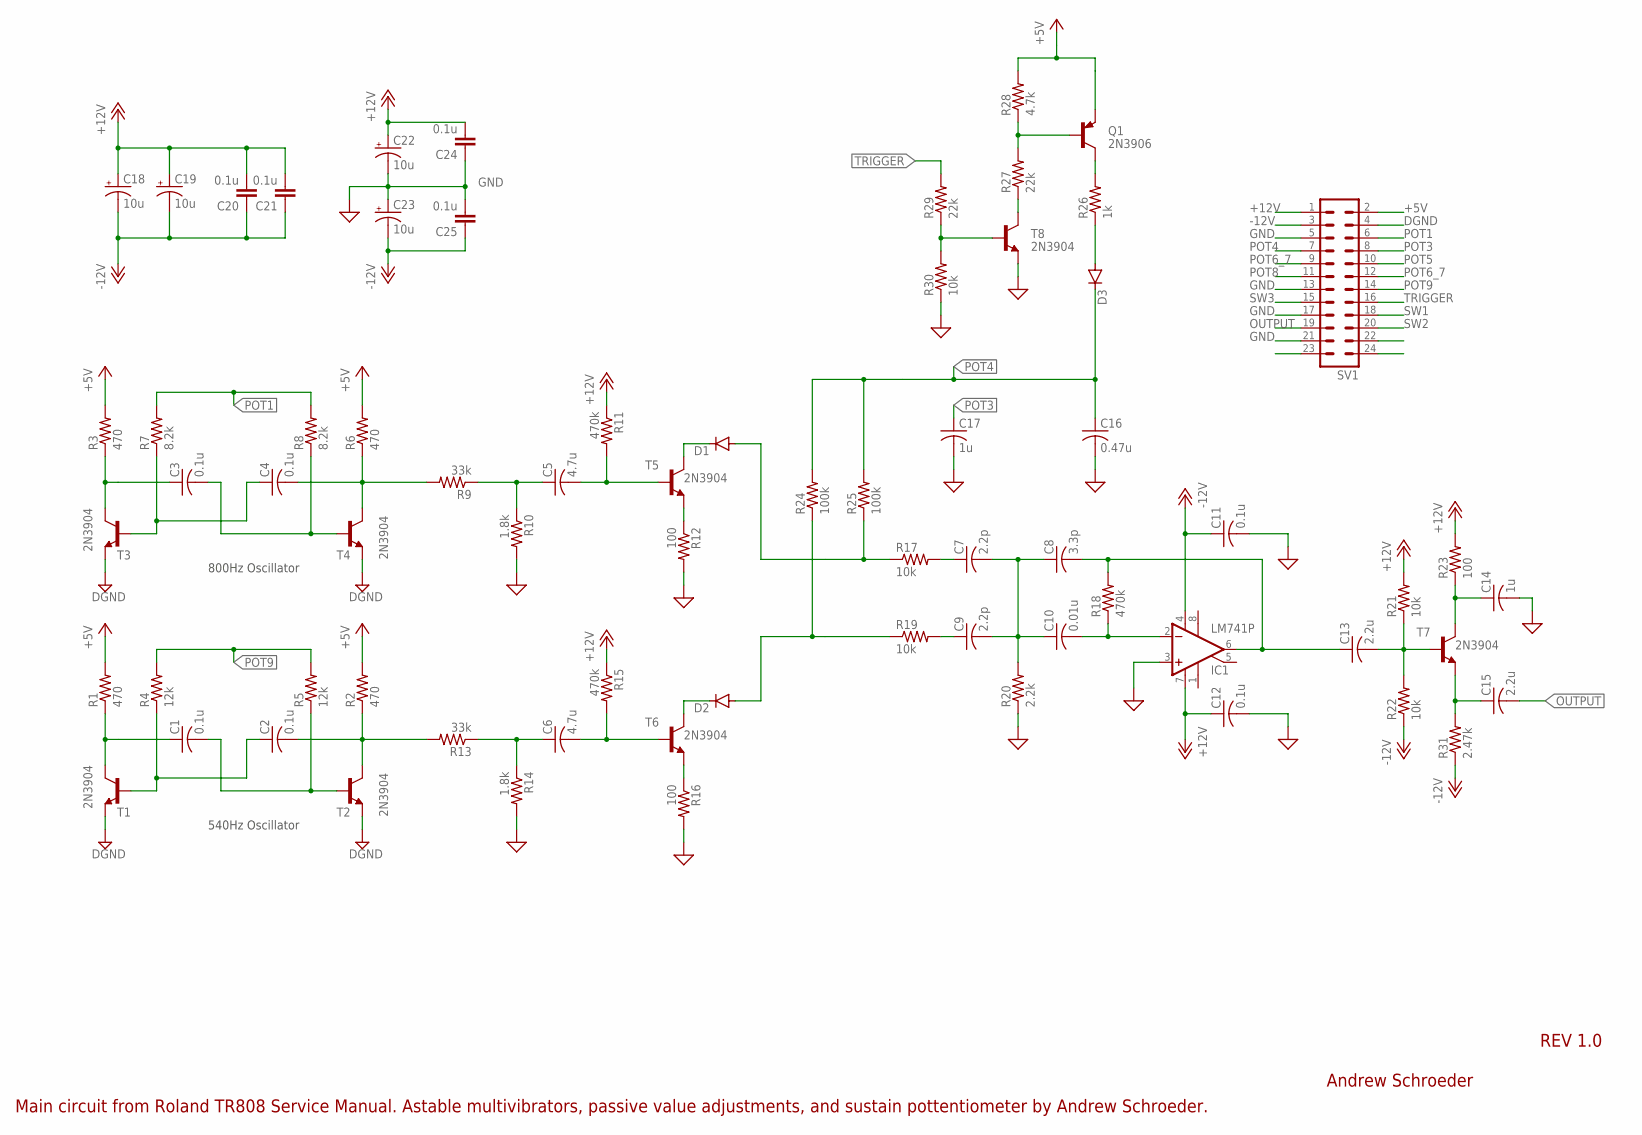
[picture p28: schematic Cowbell.sch]

Parts:
C1, C2, C3, C4, C11, C12: 0.1u; C025-024X044
C5, C6: 4.7u; C025-024X044
C7, C9: 2.2p; C025-024X044
C8: 3.3p; C025-024X044
C10: 0.01u; C025-024X044
C13, C15: 2.2u; C025-024X044
C14, C17: 1u; C025-024X044
C16: 0.47u; C025-024X044
C18, C19, C22, C23: 10u; E2,5-6
C20, C21, C24, C25: 0.1u; C050-024X044
D1, D2, D3: 1N4148DO35-7; DO35-7
IC1: LM741P; DIL08
Q1: 2N3906; TO92
R1, R2, R3, R6: 470; 0207/7
R4, R5: 12k; 0207/7
R7, R8: 8.2k; 0207/7
R9, R13: 33k; 0207/7
R10, R14: 1.8k; 0207/7
R11, R15, R18: 470k; 0207/7
R12, R16, R23: 100; 0207/7
R17, R19, R21, R22, R30: 10k; 0207/7
R20: 2.2k; 0207/7
R24, R25: 100k; 0207/7
R26: 1k; 0207/7
R27, R29: 22k; 0207/7
R28: 4.7k; 0207/7
R31: 2.47k; 0207/7
SV1: MA12-2
T1, T2, T3, T4, T5, T6, T7, T8: 2N3904; TO92

Connections:
+5V: Q1.3 (E), R1.2, R2.2, R3.2, R6.2, R28.2, SV1.2
+12V: C12.1, C18.+, C19.+, C20.2, C21.2, C22.+, C24.2, IC1.7 (V+), R11.1, R15.1, R21.2, R23.2, SV1.1
-12V: C11.1, C18.-, C19.-, C20.1, C21.1, C23.-, C25.1, IC1.4 (V-), R22.1, R31.1, SV1.3
DGND: SV1.4, T1.3 (E), T2.3 (E), T3.3 (E), T4.3 (E)
GND: C11.2, C12.2, C14.2, C16.2, C17.2, C22.-, C23.+, C24.1, C25.2, IC1.3 (+IN), R10.2, R12.2, R14.2, R16.2, R20.1, R30.1, SV1.5, SV1.13, SV1.17, SV1.21, T8.3 (E)
unnamed: C4.2, R6.1, R9.2, T4.1 (C)
unnamed: C2.2, R2.1, R13.2, T2.1 (C)
unnamed: C1.1, R1.1, T1.1 (C)
unnamed: C2.1, R4.1, T1.2 (B)
unnamed: C3.1, R3.1, T3.1 (C)
unnamed: C4.1, R7.1, T3.2 (B)
unnamed: C1.2, R5.1, T2.2 (B)
unnamed: C3.2, R8.1, T4.2 (B)
unnamed: C5.1, R9.1, R10.1
unnamed: D1.C, T5.1 (C)
unnamed: C5.2, R11.2, T5.2 (B)
unnamed: R12.1, T5.3 (E)
unnamed: C6.1, R13.1, R14.1
unnamed: C6.2, R15.2, T6.2 (B)
unnamed: R16.1, T6.3 (E)
unnamed: D2.C, T6.1 (C)
unnamed: D1.A, R17.1, R25.1
unnamed: D2.A, R19.1, R24.1
unnamed: C7.1, R17.2
unnamed: C7.2, C8.1, C9.2, C10.1, R20.2
unnamed: C8.2, C13.1, IC1.6 (OUT), R18.2
unnamed: C10.2, IC1.2 (-IN), R18.1
unnamed: C13.2, R21.1, R22.2, T7.2 (B)
unnamed: C9.1, R19.2
unnamed: Q1.1 (C), R26.2
unnamed: C14.1, R23.1, T7.1 (C)
unnamed: C15.1, R31.2, T7.3 (E)
unnamed: R27.1, T8.1 (C)
unnamed: D3.A, R26.1
unnamed: R29.1, R30.2, T8.2 (B)
unnamed: Q1.2 (B), R27.2, R28.1
OUTPUT: C15.2, SV1.19
POT1: R7.2, R8.2, SV1.6
POT3: C17.1, SV1.8
POT4: C16.1, D3.C, R24.2, R25.2, SV1.7
POT5: SV1.10
POT6_7: SV1.9, SV1.12
POT8: SV1.11
POT9: R4.2, R5.2, SV1.14
SW1: SV1.18
SW2: SV1.20
SW3: SV1.15
TRIGGER: R29.2, SV1.16

Notes on the sheet:
540Hz Oscillator
800Hz Oscillator
Andrew Schroeder
REV 1.0
Main circuit from Roland TR808 Service Manual. Astable multivibrators, passive value adjustments, and sustain pottentiometer by Andrew Schroeder.

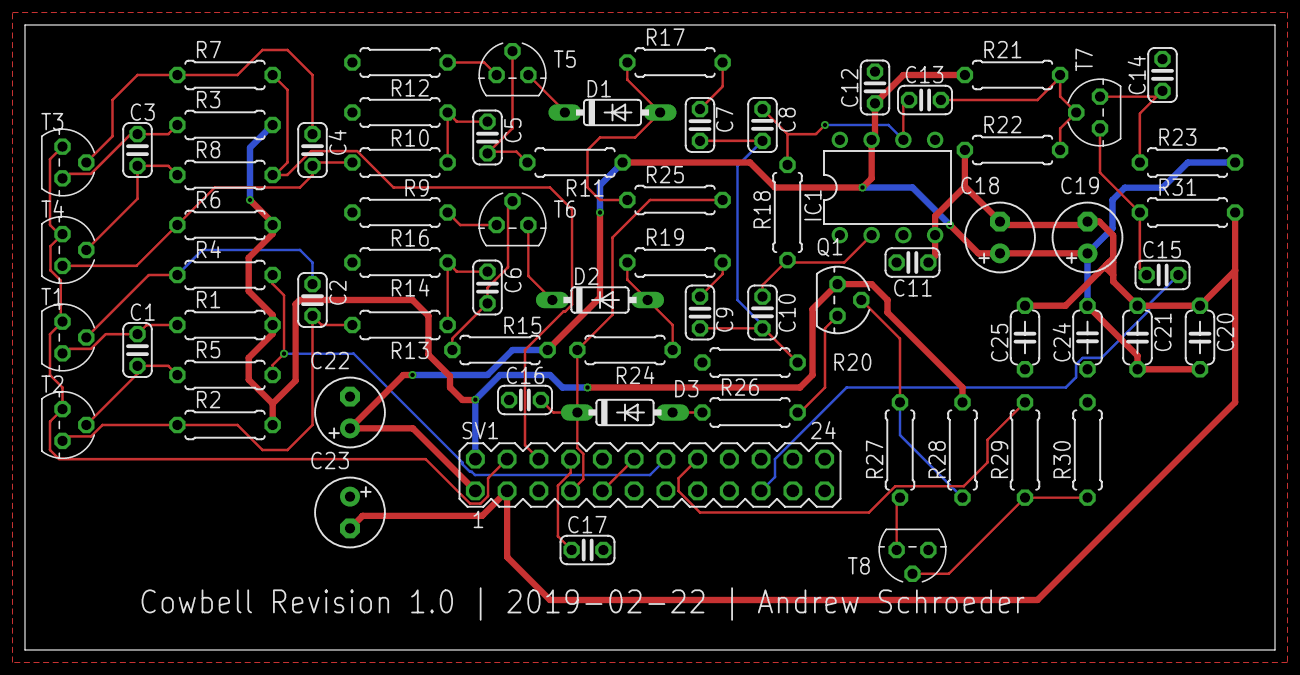
[picture p29: board Cowbell.brd from above]

Board: 2 copper layers, 100.0 x 50.0 mm, 71 parts (0 on the bottom side), 43 nets.

Other parts of the board:
U$6: A5L-LOC
