kosikhar/Analog-Drum-Machine/PATA Breakout Sequencer/PATA Breakout Sequencer.brd

## EAGLE design PATA Breakout Sequencer/PATA Breakout Sequencer.brd (2019-03-07)

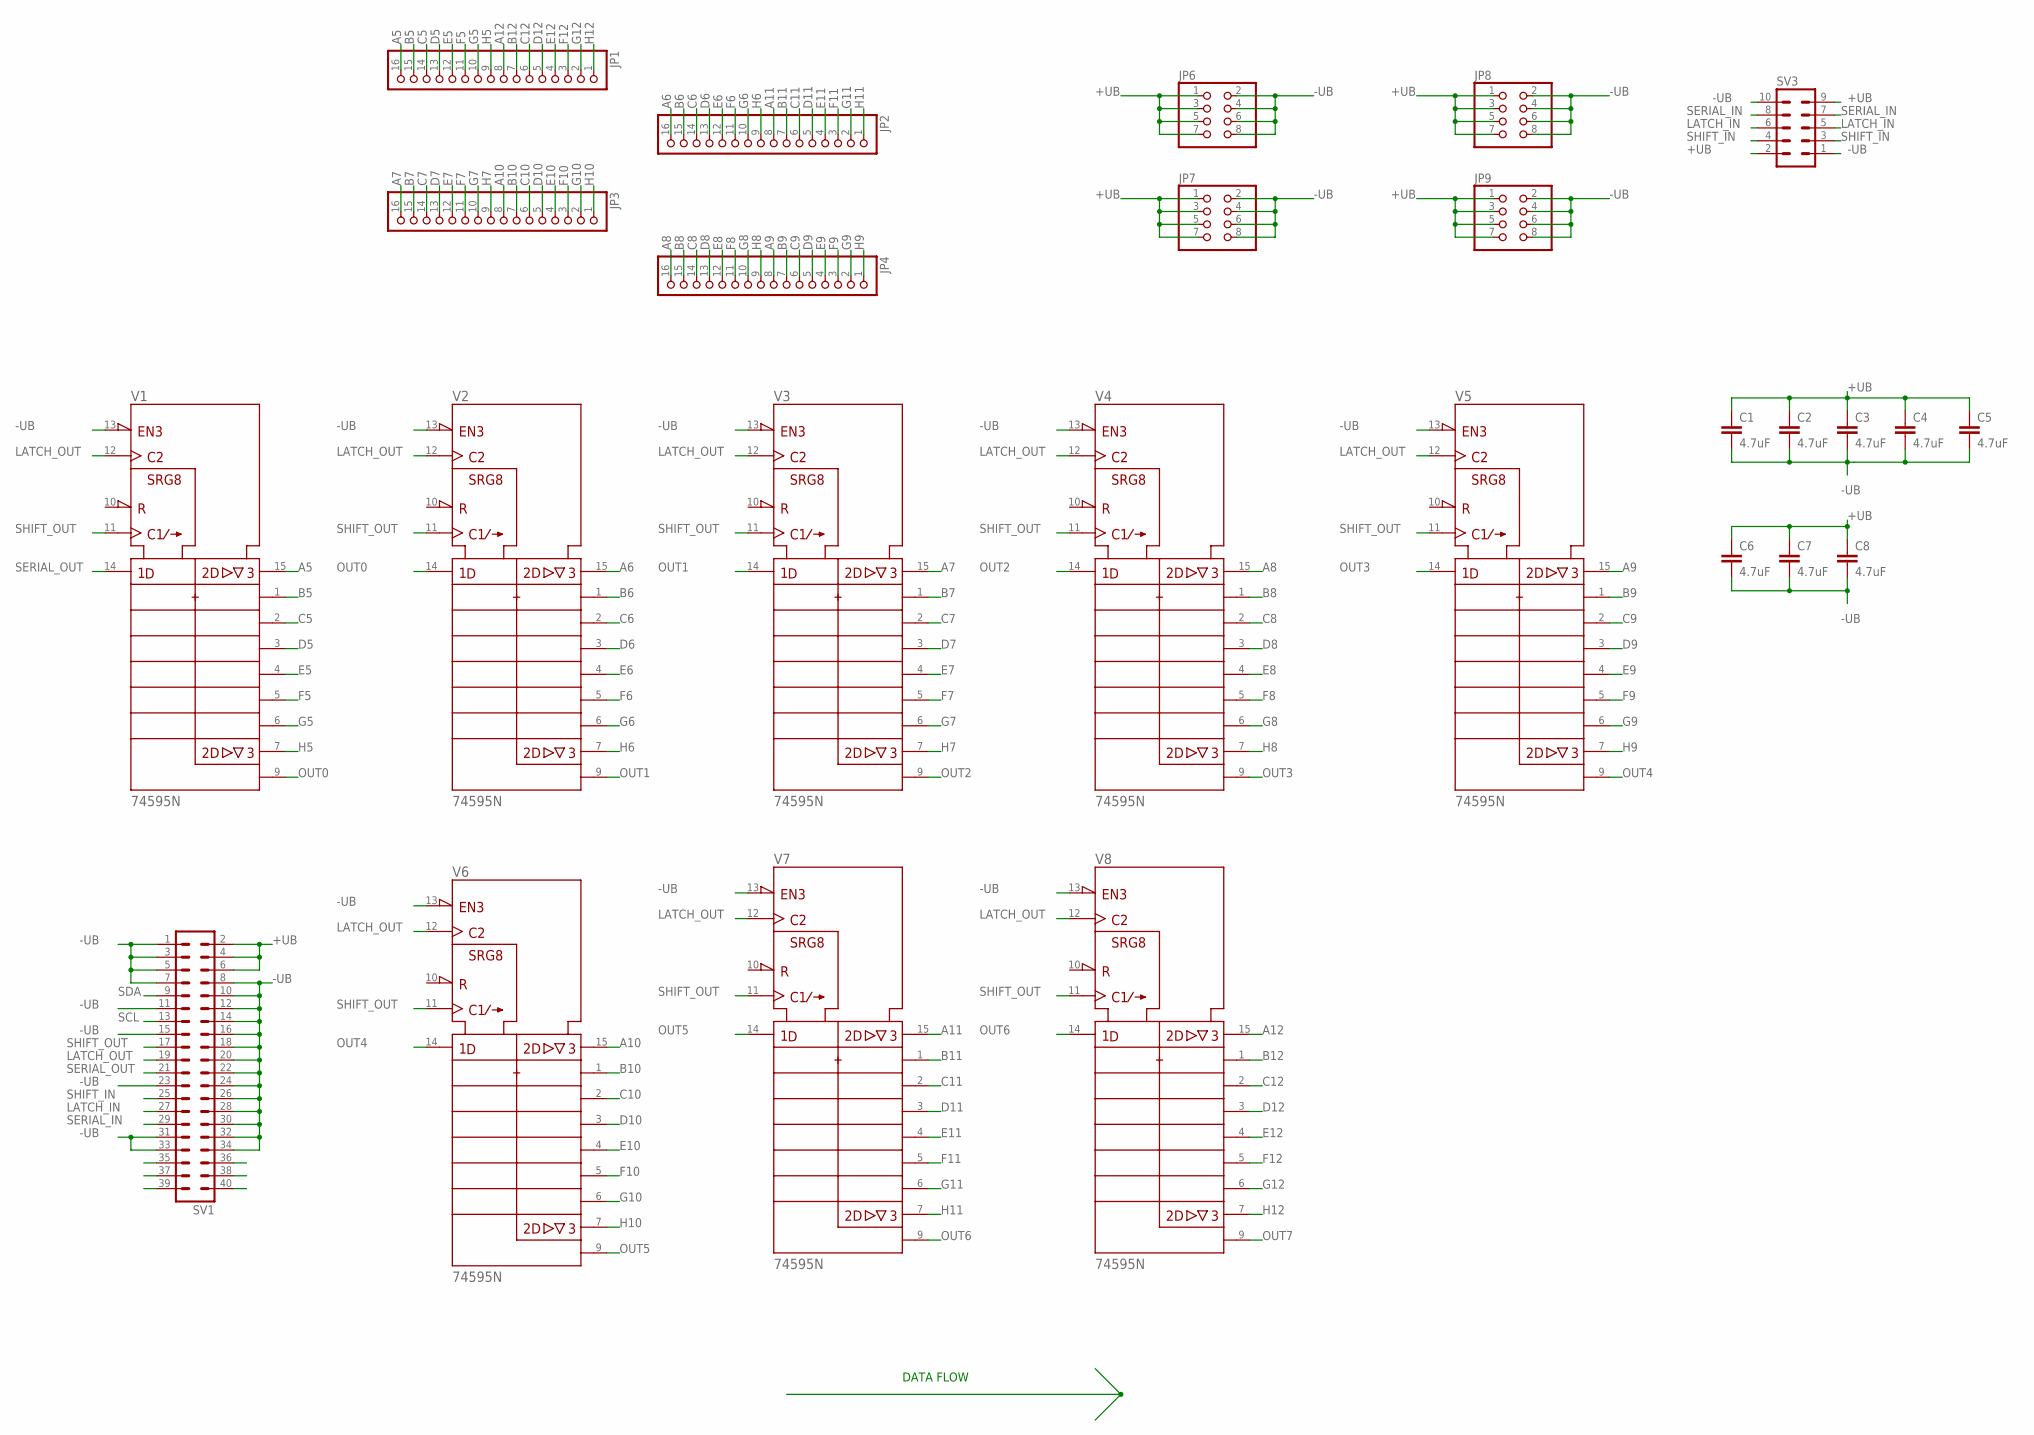
[picture p30: schematic PATA Breakout Sequencer.sch]

Parts:
C1, C2, C3, C4, C5, C6, C7, C8: 4.7uF; C050-024X044
JP1, JP2, JP3, JP4: PINHD-1X16; 1X16
JP6, JP7, JP8, JP9: PINHD-2X4; 2X04
SV1: MA20-2
SV3: MA05-2
V1, V2, V3, V4, V5, V6, V7, V8: 74595N; DIL16

Connections:
+UB: C1.1, C2.1, C3.1, C4.1, C5.1, C6.1, C7.1, C8.1, JP6.1, JP6.3, JP6.5, JP6.7, JP7.1, JP7.3, JP7.5, JP7.7, JP8.1, JP8.3, JP8.5, JP8.7, JP9.1, JP9.3, JP9.5, JP9.7, SV1.2, SV1.4, SV1.6, SV3.2, SV3.9, V1.16 (+UB), V2.16 (+UB), V3.16 (+UB), V4.16 (+UB), V5.16 (+UB), V6.16 (+UB), V7.16 (+UB), V8.16 (+UB)
-UB: C1.2, C2.2, C3.2, C4.2, C5.2, C6.2, C7.2, C8.2, JP6.2, JP6.4, JP6.6, JP6.8, JP7.2, JP7.4, JP7.6, JP7.8, JP8.2, JP8.4, JP8.6, JP8.8, JP9.2, JP9.4, JP9.6, JP9.8, SV1.1, SV1.3, SV1.5, SV1.7, SV1.8, SV1.10, SV1.11, SV1.12, SV1.14, SV1.15, SV1.16, SV1.18, SV1.20, SV1.22, SV1.23, SV1.24, SV1.26, SV1.28, SV1.30, SV1.31, SV1.32, SV1.33, SV1.34, SV3.1, SV3.10, V1.8 (-UB), V1.13 (!G), V2.8 (-UB), V2.13 (!G), V3.8 (-UB), V3.13 (!G), V4.8 (-UB), V4.13 (!G), V5.8 (-UB), V5.13 (!G), V6.8 (-UB), V6.13 (!G), V7.8 (-UB), V7.13 (!G), V8.8 (-UB), V8.13 (!G)
A5: JP1.16, V1.15 (QA)
A6: JP2.16, V2.15 (QA)
A7: JP3.16, V3.15 (QA)
A8: JP4.16, V4.15 (QA)
A9: JP4.8, V5.15 (QA)
A10: JP3.8, V6.15 (QA)
A11: JP2.8, V7.15 (QA)
A12: JP1.8, V8.15 (QA)
B5: JP1.15, V1.1 (QB)
B6: JP2.15, V2.1 (QB)
B7: JP3.15, V3.1 (QB)
B8: JP4.15, V4.1 (QB)
B9: JP4.7, V5.1 (QB)
B10: JP3.7, V6.1 (QB)
B11: JP2.7, V7.1 (QB)
B12: JP1.7, V8.1 (QB)
C5: JP1.14, V1.2 (QC)
C6: JP2.14, V2.2 (QC)
C7: JP3.14, V3.2 (QC)
C8: JP4.14, V4.2 (QC)
C9: JP4.6, V5.2 (QC)
C10: JP3.6, V6.2 (QC)
C11: JP2.6, V7.2 (QC)
C12: JP1.6, V8.2 (QC)
D5: JP1.13, V1.3 (QD)
D6: JP2.13, V2.3 (QD)
D7: JP3.13, V3.3 (QD)
D8: JP4.13, V4.3 (QD)
D9: JP4.5, V5.3 (QD)
D10: JP3.5, V6.3 (QD)
D11: JP2.5, V7.3 (QD)
D12: JP1.5, V8.3 (QD)
E5: JP1.12, V1.4 (QE)
E6: JP2.12, V2.4 (QE)
E7: JP3.12, V3.4 (QE)
E8: JP4.12, V4.4 (QE)
E9: JP4.4, V5.4 (QE)
E10: JP3.4, V6.4 (QE)
E11: JP2.4, V7.4 (QE)
E12: JP1.4, V8.4 (QE)
F5: JP1.11, V1.5 (QF)
F6: JP2.11, V2.5 (QF)
F7: JP3.11, V3.5 (QF)
F8: JP4.11, V4.5 (QF)
F9: JP4.3, V5.5 (QF)
F10: JP3.3, V6.5 (QF)
F11: JP2.3, V7.5 (QF)
F12: JP1.3, V8.5 (QF)
G5: JP1.10, V1.6 (QG)
G6: JP2.10, V2.6 (QG)
G7: JP3.10, V3.6 (QG)
G8: JP4.10, V4.6 (QG)
G9: JP4.2, V5.6 (QG)
G10: JP3.2, V6.6 (QG)
G11: JP2.2, V7.6 (QG)
G12: JP1.2, V8.6 (QG)
H5: JP1.9, V1.7 (QH)
H6: JP2.9, V2.7 (QH)
H7: JP3.9, V3.7 (QH)
H8: JP4.9, V4.7 (QH)
H9: JP4.1, V5.7 (QH)
H10: JP3.1, V6.7 (QH)
H11: JP2.1, V7.7 (QH)
H12: JP1.1, V8.7 (QH)
LATCH_IN: SV1.27, SV3.5, SV3.6
LATCH_OUT: SV1.19, V1.12 (RCK), V2.12 (RCK), V3.12 (RCK), V4.12 (RCK), V5.12 (RCK), V6.12 (RCK), V7.12 (RCK), V8.12 (RCK)
OUT0: V1.9 (QH*), V2.14 (SER)
OUT1: V2.9 (QH*), V3.14 (SER)
OUT2: V3.9 (QH*), V4.14 (SER)
OUT3: V4.9 (QH*), V5.14 (SER)
OUT4: V5.9 (QH*), V6.14 (SER)
OUT5: V6.9 (QH*), V7.14 (SER)
OUT6: V7.9 (QH*), V8.14 (SER)
OUT7: V8.9 (QH*)
SCL: SV1.13
SDA: SV1.9
SERIAL_IN: SV1.29, SV3.7, SV3.8
SERIAL_OUT: SV1.21, V1.14 (SER)
SHIFT_IN: SV1.25, SV3.3, SV3.4
SHIFT_OUT: SV1.17, V1.11 (SRCK), V2.11 (SRCK), V3.11 (SRCK), V4.11 (SRCK), V5.11 (SRCK), V6.11 (SRCK), V7.11 (SRCK), V8.11 (SRCK)

Notes on the sheet:
DATA FLOW

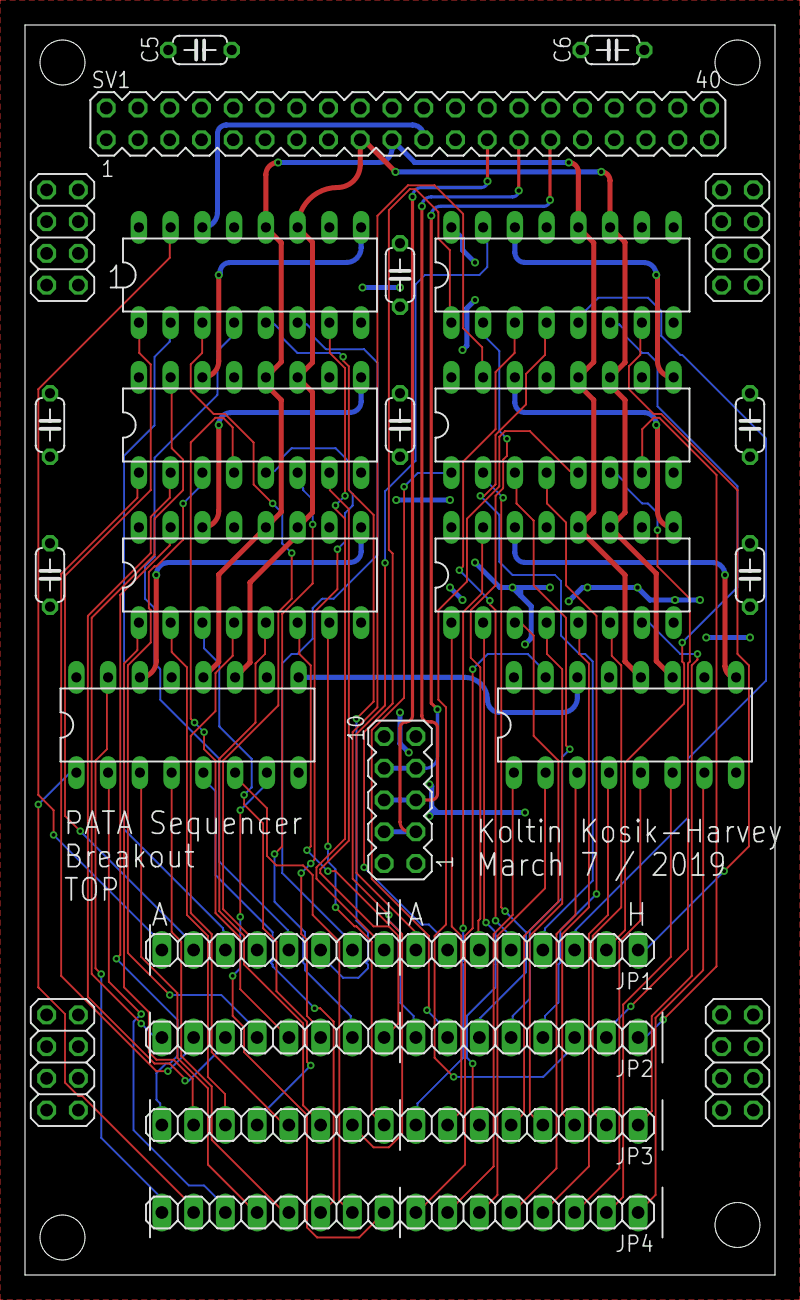
[picture p31: board PATA Breakout Sequencer.brd from above]

Board: 2 copper layers, 60.0 x 100.0 mm, 26 parts (0 on the bottom side), 79 nets.
