kosikhar/Analog-Drum-Machine/Sequencer/MicroController/EAGLE/sequencer_uC.brd

## EAGLE design Sequencer/MicroController/EAGLE/sequencer_uC.brd (2019-03-07)

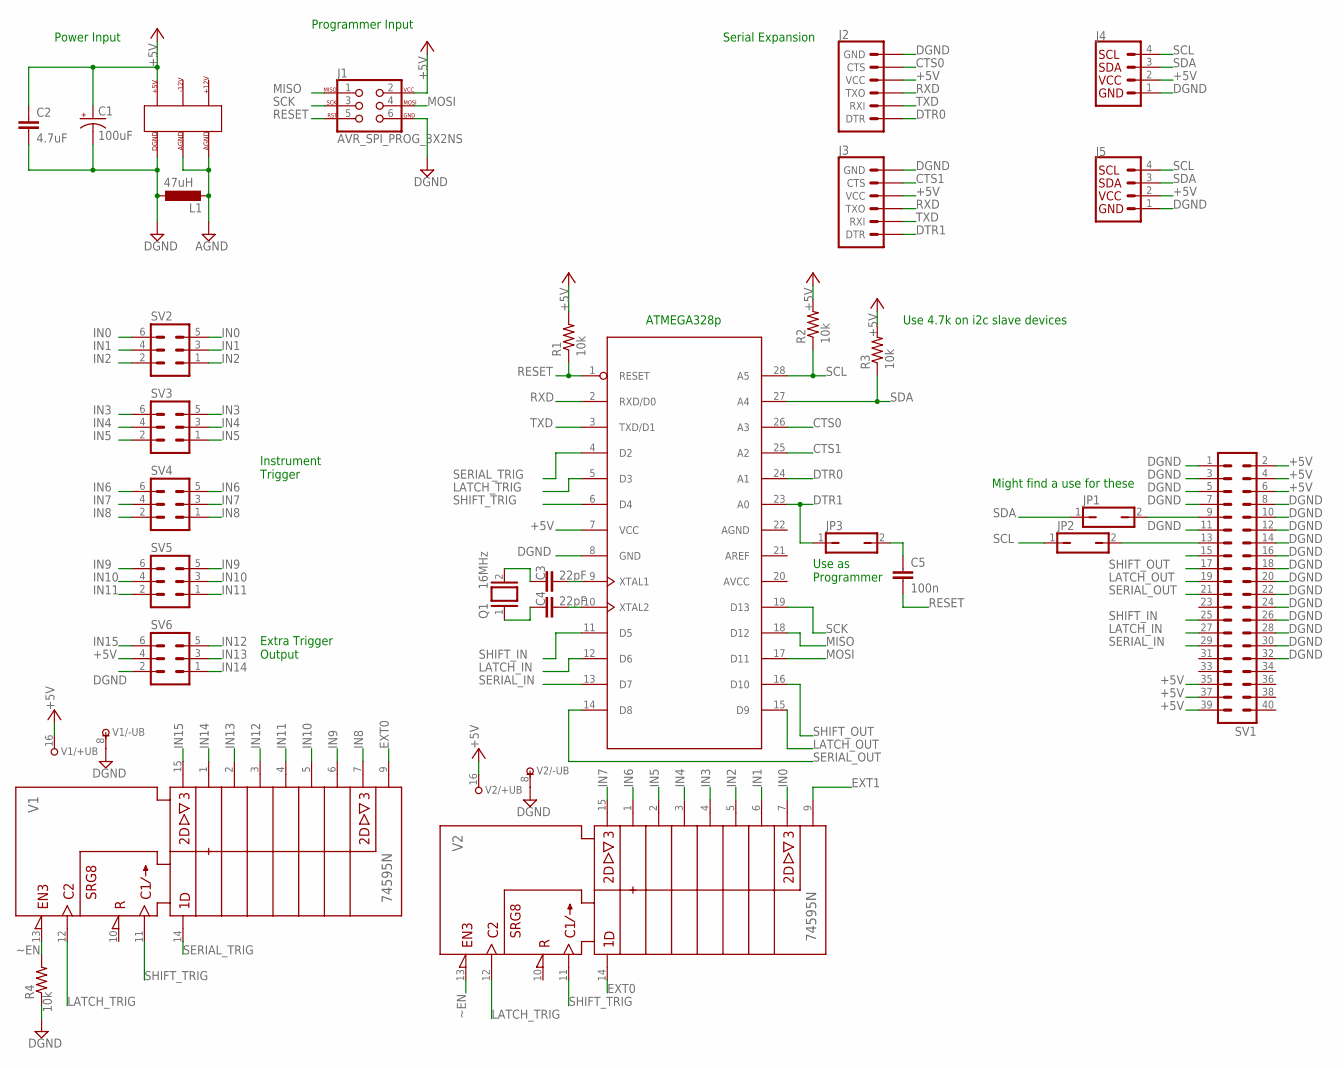
[picture p32: schematic sequencer_uC.sch]

Parts:
AT1: ATMEGA328; DIP28-0.3IN
C1: 100uF; E5-8,5
C2: 4.7uF; C050-024X044
C3, C4: 22pF; C050-024X044
C5: 100n; C050-024X044
J1: AVR_SPI_PROG_3X2NS; 2X3-NS
J2, J3: 6_PIN_SERIAL_TARGETLONGPADS; 1X06_LONGPADS
J4, J5: I2C_STANDARD; 1X04
JP1, JP2, JP3: JP1Q; JP1
L1: 47uH; 0207/10
Q1: 16MHz; QS
R1, R2, R3, R4: 10k; 0204/7
SV1: MA20-2
SV2, SV3, SV4, SV5, SV6: MA03-2
U$1: TER6PIN_VERT; CAPSTONE_1-770875-0
V1, V2: 74595N; DIL16

Connections:
+5V: AT1.7 (VCC), C1.+, C2.1, J1.2, J2.4 (VCC), J3.4 (VCC), J4.2, J5.2, R1.2, R2.2, R3.2, SV1.2, SV1.4, SV1.6, SV1.35, SV1.37, SV1.39, SV6.4, U$1.+5V, V1.16 (+UB), V2.16 (+UB)
AGND: L1.2, U$1.AGND0, U$1.AGND1
CTS0: AT1.26 (A3), J2.5 (CTS)
CTS1: AT1.25 (A2), J3.5 (CTS)
DGND: AT1.8 (GND), C1.-, C2.2, J1.6, J2.6 (GND), J3.6 (GND), J4.1, J5.1, L1.1, R4.1, SV1.1, SV1.3, SV1.5, SV1.7, SV1.8, SV1.10, SV1.11, SV1.12, SV1.14, SV1.15, SV1.16, SV1.18, SV1.20, SV1.22, SV1.24, SV1.26, SV1.28, SV1.30, SV1.32, SV6.2, U$1.DGND, U$1.NULL (DGND), V1.8 (-UB), V2.8 (-UB)
DTR0: AT1.24 (A1), J2.1 (DTR)
DTR1: AT1.23 (A0), J3.1 (DTR), JP3.1
EXT0: V1.9 (QH*), V2.14 (SER)
EXT1: V2.9 (QH*)
IN0: SV2.5, SV2.6, V2.7 (QH)
IN1: SV2.3, SV2.4, V2.6 (QG)
IN2: SV2.1, SV2.2, V2.5 (QF)
IN3: SV3.5, SV3.6, V2.4 (QE)
IN4: SV3.3, SV3.4, V2.3 (QD)
IN5: SV3.1, SV3.2, V2.2 (QC)
IN6: SV4.5, SV4.6, V2.1 (QB)
IN7: SV4.3, SV4.4, V2.15 (QA)
IN8: SV4.1, SV4.2, V1.7 (QH)
IN9: SV5.5, SV5.6, V1.6 (QG)
IN10: SV5.3, SV5.4, V1.5 (QF)
IN11: SV5.1, SV5.2, V1.4 (QE)
IN12: SV6.5, V1.3 (QD)
IN13: SV6.3, V1.2 (QC)
IN14: SV6.1, V1.1 (QB)
IN15: SV6.6, V1.15 (QA)
LATCH_IN: AT1.12 (D6), SV1.27
LATCH_OUT: AT1.15 (D9), SV1.19
LATCH_TRIG: AT1.5 (D3), V1.12 (RCK), V2.12 (RCK)
MISO: AT1.18 (D12), J1.1
MOSI: AT1.17 (D11), J1.4
unnamed: AT1.9 (XTAL1), C3.2
unnamed: AT1.10 (XTAL2), C4.2
unnamed: C3.1, Q1.2
unnamed: C4.1, Q1.1
unnamed: JP2.2, SV1.13
unnamed: JP1.2, SV1.9
unnamed: C5.1, JP3.2
RESET: AT1.1 (RESET), C5.2, J1.5, R1.1
RXD: AT1.2 (RXD/D0), J2.3 (TXO), J3.3 (TXO)
SCK: AT1.19 (D13), J1.3
SCL: AT1.28 (A5), J4.4, J5.4, JP2.1, R2.1
SDA: AT1.27 (A4), J4.3, J5.3, JP1.1, R3.1
SERIAL_IN: AT1.13 (D7), SV1.29
SERIAL_OUT: AT1.14 (D8), SV1.21
SERIAL_TRIG: AT1.4 (D2), V1.14 (SER)
SHIFT_IN: AT1.11 (D5), SV1.25
SHIFT_OUT: AT1.16 (D10), SV1.17
SHIFT_TRIG: AT1.6 (D4), V1.11 (SRCK), V2.11 (SRCK)
TXD: AT1.3 (TXD/D1), J2.2 (RXI), J3.2 (RXI)
~EN: R4.2, V1.13 (!G), V2.13 (!G)

Notes on the sheet:
ATMEGA328p
Serial Expansion
Power Input
Programmer Input
Instrument Trigger
Extra Trigger Output
Use 4.7k on i2c slave devices
Might find a use for these
Use as Programmer

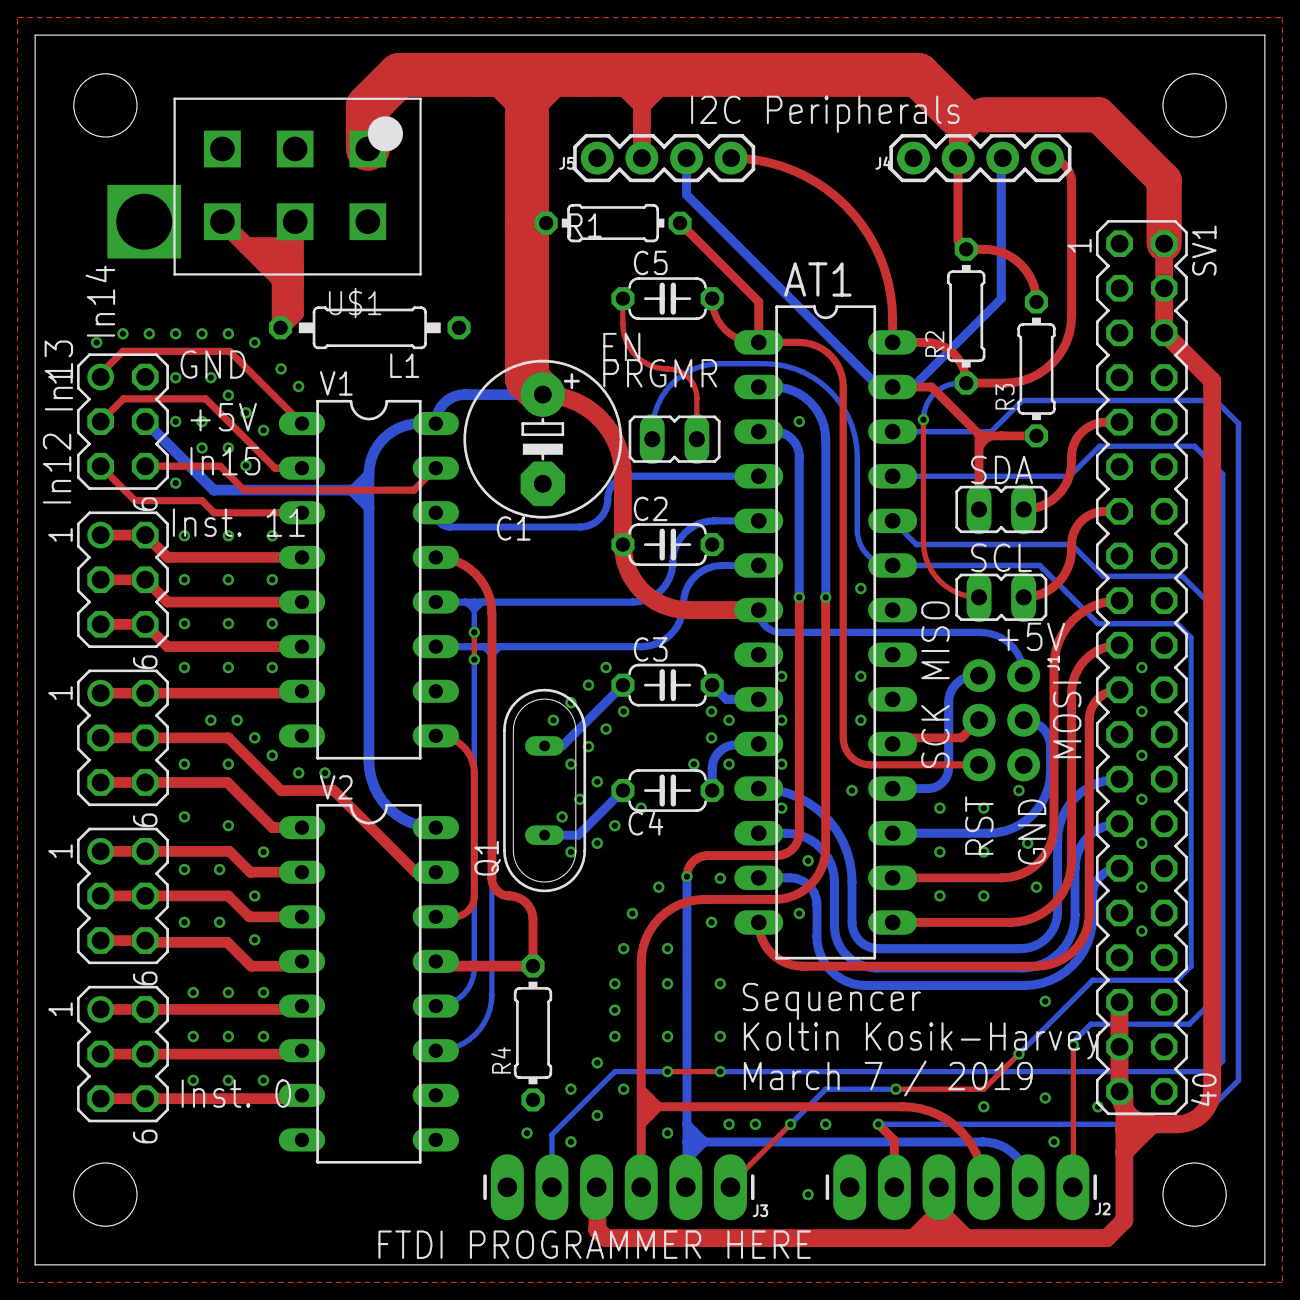
[picture p33: board sequencer_uC.brd from above]

Board: 2 copper layers, 70.0 x 70.0 mm, 29 parts (0 on the bottom side), 49 nets.
