kosikhar/Analog-Drum-Machine/PATA Breakout Sequencer/PATA Breakout Seq2/PATA Breakout 2.brd

## EAGLE design PATA Breakout Sequencer/PATA Breakout Seq2/PATA Breakout 2.brd (2019-03-07)

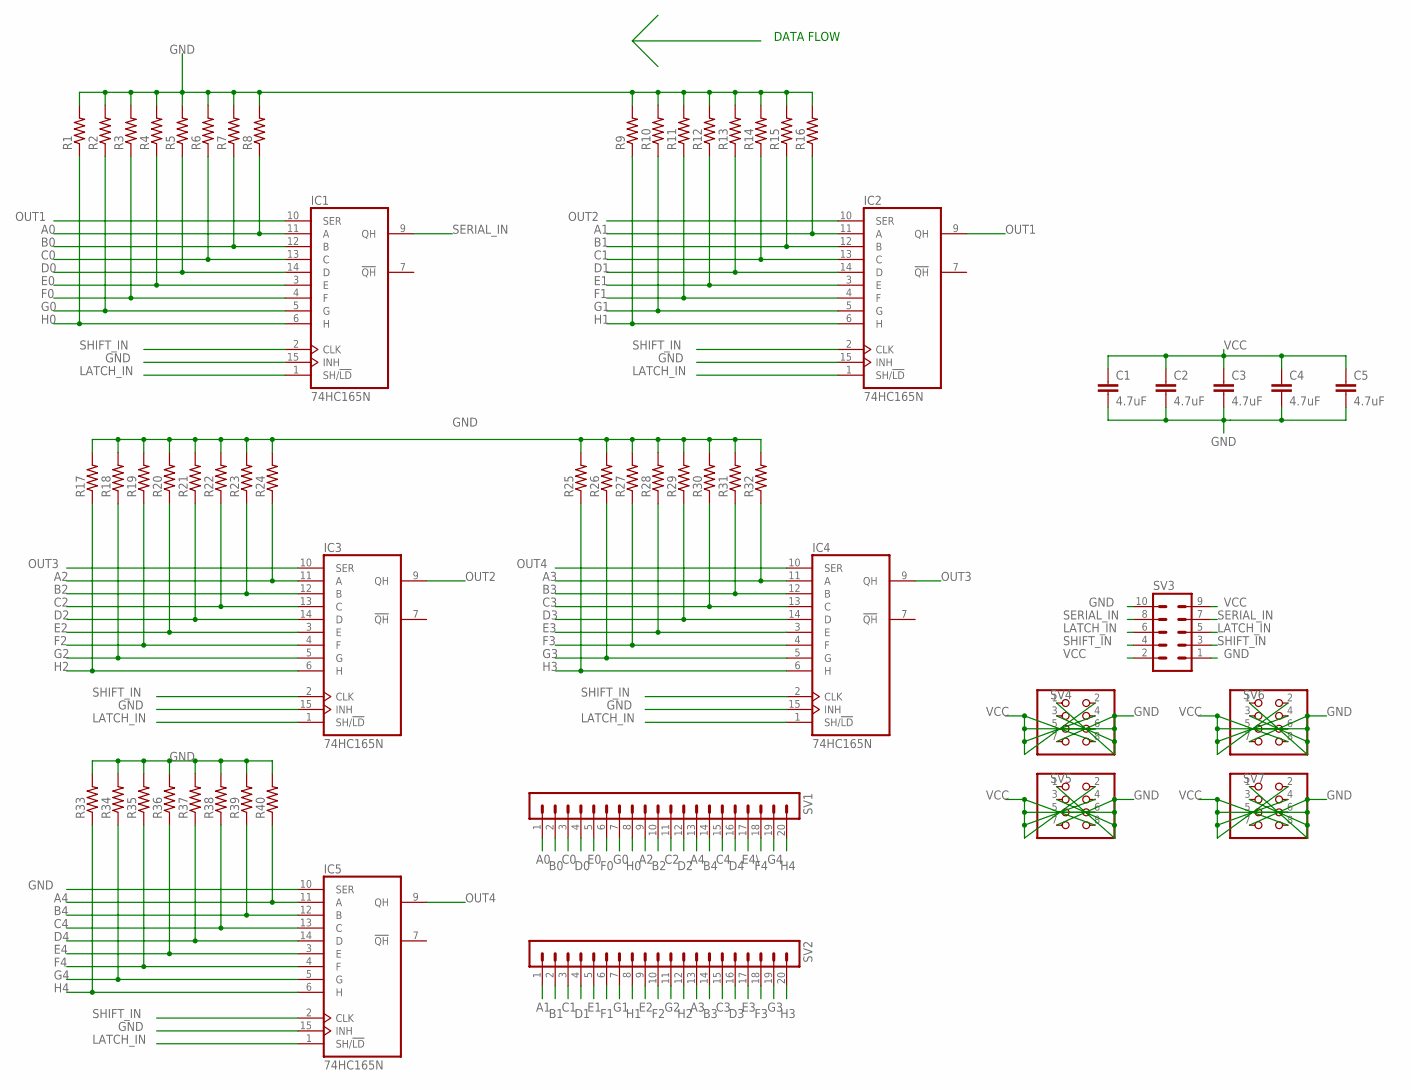
[picture p34: schematic PATA Breakout 2.sch]

Parts:
C1, C2, C3, C4, C5: 4.7uF; C050-024X044
IC1, IC2, IC3, IC4, IC5: 74HC165N; DIL16
R1, R2, R3, R4, R5, R6, R7, R8, R9, R10, R11, R12, R13, R14, R15, R16, R17, R18, R19, R20, R21, R22, R23, R24, R25, R26, R27, R28, R29, R30, R31, R32, R33, R34, R35, R36, R37, R38, R39, R40: R-US_0204/5; 0204/5
SV1, SV2: MA20-1
SV3: MA05-2
SV4, SV5, SV6, SV7: PINHD-2X4; 2X04

Connections:
A0: IC1.11 (A), R8.1, SV1.1
A1: IC2.11 (A), R16.1, SV2.1
A2: IC3.11 (A), R24.1, SV1.9
A3: IC4.11 (A), R32.1, SV2.13
A4: IC5.11 (A), R40.1, SV1.13
B0: IC1.12 (B), R7.1, SV1.2
B1: IC2.12 (B), R15.1, SV2.2
B2: IC3.12 (B), R23.1, SV1.10
B3: IC4.12 (B), R31.1, SV2.14
B4: IC5.12 (B), R39.1, SV1.14
C0: IC1.13 (C), R6.1, SV1.3
C1: IC2.13 (C), R14.1, SV2.3
C2: IC3.13 (C), R22.1, SV1.11
C3: IC4.13 (C), R30.1, SV2.15
C4: IC5.13 (C), R38.1, SV1.15
D0: IC1.14 (D), R5.1, SV1.4
D1: IC2.14 (D), R13.1, SV2.4
D2: IC3.14 (D), R21.1, SV1.12
D3: IC4.14 (D), R29.1, SV2.16
D4: IC5.14 (D), R37.1, SV1.16
E0: IC1.3 (E), R4.1, SV1.5
E1: IC2.3 (E), R12.1, SV2.5
E2: IC3.3 (E), R20.1, SV2.9
E3: IC4.3 (E), R28.1, SV2.17
E4: IC5.3 (E), R36.1
E4\: SV1.17
F0: IC1.4 (F), R3.1, SV1.6
F1: IC2.4 (F), R11.1, SV2.6
F2: IC3.4 (F), R19.1, SV2.10
F3: IC4.4 (F), R27.1, SV2.18
F4: IC5.4 (F), R35.1, SV1.18
G0: IC1.5 (G), R2.1, SV1.7
G1: IC2.5 (G), R10.1, SV2.7
G2: IC3.5 (G), R18.1, SV2.11
G3: IC4.5 (G), R26.1, SV2.19
G4: IC5.5 (G), R34.1, SV1.19
GND: C1.2, C2.2, C3.2, C4.2, C5.2, IC1.8 (GND), IC1.15 (INH), IC2.8 (GND), IC2.15 (INH), IC3.8 (GND), IC3.15 (INH), IC4.8 (GND), IC4.15 (INH), IC5.8 (GND), IC5.10 (SER), IC5.15 (INH), R1.2, R2.2, R3.2, R4.2, R5.2, R6.2, R7.2, R8.2, R9.2, R10.2, R11.2, R12.2, R13.2, R14.2, R15.2, R16.2, R17.2, R18.2, R19.2, R20.2, R21.2, R22.2, R23.2, R24.2, R25.2, R26.2, R27.2, R28.2, R29.2, R30.2, R31.2, R32.2, R33.2, R34.2, R35.2, R36.2, R37.2, R38.2, R39.2, R40.2, SV3.1, SV3.10, SV4.1, SV4.3, SV4.5, SV4.7, SV5.1, SV5.3, SV5.5, SV5.7, SV6.1, SV6.3, SV6.5, SV6.7, SV7.1, SV7.3, SV7.5, SV7.7
H0: IC1.6 (H), R1.1, SV1.8
H1: IC2.6 (H), R9.1, SV2.8
H2: IC3.6 (H), R17.1, SV2.12
H3: IC4.6 (H), R25.1, SV2.20
H4: IC5.6 (H), R33.1, SV1.20
LATCH_IN: IC1.1 (SH/!LD), IC2.1 (SH/!LD), IC3.1 (SH/!LD), IC4.1 (SH/!LD), IC5.1 (SH/!LD), SV3.5, SV3.6
OUT1: IC1.10 (SER), IC2.9 (QH)
OUT2: IC2.10 (SER), IC3.9 (QH)
OUT3: IC3.10 (SER), IC4.9 (QH)
OUT4: IC4.10 (SER), IC5.9 (QH)
SERIAL_IN: IC1.9 (QH), SV3.7, SV3.8
SHIFT_IN: IC1.2 (CLK), IC2.2 (CLK), IC3.2 (CLK), IC4.2 (CLK), IC5.2 (CLK), SV3.3, SV3.4
VCC: C1.1, C2.1, C3.1, C4.1, C5.1, IC1.16 (VCC), IC2.16 (VCC), IC3.16 (VCC), IC4.16 (VCC), IC5.16 (VCC), SV3.2, SV3.9, SV4.2, SV4.4, SV4.6, SV4.8, SV5.2, SV5.4, SV5.6, SV5.8, SV6.2, SV6.4, SV6.6, SV6.8, SV7.2, SV7.4, SV7.6, SV7.8

Notes on the sheet:
DATA FLOW

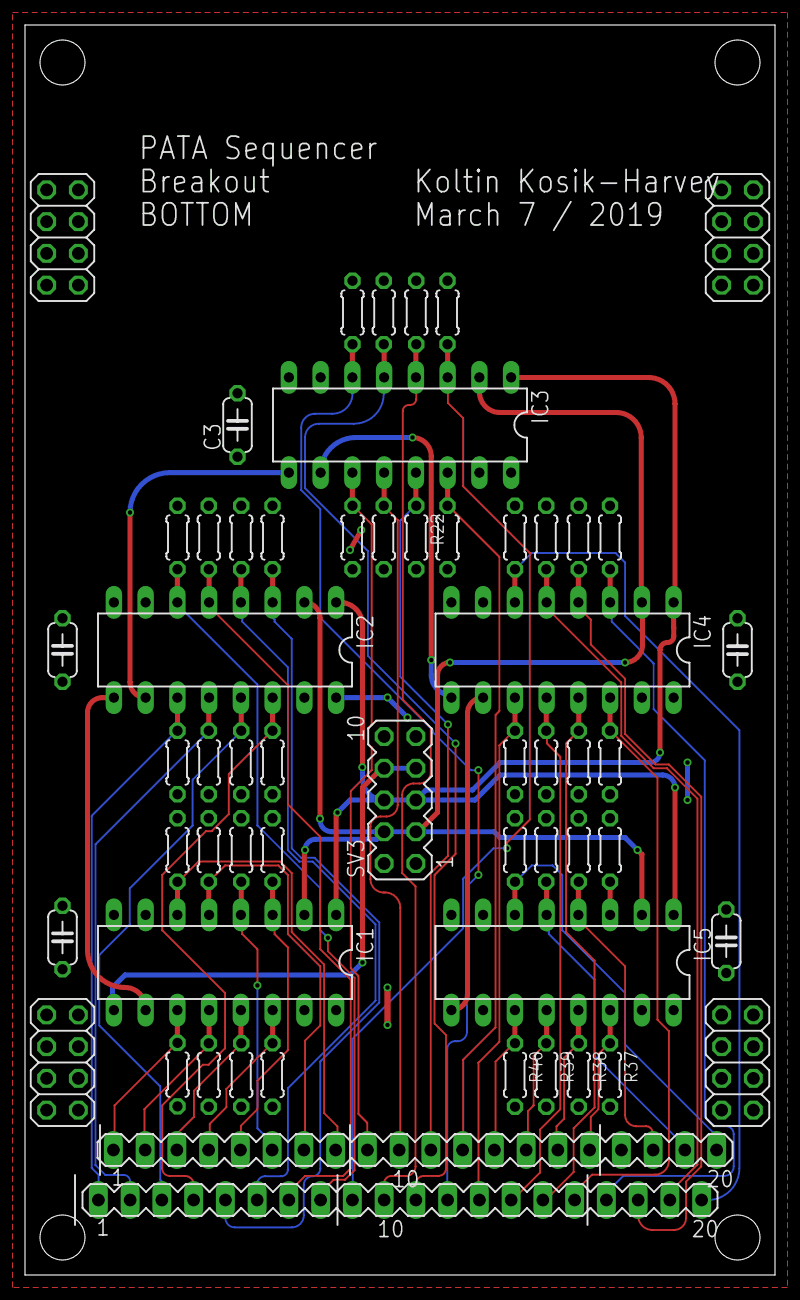
[picture p35: board PATA Breakout 2.brd from above]

Board: 2 copper layers, 60.0 x 100.0 mm, 57 parts (0 on the bottom side), 49 nets.
