kosikhar/Analog-Drum-Machine/PATA Breakout/PATA Breakout.brd

## EAGLE design PATA Breakout/PATA Breakout.brd (2019-03-07)

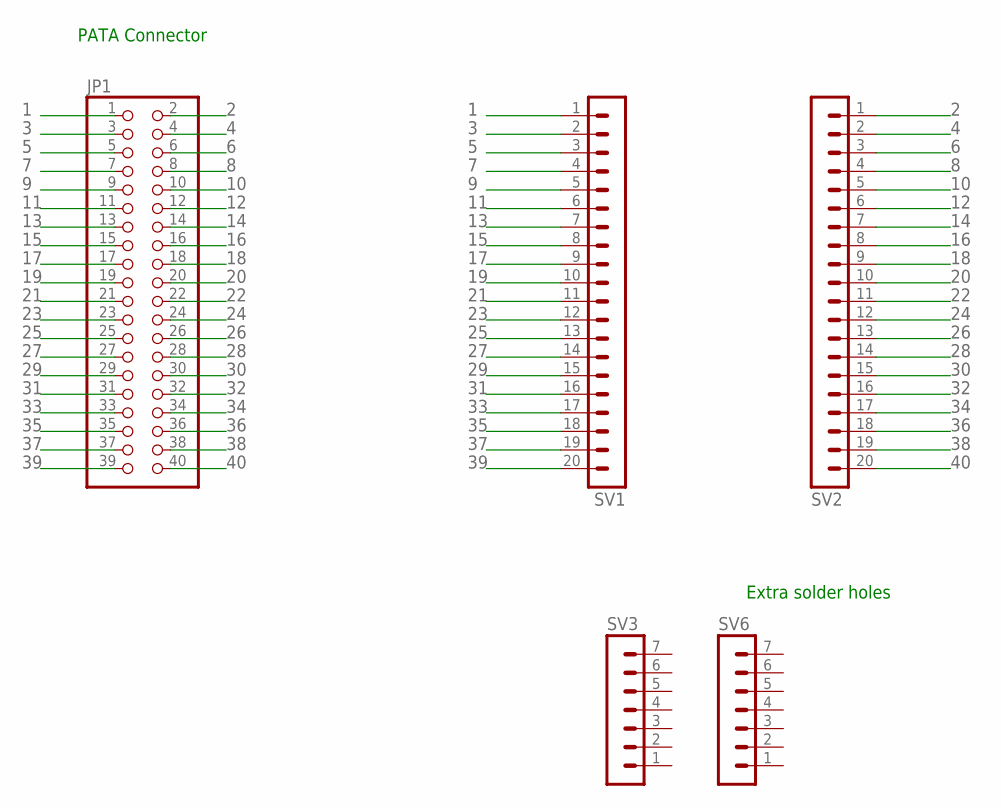
[picture p36: schematic PATA Breakout.sch]

Parts:
JP1: PINHD-2X20; 2X20
SV1, SV2: MA20-1L
SV3, SV6: MA07-1

Connections:
1: JP1.1, SV1.1
2: JP1.2, SV2.1
3: JP1.3, SV1.2
4: JP1.4, SV2.2
5: JP1.5, SV1.3
6: JP1.6, SV2.3
7: JP1.7, SV1.4
8: JP1.8, SV2.4
9: JP1.9, SV1.5
10: JP1.10, SV2.5
11: JP1.11, SV1.6
12: JP1.12, SV2.6
13: JP1.13, SV1.7
14: JP1.14, SV2.7
15: JP1.15, SV1.8
16: JP1.16, SV2.8
17: JP1.17, SV1.9
18: JP1.18, SV2.9
19: JP1.19, SV1.10
20: JP1.20, SV2.10
21: JP1.21, SV1.11
22: JP1.22, SV2.11
23: JP1.23, SV1.12
24: JP1.24, SV2.12
25: JP1.25, SV1.13
26: JP1.26, SV2.13
27: JP1.27, SV1.14
28: JP1.28, SV2.14
29: JP1.29, SV1.15
30: JP1.30, SV2.15
31: JP1.31, SV1.16
32: JP1.32, SV2.16
33: JP1.33, SV1.17
34: JP1.34, SV2.17
35: JP1.35, SV1.18
36: JP1.36, SV2.18
37: JP1.37, SV1.19
38: JP1.38, SV2.19
39: JP1.39, SV1.20
40: JP1.40, SV2.20

Notes on the sheet:
PATA Connector
Extra solder holes

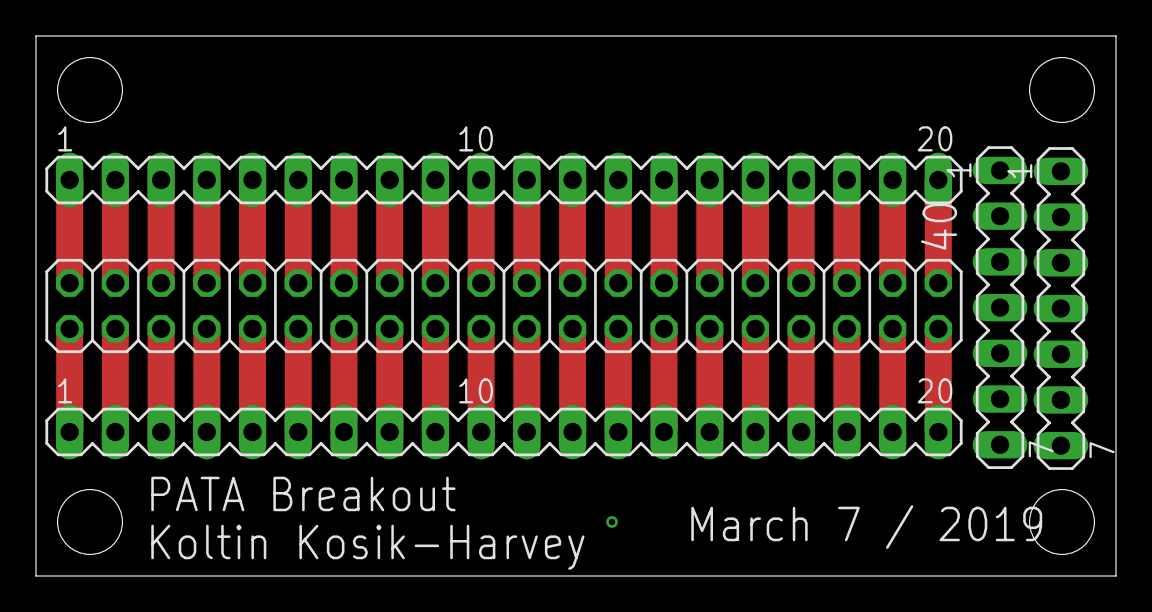
[picture p37: board PATA Breakout.brd from above]

Board: 2 copper layers, 60.0 x 30.0 mm, 5 parts (0 on the bottom side), 40 nets.
