kosikhar/Analog-Drum-Machine/Analog Drums/EAGLE/Analog Drum.brd

## EAGLE design Analog Drums/EAGLE/Analog Drum.brd (2019-03-07)

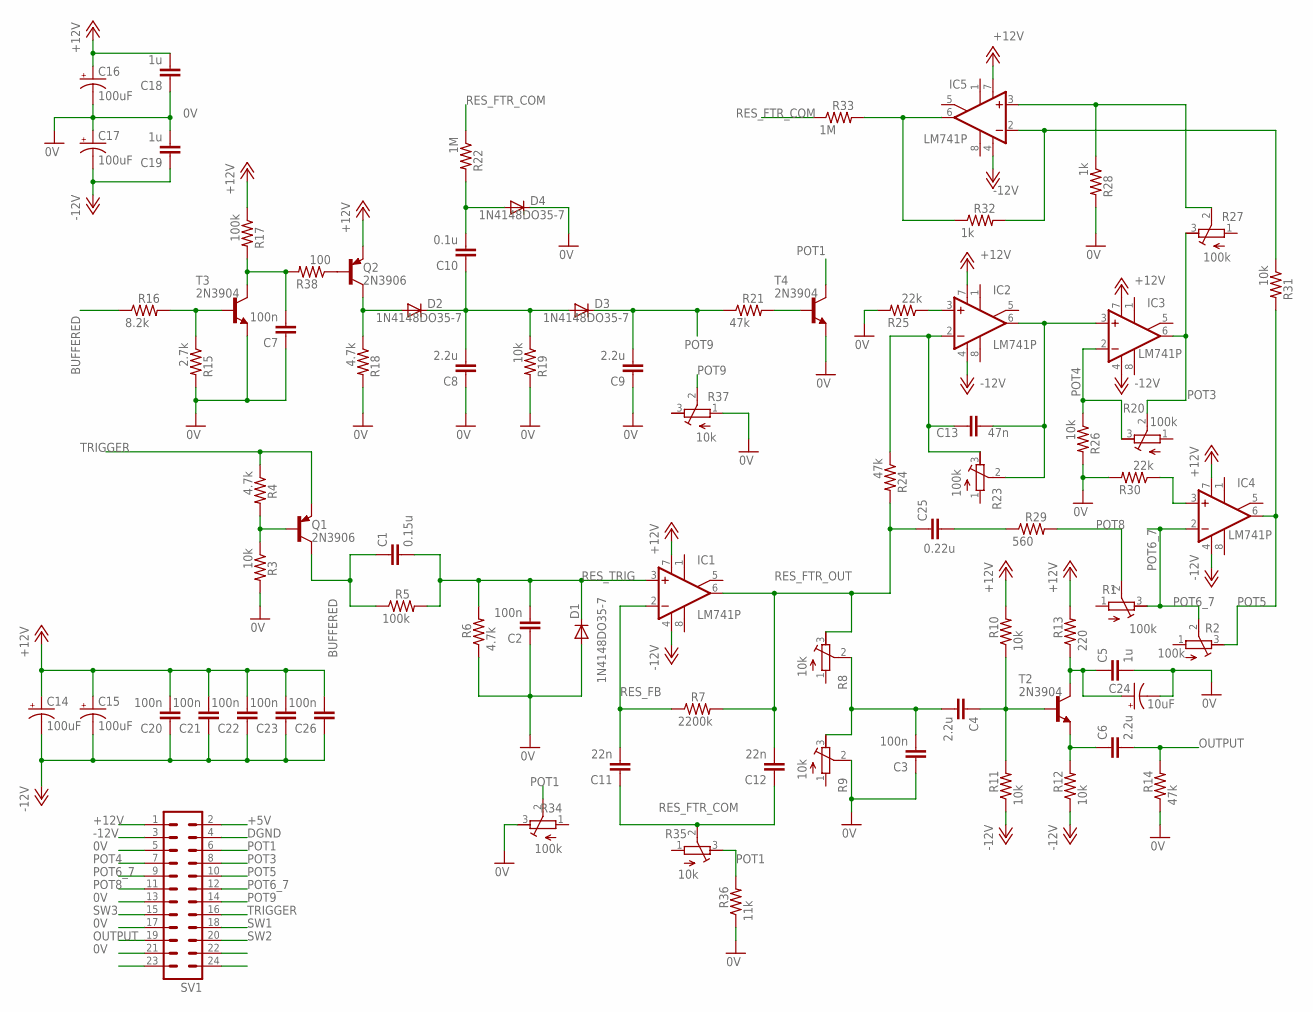
[picture p38: schematic Analog Drum.sch]

Parts:
C1: 0.15u; C050-024X044
C2, C3, C7, C20, C21, C22, C23, C26: 100n; C050-024X044
C4, C6, C8, C9: 2.2u; C050-024X044
C5, C18, C19: 1u; C050-024X044
C10: 0.1u; C050-024X044
C11, C12: 22n; C050-024X044
C13: 47n; C050-024X044
C14, C15, C16, C17: 100uF; E5-8,5
C24: 10uF; E2,5-6
C25: 0.22u; C050-024X044
D1, D2, D3, D4: 1N4148DO35-7; DO35-7
IC1, IC2, IC3, IC4, IC5: LM741P; DIL08
Q1, Q2: 2N3906; TO92
R1, R2, R20, R23, R27, R34: 100k; RTRIM64W
R3, R10, R11, R12, R19, R26, R31: 10k; 0207/10
R4, R6, R18: 4.7k; 0207/10
R5, R17: 100k; 0207/10
R7: 2200k; 0207/10
R8, R9, R35, R37: 10k; RTRIM64W
R13: 220; 0207/10
R14, R21, R24: 47k; 0207/10
R15: 2.7k; 0207/10
R16: 8.2k; 0207/10
R22, R33: 1M; 0207/10
R25, R30: 22k; 0207/10
R28, R32: 1k; 0207/10
R29: 560; 0207/10
R36: 11k; 0207/10
R38: 100; 0207/10
SV1: MA12-2
T2, T3, T4: 2N3904; TO92

Connections:
0V: C2.1, C3.1, C5.2, C7.1, C8.1, C9.1, C16.-, C17.+, C18.1, C19.2, C24.-, D1.A, D4.C, R3.2, R6.1, R9.2 (S), R14.1, R15.2, R18.2, R19.2, R25.2, R26.2, R28.2, R30.2, R34.3 (E), R36.1, R37.1 (A), SV1.5, SV1.13, SV1.17, SV1.21, T3.3 (E), T4.3 (E)
+5V: SV1.2
+12V: C14.+, C15.+, C16.+, C18.2, C20.2, C21.2, C22.2, C23.2, C26.2, IC1.7 (V+), IC2.7 (V+), IC3.7 (V+), IC4.7 (V+), IC5.7 (V+), Q2.3 (E), R10.2, R13.2, R17.1, SV1.1
-12V: C14.-, C15.-, C17.-, C19.1, C20.1, C21.1, C22.1, C23.1, C26.1, IC1.4 (V-), IC2.4 (V-), IC3.4 (V-), IC4.4 (V-), IC5.4 (V-), R11.1, R12.1, SV1.3
BUFFERED: C1.1, Q1.1 (C), R5.1, R16.1
DGND: SV1.4
unnamed: C25.2, R29.1
unnamed: IC4.3 (+IN), R30.1
unnamed: Q1.2 (B), R3.1, R4.2
unnamed: C10.2, D4.A, R22.2
unnamed: Q2.2 (B), R38.1
unnamed: IC2.3 (+IN), R25.1
unnamed: C3.2, C4.2, R8.2 (S), R9.3 (E)
unnamed: C4.1, R10.1, R11.2, T2.2 (B)
unnamed: C6.1, R12.2, T2.3 (E)
unnamed: C5.1, C24.+, R13.1, T2.1 (C)
unnamed: C13.2, IC2.2 (-IN), R23.3 (E), R24.1
unnamed: R15.1, R16.2, T3.2 (B)
unnamed: C7.2, R17.2, R38.2, T3.1 (C)
unnamed: D2.A, Q2.1 (C), R18.1
unnamed: C8.2, C10.1, D2.C, D3.A, R19.1
unnamed: R21.2, T4.2 (B)
unnamed: C13.1, IC2.6 (OUT), IC3.3 (+IN), R23.2 (S)
unnamed: IC5.3 (+IN), R27.2 (S), R28.1
unnamed: IC5.2 (-IN), R31.1, R32.2
unnamed: IC5.6 (OUT), R32.1, R33.2
OUTPUT: C6.2, R14.2, SV1.19
POT1: R34.2 (S), R35.3 (E), R36.2, SV1.6, T4.1 (C)
POT3: IC3.6 (OUT), R20.2 (S), R27.3 (E), SV1.8
POT4: IC3.2 (-IN), R20.3 (E), R26.1, SV1.7
POT5: IC4.6 (OUT), R2.3 (E), R31.2, SV1.10
POT6_7: IC4.2 (-IN), R1.3 (E), R2.2 (S), SV1.9, SV1.12
POT8: R1.2 (S), R29.2, SV1.11
POT9: C9.2, D3.C, R21.1, R37.2 (S), SV1.14
RES_FB: C11.2, IC1.2 (-IN), R7.1
RES_FTR_COM: C11.1, C12.1, R22.1, R33.1, R35.2 (S)
RES_FTR_OUT: C12.2, C25.1, IC1.6 (OUT), R7.2, R8.3 (E), R24.2
RES_TRIG: C1.2, C2.2, D1.C, IC1.3 (+IN), R5.2, R6.2
SW1: SV1.18
SW2: SV1.20
SW3: SV1.15
TRIGGER: Q1.3 (E), R4.1, SV1.16

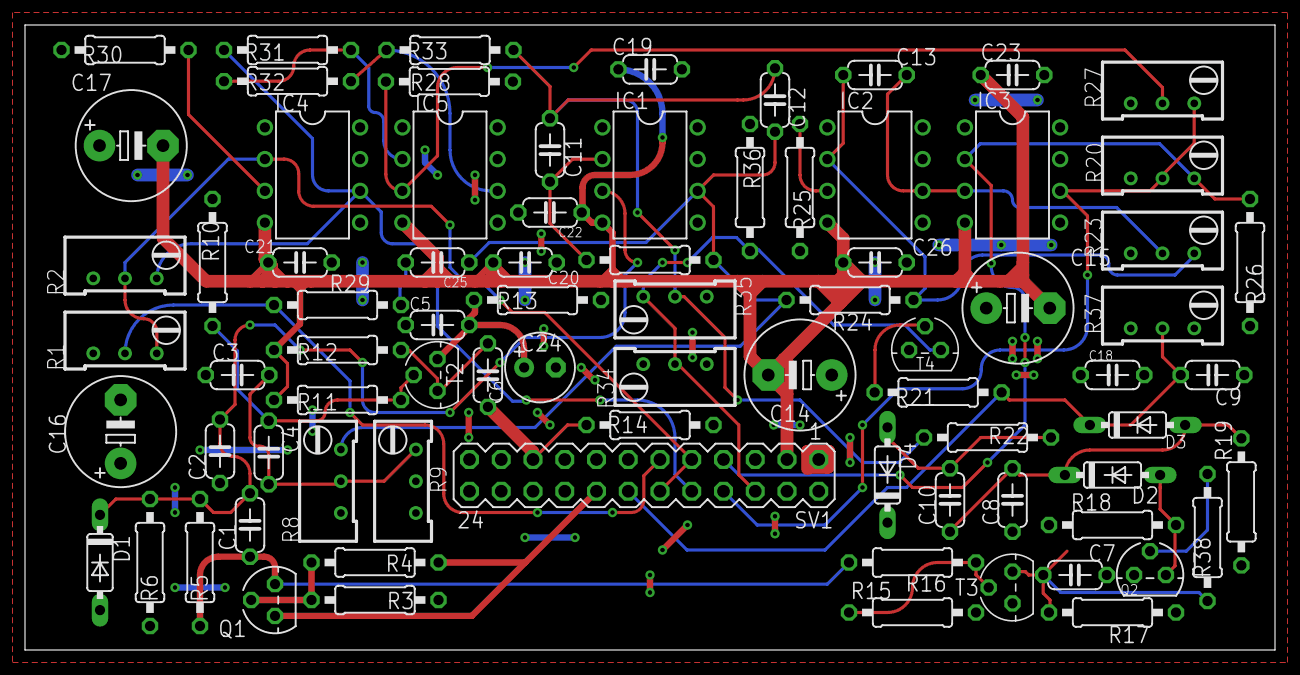
[picture p39: board Analog Drum.brd from above]

Board: 2 copper layers, 100.0 x 50.0 mm, 79 parts (0 on the bottom side), 37 nets.
