kosikhar/Analog-Drum-Machine/MainBoard/Main board.brd

## EAGLE design MainBoard/Main board.brd (2019-03-07)

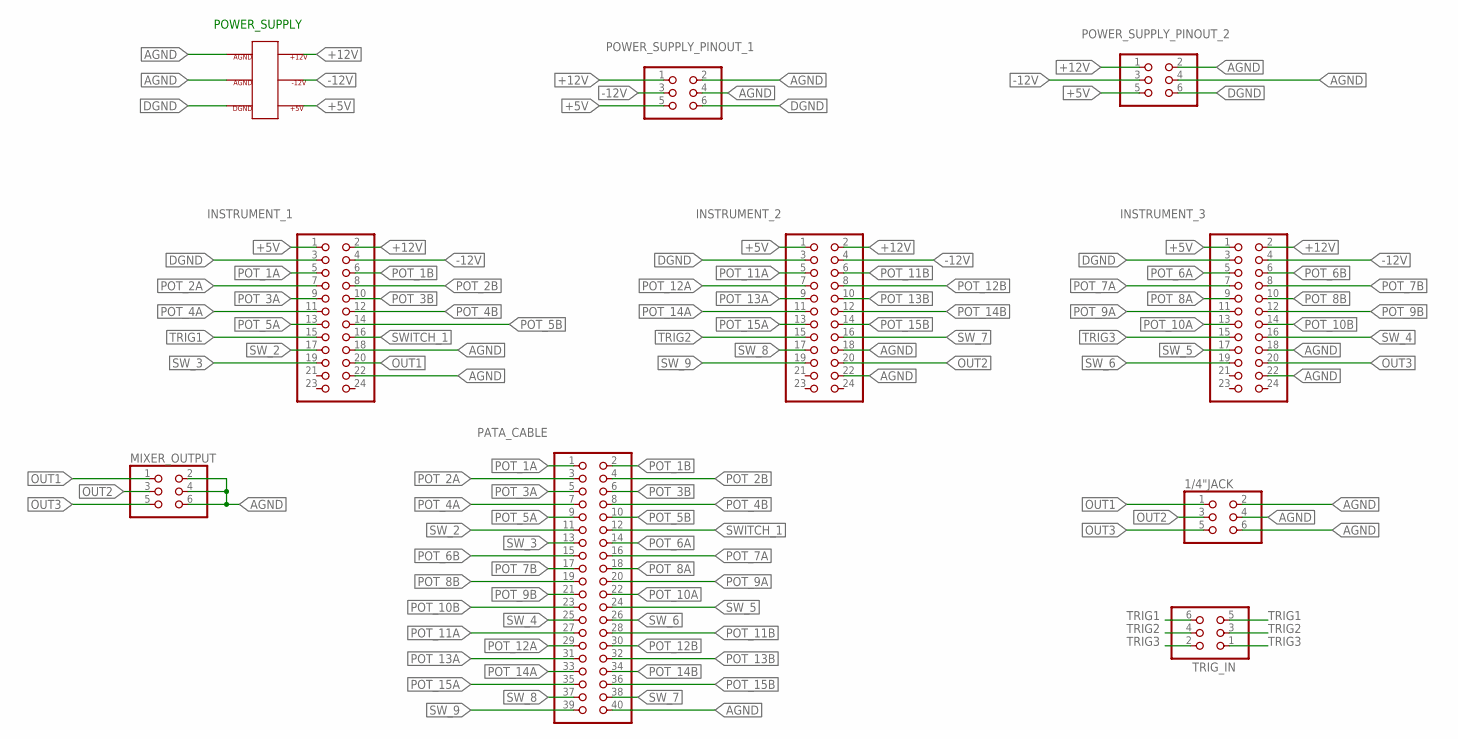
[picture p40: schematic Main board.sch]

Parts:
1/4"JACK: PINHD-2X3; 2X03
INSTRUMENT_1, INSTRUMENT_2, INSTRUMENT_3: PINHD-2X12; 2X12
MIXER_OUTPUT: PINHD-2X3; 2X03
PATA_CABLE: PINHD-2X20; 2X20
POWER_SUPPLY: TER6PIN_VERT; CAPSTONE_1-770875-0
POWER_SUPPLY_PINOUT_1, POWER_SUPPLY_PINOUT_2: PINHD-2X3; 2X03
TRIG_IN: PINHD-2X3; 2X03

Connections:
+5V: INSTRUMENT_1.1, INSTRUMENT_2.1, INSTRUMENT_3.1, POWER_SUPPLY.+5V, POWER_SUPPLY.NULL (+5V), POWER_SUPPLY_PINOUT_1.5, POWER_SUPPLY_PINOUT_2.5
+12V: INSTRUMENT_1.2, INSTRUMENT_2.2, INSTRUMENT_3.2, POWER_SUPPLY.+12V, POWER_SUPPLY_PINOUT_1.1, POWER_SUPPLY_PINOUT_2.1
-12V: INSTRUMENT_1.4, INSTRUMENT_2.4, INSTRUMENT_3.4, POWER_SUPPLY.-12V, POWER_SUPPLY_PINOUT_1.3, POWER_SUPPLY_PINOUT_2.3
AGND: 1/4"JACK.2, 1/4"JACK.4, 1/4"JACK.6, INSTRUMENT_1.18, INSTRUMENT_1.22, INSTRUMENT_2.18, INSTRUMENT_2.22, INSTRUMENT_3.18, INSTRUMENT_3.22, MIXER_OUTPUT.2, MIXER_OUTPUT.4, MIXER_OUTPUT.6, PATA_CABLE.40, POWER_SUPPLY.AGND0, POWER_SUPPLY.AGND1, POWER_SUPPLY_PINOUT_1.2, POWER_SUPPLY_PINOUT_1.4, POWER_SUPPLY_PINOUT_2.2, POWER_SUPPLY_PINOUT_2.4
DGND: INSTRUMENT_1.3, INSTRUMENT_2.3, INSTRUMENT_3.3, POWER_SUPPLY.DGND, POWER_SUPPLY_PINOUT_1.6, POWER_SUPPLY_PINOUT_2.6
OUT1: 1/4"JACK.1, INSTRUMENT_1.20, MIXER_OUTPUT.1
OUT2: 1/4"JACK.3, INSTRUMENT_2.20, MIXER_OUTPUT.3
OUT3: 1/4"JACK.5, INSTRUMENT_3.20, MIXER_OUTPUT.5
POT_1A: INSTRUMENT_1.5, PATA_CABLE.1
POT_1B: INSTRUMENT_1.6, PATA_CABLE.2
POT_2A: INSTRUMENT_1.7, PATA_CABLE.3
POT_2B: INSTRUMENT_1.8, PATA_CABLE.4
POT_3A: INSTRUMENT_1.9, PATA_CABLE.5
POT_3B: INSTRUMENT_1.10, PATA_CABLE.6
POT_4A: INSTRUMENT_1.11, PATA_CABLE.7
POT_4B: INSTRUMENT_1.12, PATA_CABLE.8
POT_5A: INSTRUMENT_1.13, PATA_CABLE.9
POT_5B: INSTRUMENT_1.14, PATA_CABLE.10
POT_6A: INSTRUMENT_3.5, PATA_CABLE.14
POT_6B: INSTRUMENT_3.6, PATA_CABLE.15
POT_7A: INSTRUMENT_3.7, PATA_CABLE.16
POT_7B: INSTRUMENT_3.8, PATA_CABLE.17
POT_8A: INSTRUMENT_3.9, PATA_CABLE.18
POT_8B: INSTRUMENT_3.10, PATA_CABLE.19
POT_9A: INSTRUMENT_3.11, PATA_CABLE.20
POT_9B: INSTRUMENT_3.12, PATA_CABLE.21
POT_10A: INSTRUMENT_3.13, PATA_CABLE.22
POT_10B: INSTRUMENT_3.14, PATA_CABLE.23
POT_11A: INSTRUMENT_2.5, PATA_CABLE.27
POT_11B: INSTRUMENT_2.6, PATA_CABLE.28
POT_12A: INSTRUMENT_2.7, PATA_CABLE.29
POT_12B: INSTRUMENT_2.8, PATA_CABLE.30
POT_13A: INSTRUMENT_2.9, PATA_CABLE.31
POT_13B: INSTRUMENT_2.10, PATA_CABLE.32
POT_14A: INSTRUMENT_2.11, PATA_CABLE.33
POT_14B: INSTRUMENT_2.12, PATA_CABLE.34
POT_15A: INSTRUMENT_2.13, PATA_CABLE.35
POT_15B: INSTRUMENT_2.14, PATA_CABLE.36
SWITCH_1: INSTRUMENT_1.16, PATA_CABLE.12
SW_2: INSTRUMENT_1.17, PATA_CABLE.11
SW_3: INSTRUMENT_1.19, PATA_CABLE.13
SW_4: INSTRUMENT_3.16, PATA_CABLE.25
SW_5: INSTRUMENT_3.17, PATA_CABLE.24
SW_6: INSTRUMENT_3.19, PATA_CABLE.26
SW_7: INSTRUMENT_2.16, PATA_CABLE.38
SW_8: INSTRUMENT_2.17, PATA_CABLE.37
SW_9: INSTRUMENT_2.19, PATA_CABLE.39
TRIG1: INSTRUMENT_1.15, TRIG_IN.5, TRIG_IN.6
TRIG2: INSTRUMENT_2.15, TRIG_IN.3, TRIG_IN.4
TRIG3: INSTRUMENT_3.15, TRIG_IN.1, TRIG_IN.2

Notes on the sheet:
POWER_SUPPLY

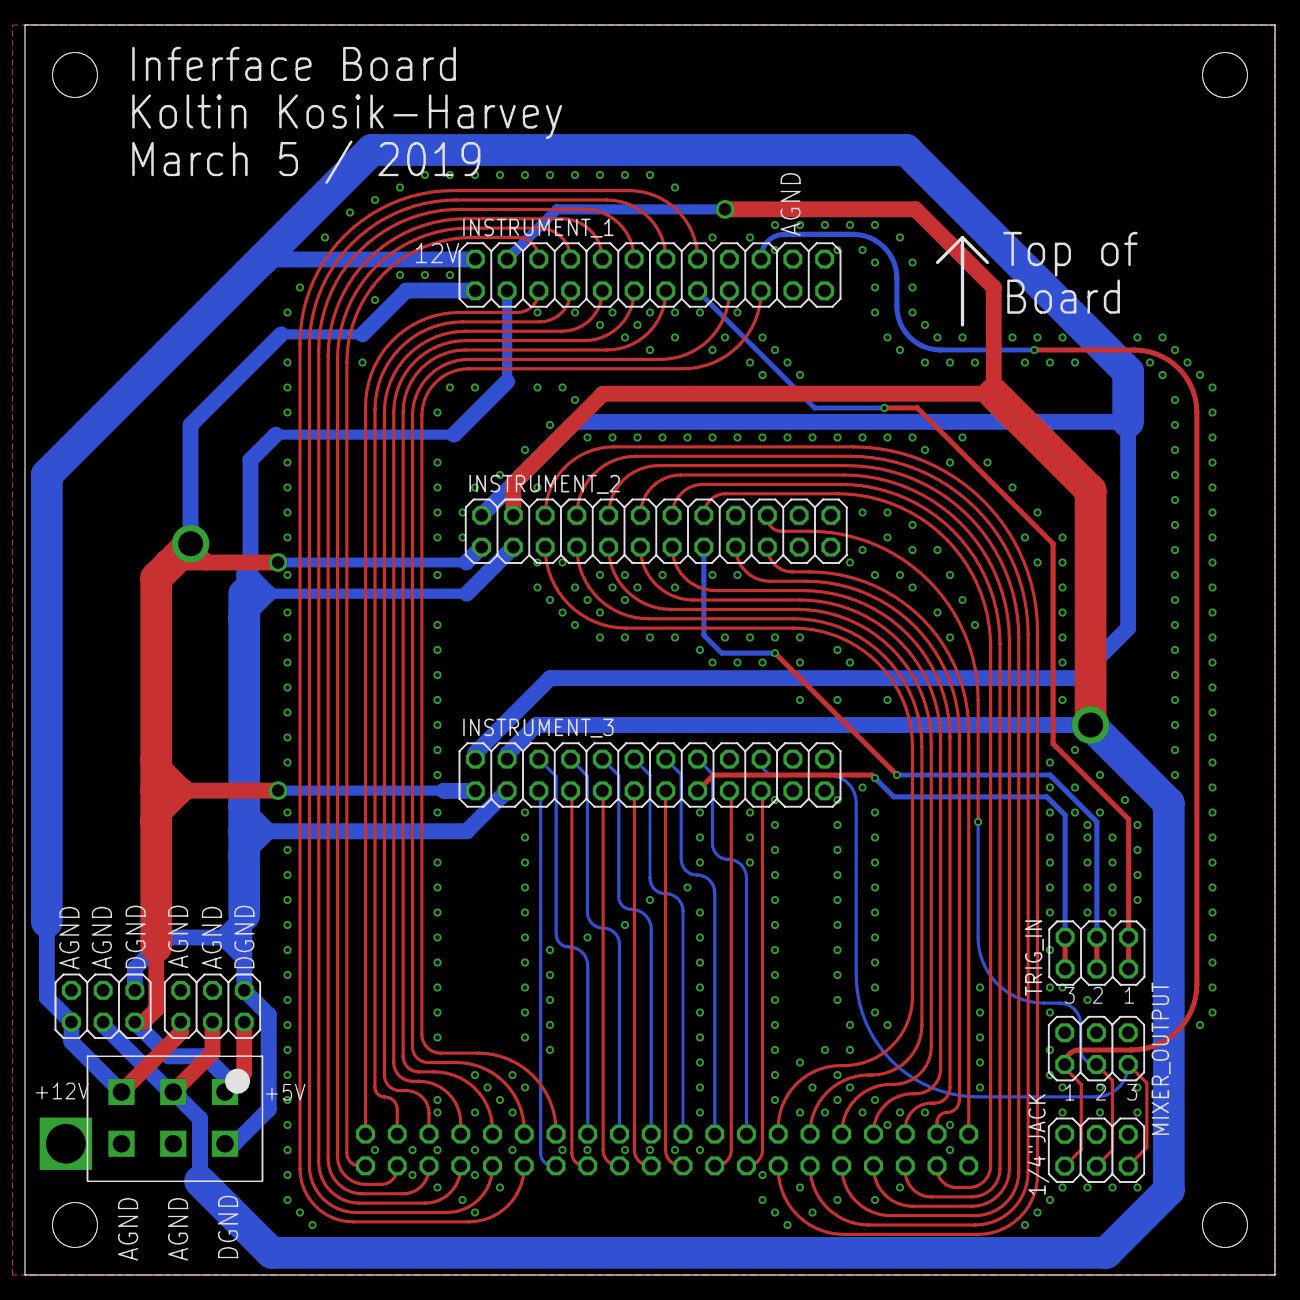
[picture p41: board Main board.brd from above]

Board: 2 copper layers, 100.0 x 100.0 mm, 10 parts (1 on the bottom side), 50 nets.
