kosikhar/Analog-Drum-Machine/Power Supply/PCB/Power Supply.brd

## EAGLE design Power Supply/PCB/Power Supply.brd (2019-01-28)

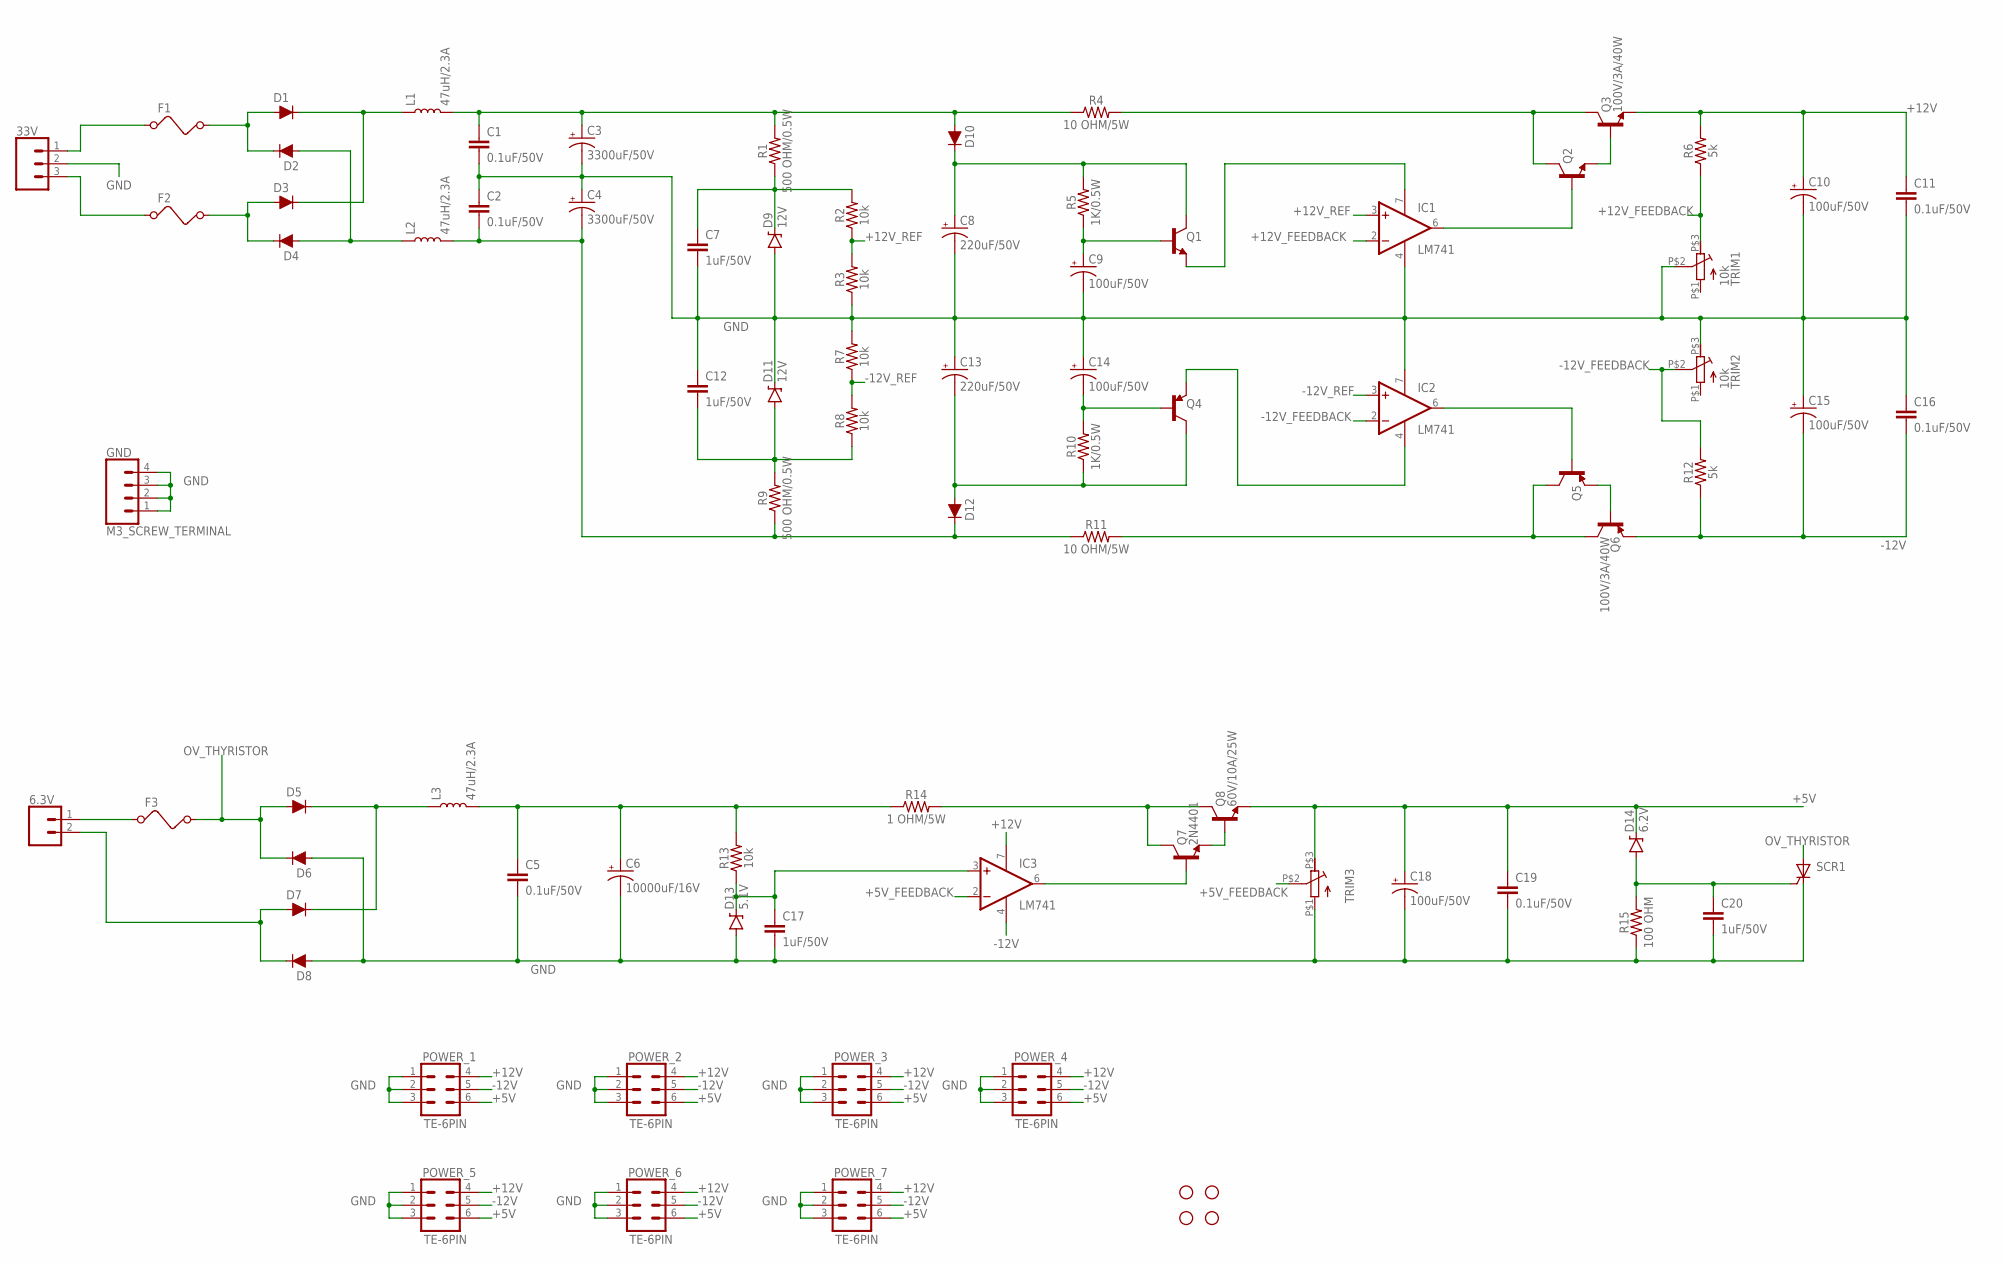
[picture p42: schematic Power Supply.sch]

Parts:
6.3V: TE-2PIN; 2_PIN_CONNECT
33V: TE-3PIN; 3_PIN_TE
C1, C2, C5, C11, C16, C19: 0.1uF/50V; CERAMIC_CAPACITOR
C3, C4: 3300uF/50V; POLARIZED_CAP_3300UF
C6: 10000uF/16V; POLARIZED_CAP_3300UF
C7, C12, C17, C20: 1uF/50V; CERAMIC_CAPACITOR
C8, C13: 220uF/50V; 220UF_CAP
C9, C10, C14, C15, C18: 100uF/50V; 100UF_CAP
D1, D2, D3, D4, D5, D6, D7, D8, D10, D12: 1N4005; DIODE-1N4001
D9, D11: 12V; 1W_ZENER
D13: 5.1V; 1W_ZENER
D14: 6.2V; 1W_ZENER
F1, F2, F3: FUSE; FUSEHOLDER
GND: M3_SCREW_TERMINAL
H1, H2, H3, H4: STAND-OFF
IC1, IC2, IC3: LM741; DIL08
L1, L2, L3: 47uH/2.3A; 47UH_2.3A_COIL
POWER_1, POWER_2, POWER_3, POWER_4, POWER_5, POWER_6, POWER_7: TE-6PIN; TE_6_PIN
Q1, Q2, Q7: 2N4401; TO-92
Q3, Q6: 100V/3A/40W; TO-220_LARGE_HEATSINK
Q4, Q5: 2N4403; TO-92
Q8: 60V/10A/25W; TO-220_SMALL_HEATSINK
R1, R9: 500 OHM/0.5W; 0.5W_RES
R2, R3, R7, R8, R13: 10k; 0.25W_RES
R4, R11: 10 OHM/5W; 5W_RES
R5, R10: 1K/0.5W; 0.5W_RES
R6, R12: 5k; 0.25W_RES
R14: 1 OHM/5W; 5W_RES
R15: 100 OHM; 0.25W_RES
SCR1: THYRISTOR_4A; TO220V
TRIM1, TRIM2: 10k; 10K_TRIM
TRIM3: 10K_TRIMMER; 10K_TRIM

Connections:
+5V: C18.P1+ (+), C19.P$1 (1), D14.P$2CATHODE (C), POWER_1.6, POWER_2.6, POWER_3.6, POWER_4.6, POWER_5.6, POWER_6.6, POWER_7.6, Q8.P$3 (E), TRIM3.P$3 (E)
+5V_FEEDBACK: IC3.2 (-IN), TRIM3.P$2 (S)
+12V: C10.P1+ (+), C11.P$1 (1), IC3.7 (V+), POWER_1.4 (2), POWER_2.4 (2), POWER_3.4 (2), POWER_4.4 (2), POWER_5.4 (2), POWER_6.4 (2), POWER_7.4 (2), Q3.P$3 (E), R6.P$2 (2)
+12V_FEEDBACK: IC1.2 (-IN), R6.P$1 (1), TRIM1.P$3 (E)
+12V_REF: IC1.3 (+IN), R2.P$1 (1), R3.P$2 (2)
-12V: C15.P2- (-), C16.P$2 (2), IC3.4 (V-), POWER_1.5 (4), POWER_2.5 (4), POWER_3.5 (4), POWER_4.5 (4), POWER_5.5 (4), POWER_6.5 (4), POWER_7.5 (4), Q6.P$3 (E), R12.P$1 (1)
-12V_FEEDBACK: IC2.2 (-IN), R12.P$2 (2), TRIM2.P$2 (S)
-12V_REF: IC2.3 (+IN), R7.P$1 (1), R8.P$2 (2)
GND: 33V.2, C1.P$2 (2), C2.P$1 (1), C3.P2- (-), C4.P1+ (+), C5.P$2 (2), C6.P2- (-), C7.P$2 (2), C8.P2- (-), C9.P2- (-), C10.P2- (-), C11.P$2 (2), C12.P$1 (1), C13.P1+ (+), C14.P1+ (+), C15.P1+ (+), C16.P$1 (1), C17.P$2 (2), C18.P2- (-), C19.P$2 (2), C20.P$2 (2), D6.A, D8.A, D9.P$1ANODE (A), D11.P$2CATHODE (C), D13.P$1ANODE (A), GND.1, GND.2, GND.3, GND.4, IC1.4 (V-), IC2.7 (V+), POWER_1.1, POWER_1.2 (3), POWER_1.3 (5), POWER_2.1, POWER_2.2 (3), POWER_2.3 (5), POWER_3.1, POWER_3.2 (3), POWER_3.3 (5), POWER_4.1, POWER_4.2 (3), POWER_4.3 (5), POWER_5.1, POWER_5.2 (3), POWER_5.3 (5), POWER_6.1, POWER_6.2 (3), POWER_6.3 (5), POWER_7.1, POWER_7.2 (3), POWER_7.3 (5), R3.P$1 (1), R7.P$2 (2), R15.P$1 (1), SCR1.1 (C), TRIM1.P$2 (S), TRIM2.P$3 (E), TRIM3.P$1 (A)
unnamed: D1.C, D3.C, L1.P$1 (1)
unnamed: D1.A, D2.C, F1.P$2 (2)
unnamed: D3.A, D4.C, F2.P$2 (2)
unnamed: D2.A, D4.A, L2.P$1 (1)
unnamed: 33V.1 (3), F1.P$1 (1)
unnamed: 33V.3 (1), F2.P$1 (1)
unnamed: C1.P$1 (1), C3.P1+ (+), D10.A, L1.P$2 (2), R1.P$2 (2), R4.P$1 (1)
unnamed: C8.P1+ (+), D10.C, Q1.3 (C), R5.P$2 (2)
unnamed: C2.P$2 (2), C4.P2- (-), D12.C, L2.P$2 (2), R9.P$1 (1), R11.P$1 (1)
unnamed: C9.P1+ (+), Q1.2 (B), R5.P$1 (1)
unnamed: IC1.7 (V+), Q1.1 (E)
unnamed: Q2.3 (C), Q3.P$2 (C), R4.P$2 (2)
unnamed: Q2.1 (E), Q3.P$1 (B)
unnamed: IC1.6 (OUT), Q2.2 (B)
unnamed: C7.P$1 (1), D9.P$2CATHODE (C), R1.P$1 (1), R2.P$2 (2)
unnamed: C13.P2- (-), D12.A, Q4.3 (C), R10.P$1 (1)
unnamed: C17.P$1 (1), D13.P$2CATHODE (C), IC3.3 (+IN), R13.P$1 (1)
unnamed: C12.P$2 (2), D11.P$1ANODE (A), R8.P$1 (1), R9.P$2 (2)
unnamed: 6.3V.1 (2), F3.P$1 (1)
unnamed: C14.P2- (-), Q4.2 (B), R10.P$2 (2)
unnamed: IC2.4 (V-), Q4.1 (E)
unnamed: Q5.3 (C), Q6.P$2 (C), R11.P$2 (2)
unnamed: Q5.1 (E), Q6.P$1 (B)
unnamed: IC2.6 (OUT), Q5.2 (B)
unnamed: Q7.3 (C), Q8.P$2 (C), R14.P$2 (2)
unnamed: 6.3V.2 (1), D7.A, D8.C
unnamed: IC3.6 (OUT), Q7.2 (B)
unnamed: D5.C, D7.C, L3.P$1 (1)
unnamed: C5.P$1 (1), C6.P1+ (+), L3.P$2 (2), R13.P$2 (2), R14.P$1 (1)
unnamed: Q7.1 (E), Q8.P$1 (B)
unnamed: C20.P$1 (1), D14.P$1ANODE (A), R15.P$2 (2), SCR1.3 (G)
OV_THYRISTOR: D5.A, D6.C, F3.P$2 (2), SCR1.2 (A)

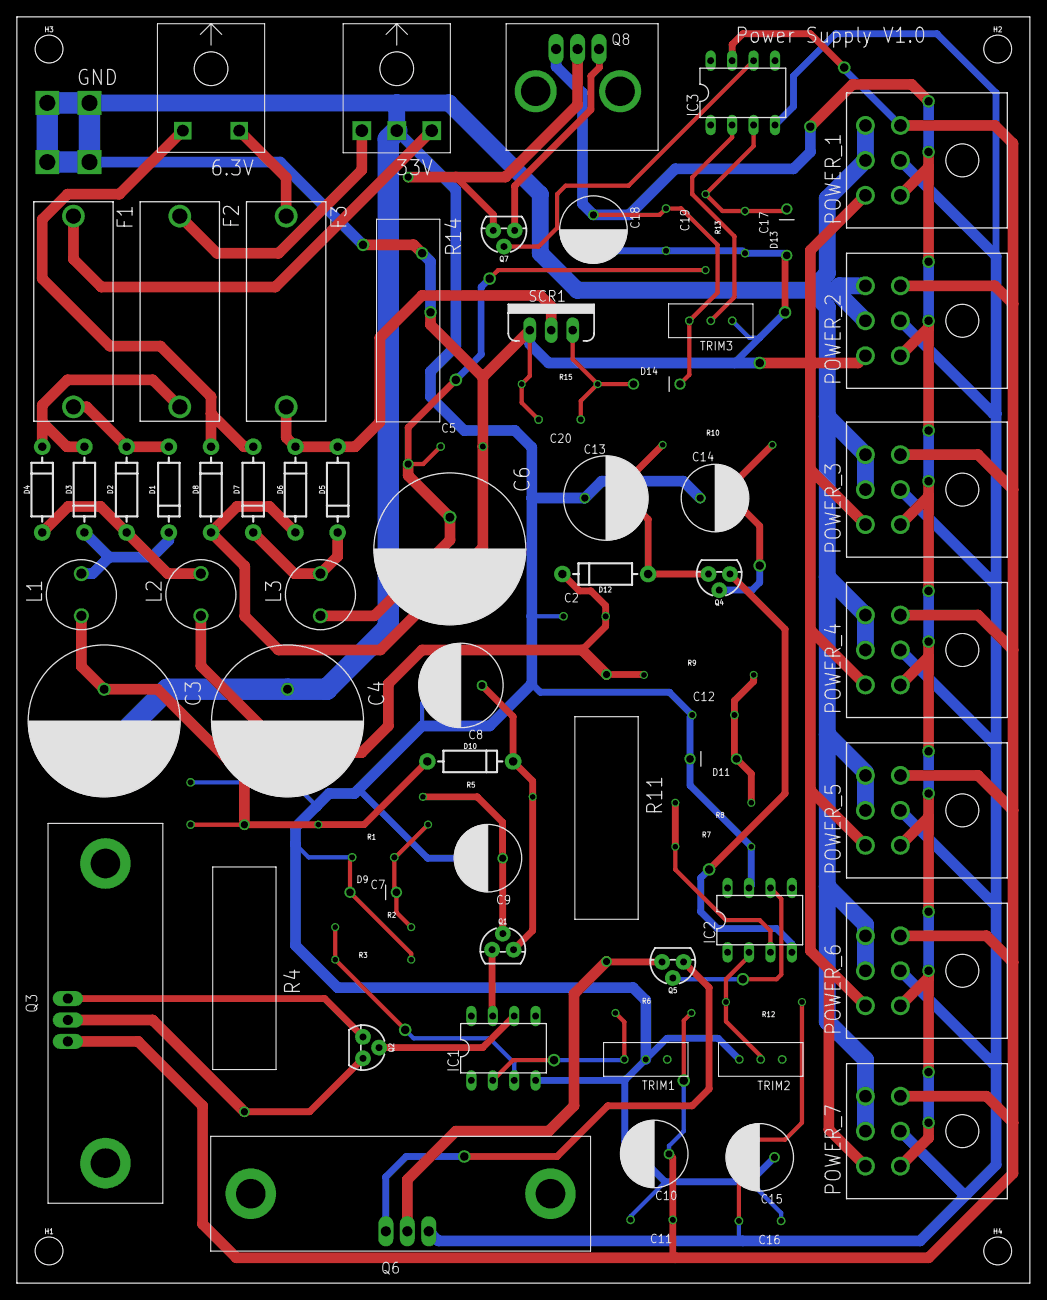
[picture p43: board Power Supply.brd from above]

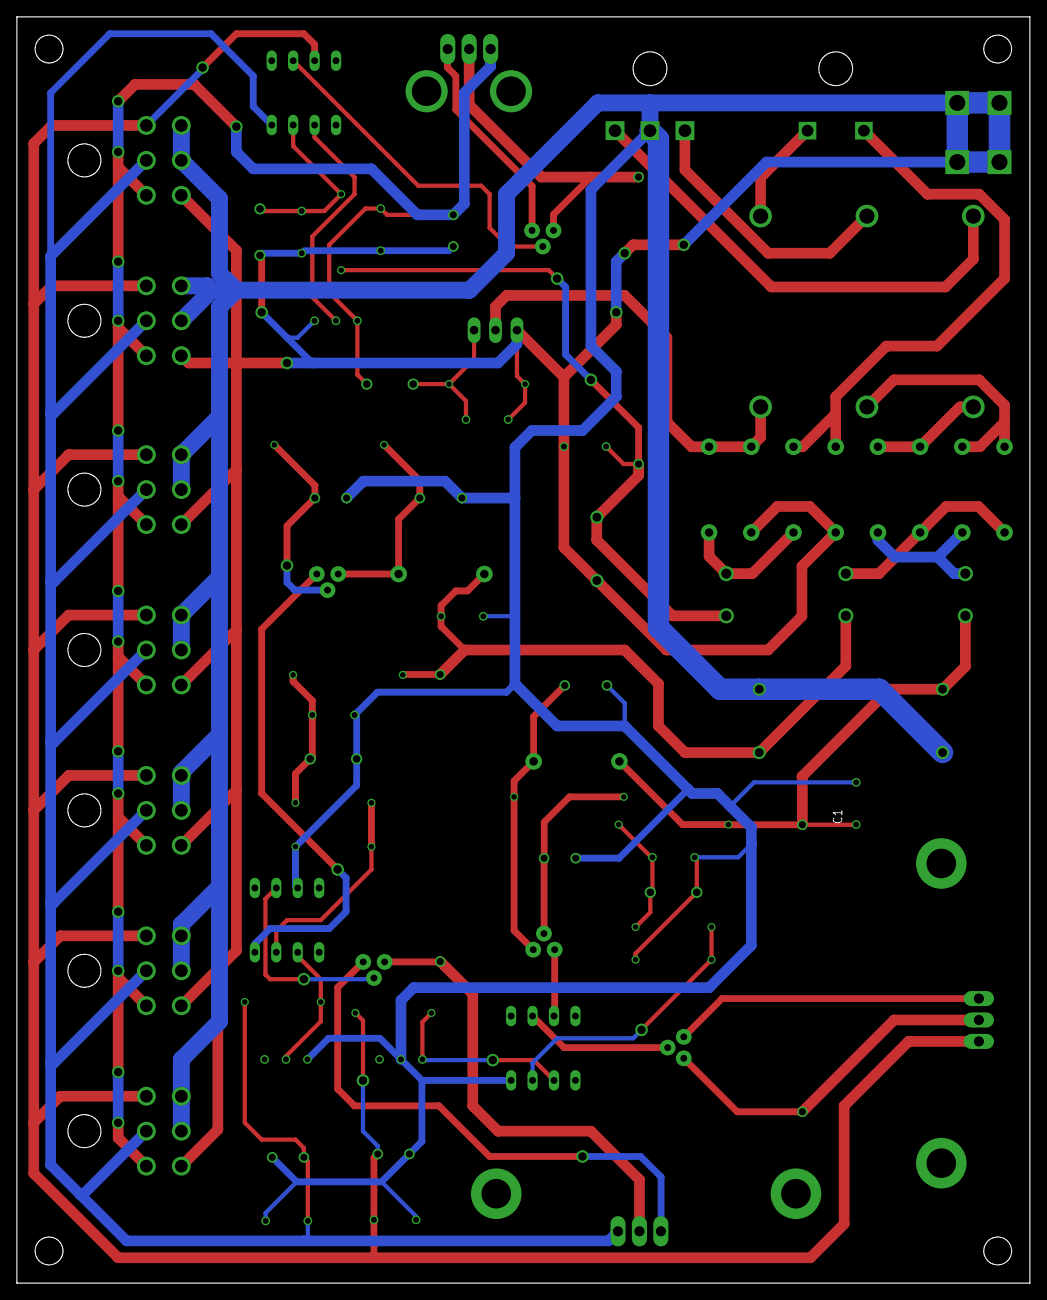
[picture p44: board Power Supply.brd from below]

Board: 2 copper layers, 120.0 x 150.0 mm, 84 parts (2 on the bottom side), 41 nets.
