kosikhar/Analog-Drum-Machine/Sequencer/Complex/Sequencer Block Diagram.sch

## EAGLE design Sequencer/Complex/Sequencer Block Diagram.sch (2019-03-05)

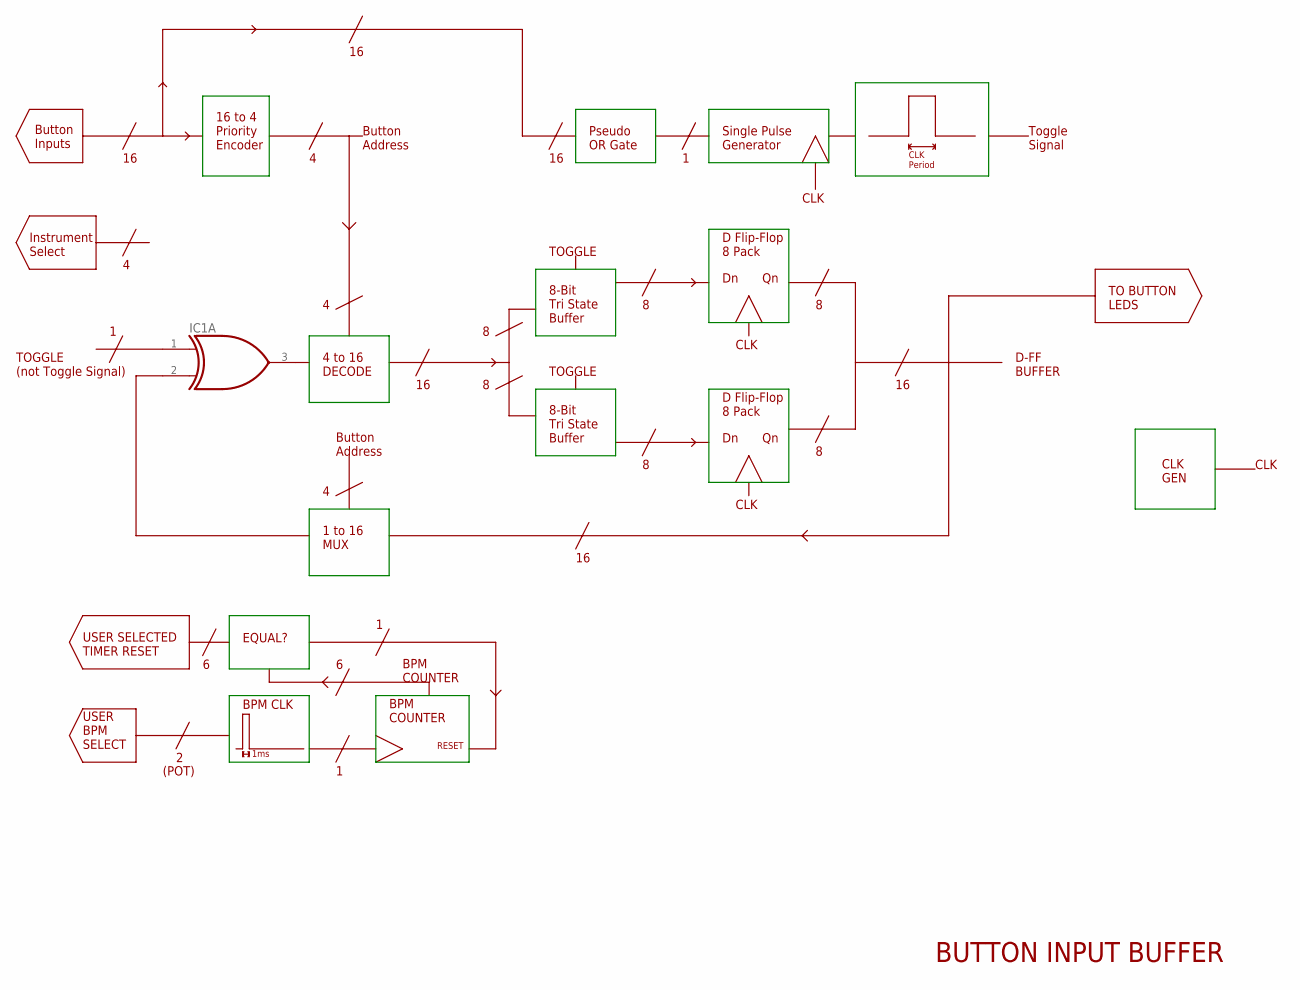
[picture p45: schematic Sequencer Block Diagram.sch, sheet 1]

Parts:
IC1: 74386N; DIL14

Notes on the sheet:
Button Inputs
16 to 4 Priority Encoder
Button Address
Pseudo OR Gate
Single Pulse Generator
CLK
CLK Period
Toggle Signal
4 to 16 DECODE
D Flip-Flop 8 Pack
Instrument Select
1 to 16 MUX
USER SELECTED TIMER RESET
EQUAL?
BPM CLK
BPM COUNTER
RESET
USER BPM SELECT
(POT)
1ms
CLK GEN
8-Bit Tri State Buffer
TOGGLE (not Toggle Signal)
TOGGLE
D-FF BUFFER
TO BUTTON LEDS
BUTTON INPUT BUFFER

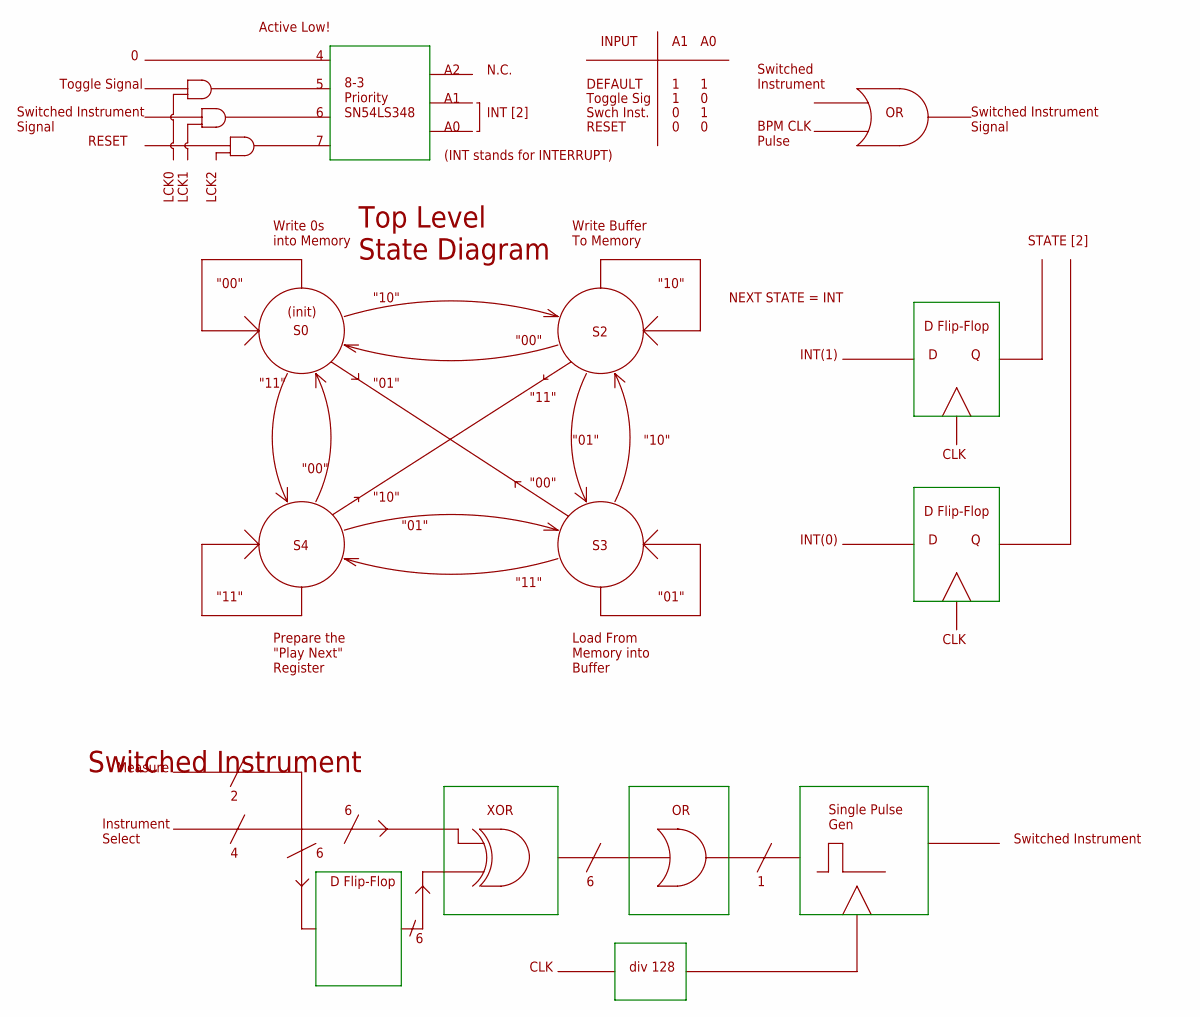
[picture p46: schematic Sequencer Block Diagram.sch, sheet 2]

Notes on the sheet:
"00"
Active Low!
8-3 Priority SN54LS348
Toggle Signal
Switched Instrument Signal
RESET
N.C.
INT [2]
INPUT
DEFAULT
Toggle Sig
Swch Inst.
(init)
Write 0s into Memory
"10"
Write Buffer To Memory
"01"
Load From Memory into Buffer
"11"
Prepare the "Play Next" Register
Top Level State Diagram
LCK0
LCK1
LCK2
NEXT STATE = INT
(INT stands for INTERRUPT)
D Flip-Flop
CLK
INT(1)
INT(0)
STATE [2]
Switched Instrument
BPM CLK Pulse
Switched Instrument
Instrument Select
Measure
XOR
Single Pulse Gen
div 128
Switched Instrument

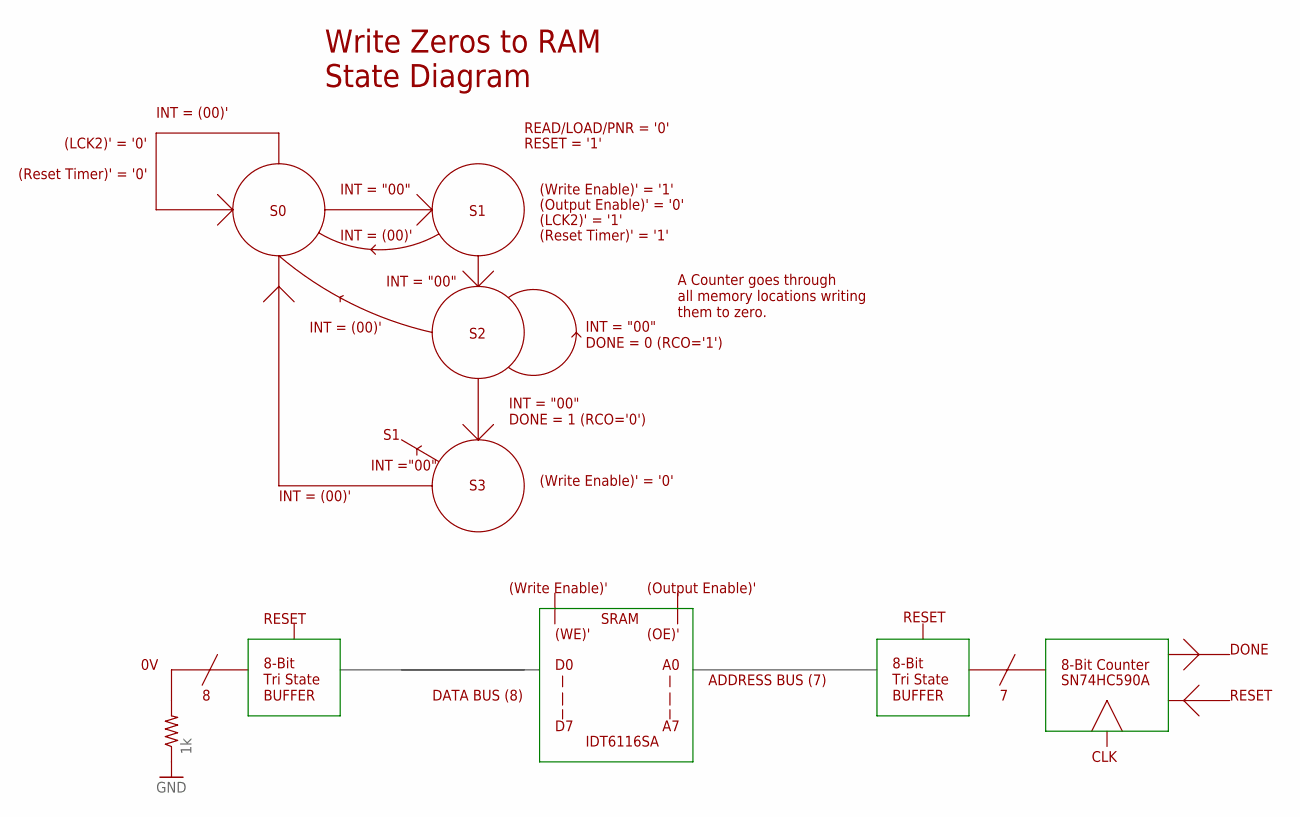
[picture p47: schematic Sequencer Block Diagram.sch, sheet 3]

Parts:
R1: 1k; 0204/5

Connections:
GND: R1.1

Notes on the sheet:
INT = (00)'
Write Zeros to RAM State Diagram
READ/LOAD/PNR = '0'
RESET = '1'
(Write Enable)' = '1'
(Output Enable)' = '0'
(LCK2)' = '1'
INT = "00"
INT = "00" DONE = 0 (RCO='1')
(Reset Timer)' = '1'
(LCK2)' = '0'
(Reset Timer)' = '0'
A Counter goes through all memory locations writing them to zero.
INT = "00" DONE = 1 (RCO='0')
(Write Enable)' = '0'
INT ="00"
8-Bit Tri State BUFFER
DATA BUS (8)
SRAM
(WE)'
(OE)'
(Write Enable)'
(Output Enable)'
IDT6116SA
ADDRESS BUS (7)
RESET
8-Bit Counter
CLK
SN74HC590A
DONE

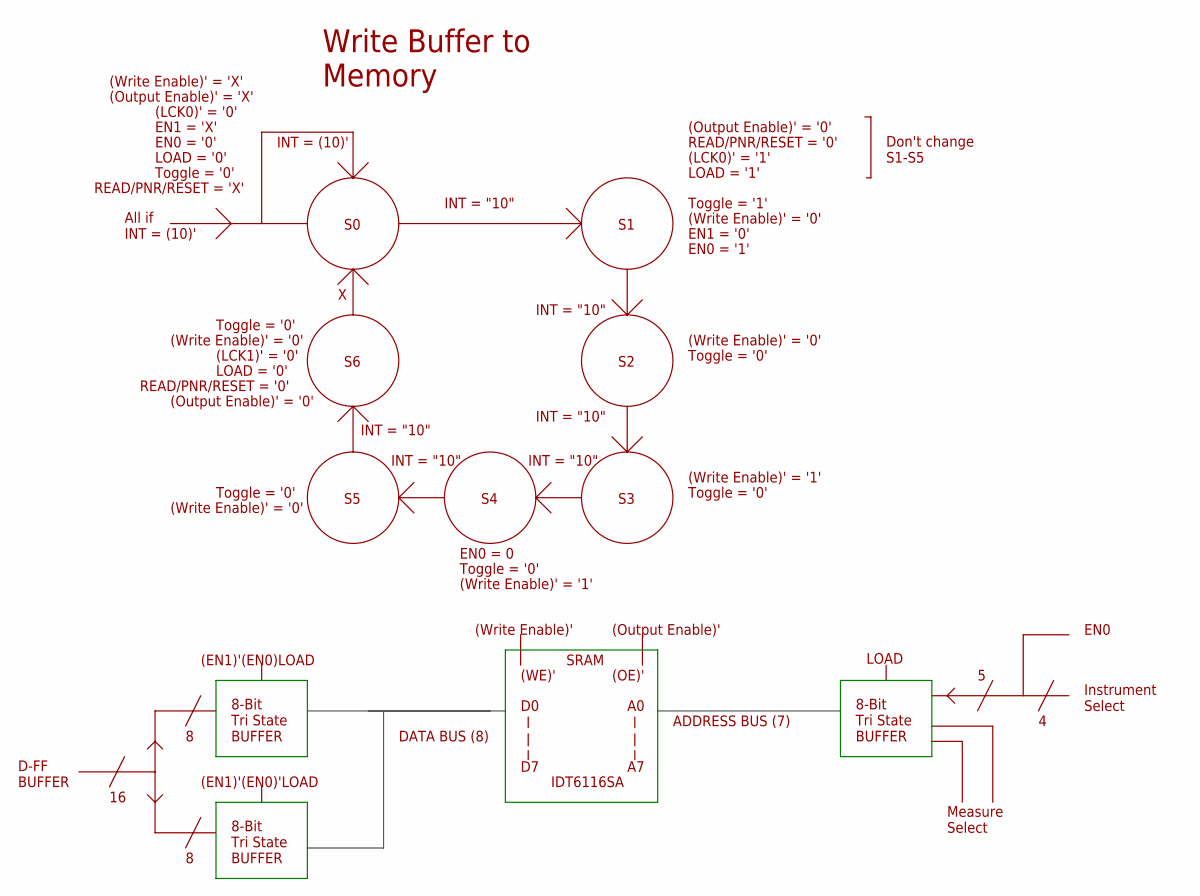
[picture p48: schematic Sequencer Block Diagram.sch, sheet 4]

Notes on the sheet:
Write Buffer to Memory
INT = "10"
INT = (10)'
LOAD = '0'
(LCK0)' = '0'
LOAD = '1'
Toggle = '1'
(LCK0)' = '1'
EN0 = '1'
EN1 = '0'
(Write Enable)' = '0'
(Output Enable)' = '0'
READ/PNR/RESET = '0'
All if INT = (10)'
Toggle = '0'
(Write Enable)' = '1'
EN0 = 0
READ/PNR/RESET = 'X'
EN1 = 'X'
EN0 = '0'
(Write Enable)' = 'X'
(Output Enable)' = 'X'
Don't change S1-S5
(LCK1)' = '0'
8-Bit Tri State BUFFER
(EN1)'(EN0)LOAD
(EN1)'(EN0)'LOAD
DATA BUS (8)
SRAM
(WE)'
(OE)'
(Write Enable)'
(Output Enable)'
IDT6116SA
ADDRESS BUS (7)
LOAD
D-FF BUFFER
Measure Select
Instrument Select
EN0

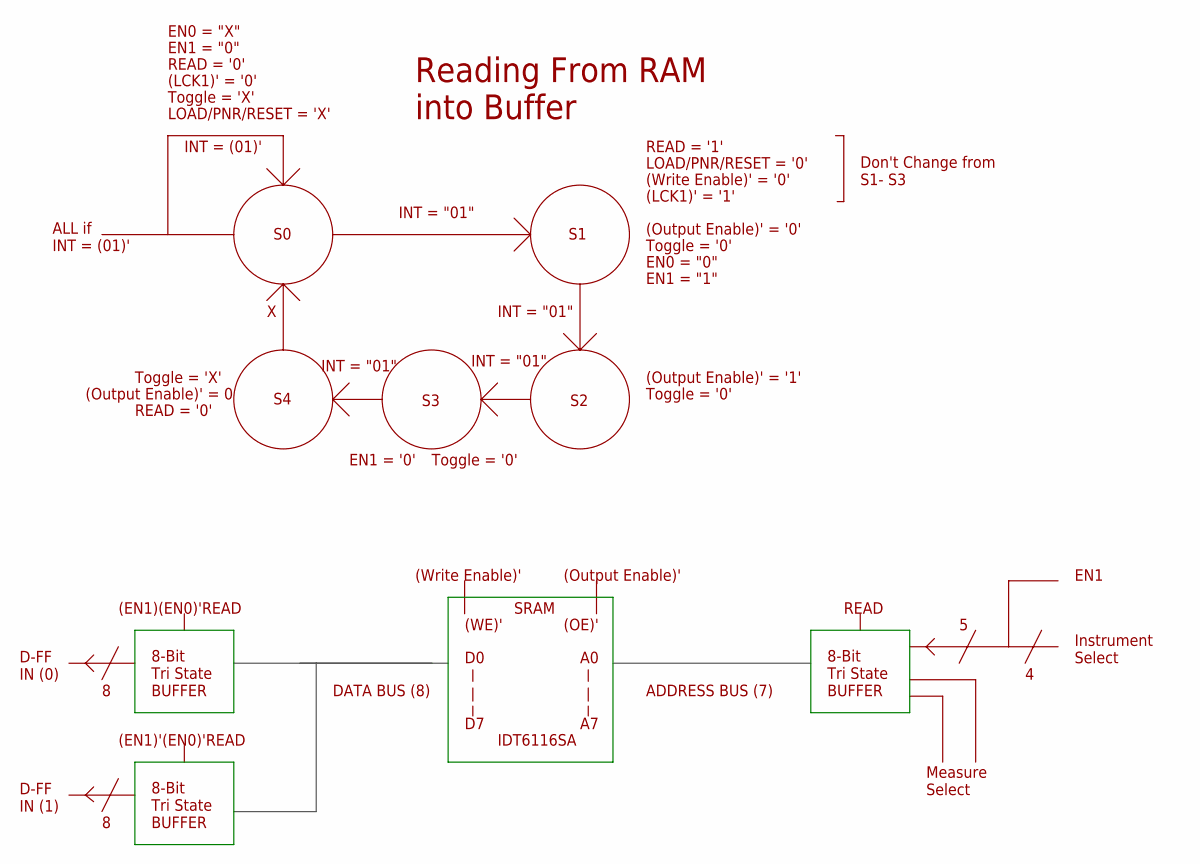
[picture p49: schematic Sequencer Block Diagram.sch, sheet 5]

Notes on the sheet:
Reading From RAM into Buffer
INT = "01"
INT = (01)'
ALL if INT = (01)'
READ = '0'
(LCK1)' = '0'
Toggle = 'X'
LOAD/PNR/RESET = 'X'
EN0 = "X"
EN1 = "0"
EN1 = "1"
LOAD/PNR/RESET = '0'
(Write Enable)' = '0'
(Output Enable)' = '0'
(LCK1)' = '1'
EN0 = "0"
(Output Enable)' = '1'
EN1 = '0'
READ = '1'
Toggle = '0'
(Output Enable)' = 0
Don't Change from S1- S3
8-Bit Tri State BUFFER
(EN1)(EN0)'READ
(EN1)'(EN0)'READ
DATA BUS (8)
SRAM
(WE)'
(OE)'
(Write Enable)'
(Output Enable)'
IDT6116SA
ADDRESS BUS (7)
D-FF IN (0)
Measure Select
Instrument Select
EN1
D-FF IN (1)
READ

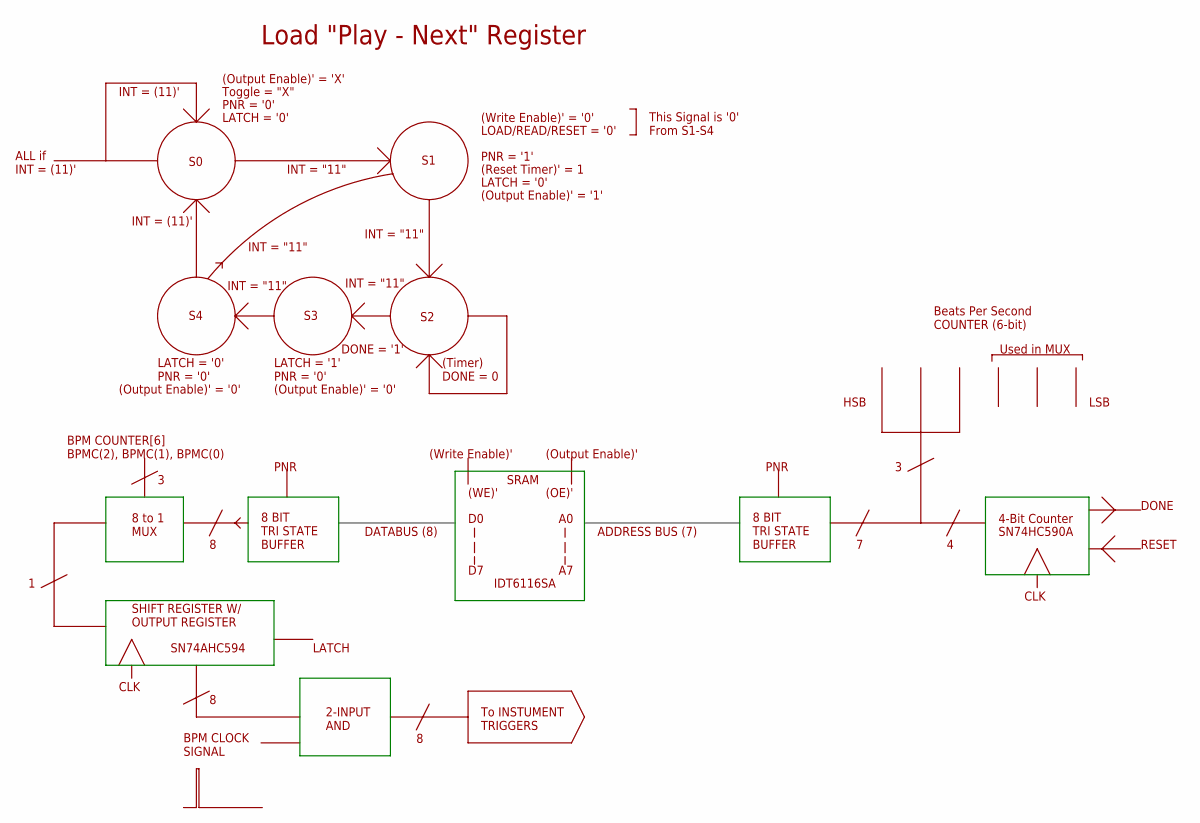
[picture p50: schematic Sequencer Block Diagram.sch, sheet 6]

Notes on the sheet:
Load "Play - Next" Register
ALL if INT = (11)'
INT = (11)'
INT = "11"
LATCH = '0'
Toggle = "X"
PNR = '0'
LOAD/READ/RESET = '0'
PNR = '1'
(Reset Timer)' = 1
(Timer) DONE = 0
DONE = '1'
This Signal is '0' From S1-S4
LATCH = '1' PNR = '0'
LATCH = '0' PNR = '0'
8 to 1 MUX
BPM COUNTER[6] BPMC(2), BPMC(1), BPMC(0)
8 BIT TRI STATE BUFFER
PNR
DATABUS (8)
SRAM
(Output Enable)' = '1'
(Output Enable)' = '0'
(Output Enable)' = 'X'
(WE)'
(OE)'
ADDRESS BUS (7)
Beats Per Second COUNTER (6-bit)
Used in MUX
4-Bit Counter
(Write Enable)'
(Output Enable)'
(Write Enable)' = '0'
CLK
SN74HC590A
RESET
DONE
SHIFT REGISTER W/ OUTPUT REGISTER
2-INPUT AND
BPM CLOCK SIGNAL
To INSTUMENT TRIGGERS
LATCH
SN74AHC594
IDT6116SA
LSB
HSB
