kosikhar/Analog-Drum-Machine/Sequencer/MicroController/Atmel Studio/Sequencer-micro/Tasks/Sequencer.cpp

/* 
* Sequencer.cpp
*
* Created: 2019-03-15 6:36:04 PM
* Author: Koltin Kosik-Harvey
*/


#include "Sequencer.h"

// default constructor
Sequencer::Sequencer( Timer & timerRef, DigitalInput & digitalInputRef, RotaryEncoder & rotaryEncoderRef )
{
	//Store references 
	digitalInput = &digitalInputRef;
	rotaryEncoder = &rotaryEncoderRef;
	buttons = digitalInput->buttons;
	timer = &timerRef;
	
	//Initialize all the programmed values to zero.
	//TODO: LOAD FROM EEPROM
	for(uint8_t i=0; i < NUM_MEASURES ; i++ ){
		for( uint8_t j=0; j < SIZE_OF_MEASURE; j++){
			programedValues[i][j] = 0;
		}
	}

	//Initialize variables
	instrumentBeingProgrammed = 0;
	measure = 0;
	positionInTime = 0;
	loopBackLength = 15;
	triggerInstruments = false;

	timeStamp_Timer = 0;
	timeStamp_updateLEDs = 0;
	
} //Sequencer

void Sequencer::checkButtons( void )
{
	//Check if there is button press.
	//If there is any toggled values that would mean button has pressed.
	//The toggleValues is a 16-bit number representing 16 buttons
	//that has a 1 in a location that a button has been pressed 
	if( buttons->toggledValues != 0 ){
	
		//Boolean to indicate if bit should should be toggled
		uint16_t toggleBit = 0;
		
		//Go through all the button inputs and figure which values to toggle
		for(uint8_t i=0; i < SIZE_OF_MEASURE ; i++){
			//Shift toggled value array and pull out the left most bit.
			toggleBit = ((0x0001) & (buttons->toggledValues >> i));
			
			//Toggle the programmed value
			programedValues[measure][i] ^= (0x0000) | (toggleBit << i);
		}

		//Set toggled values to 0
		buttons->toggledValues = 0;

		//Do the rest in the next pass.
		return;
	}	
}

void Sequencer::checkInstrumentSelect( void )
{
	
}

void Sequencer::checkMeasureSelect( void )
{

}

void Sequencer::updateLEDs( void )
{
	if( timer->elapsed_millis(timeStamp_updateLEDs) >= UPDATE_LEDS_PERIOD ){
		
		timeStamp_updateLEDs = timer->millis();
		
		leds->loadMeasure( (uint16_t **) programedValues , measure, SIZE_OF_MEASURE );
		leds->setInstrument( instrumentBeingProgrammed );
		leds->generateBitMap();
	}
}

void Sequencer::runTimer( void )
{

	if( timer->elapsed_millis( timeStamp_Timer ) >= PULSE_PERIOD_DBG )
	{
		//Refresh time stamp.
		timeStamp_Timer = timer->millis();

		//increment position in time
		this->positionInTime = this->positionInTime + 1;

		//if it's higher than loopback then reset.
		if ( this->positionInTime > loopBackLength ){
			this->positionInTime = 0;
		}

		triggerInstruments = true;
	}

}

void Sequencer::loadSequence(uint16_t * sequence, uint8_t size )
{
	for( uint8_t i=0; i < size ; i++ ){
		uint8_t effectiveMeasure = (i >> 4);

		programedValues[effectiveMeasure][i] = sequence[i];
	}
}

void Sequencer::loadInstrumentTriggerReference( InstrumentTrigger & instrumentTriggerRef )
{
	instrumentTrigger = &instrumentTriggerRef;
}

uint8_t Sequencer::getPositionInTime( void )
{
	return positionInTime;
}

// default destructor
Sequencer::~Sequencer()
{
} //~Sequencer
