kosikhar/Analog-Drum-Machine/Sequencer/MicroController/Atmel Studio/Sequencer-micro/Interface/RotarySwitch.cpp

/* 
* RotarySwitch.cpp
*
* Created: 2019-03-17 5:18:52 PM
* Author: k0s
*/


#include "RotarySwitch.h"

// default constructor
RotarySwitch::RotarySwitch()
{
} //RotarySwitch

void RotarySwitch::loadRawInput( uint16_t input )
{

}

// default destructor
RotarySwitch::~RotarySwitch()
{
} //~RotarySwitch
