kosikhar/Analog-Drum-Machine/Sequencer/MicroController/Atmel Studio/Sequencer-micro/Tasks/setupTasks.h

/*
 * setupTasks.h
 *
 * Created: 2019-02-05 12:20:47 AM
 *  Author: k0s
 */ 


#ifndef SETUPTASKS_H_
#define SETUPTASKS_H_

#include "TaskManager.h"
#include "../timer.h"
#include "Blinky.h"
#include "Trigger.h"
#include "InputPoll.h"
#include "DigitalInput.h"
#include "PrintOutput.h"
#include "RotaryEncoder.h"

#endif /* SETUPTASKS_H_ */
