kosikhar/Analog-Drum-Machine/Sequencer/MicroController/Atmel Studio/Sequencer-micro/Tasks/LEDs.h

/* 
* LEDs.h
*
* Created: 2019-03-15 4:27:20 PM
* Author: Koltin Kosik-Harvey
*/


#ifndef __LEDS_H__
#define __LEDS_H__

//Object Task for controlling 16 LEDs on the Top Panel
class LEDs
{
	//variables
	public:
	protected:
	private:

	//functions
	public:
		LEDs();
		~LEDs();
	protected:
	private:
		LEDs( const LEDs &c );
		LEDs& operator=( const LEDs &c );

}; //LEDs

#endif //__LEDS_H__
