kosikhar/Analog-Drum-Machine/Sequencer/MicroController/Atmel Studio/Sequencer-micro/interrupts.h

/*
 * interrupts.h
 *
 * Created: 2018-12-20 1:19:47 AM
 *  Author: k0s
 */ 


#ifndef INTERRUPTS_H_
#define INTERRUPTS_H_

#include <avr/interrupt.h>
#include "timer.h"

//Setup the registers for configuring the 328's timers.
void setUpTimerInterrupts( void );

void enableShifting( void );

void disableShifting( void );

void disableTimerOneInterrupts( void );

void enableTimerOneInterrupts( void );

#endif /* INTERRUPTS_H_ */
