kosikhar/Analog-Drum-Machine/(commit log)

2018-11-07 Create Main board
2018-11-18 Kick drum (#1)
    * some changes to the kick
    * Added BOM
    * missed some parts for the BOM
    [BOM.xlsx]
2019-01-26 perf board for instruments plus gerbers (#2)
    [instrument_generic.brd, instrument_generic.sch]
2019-01-28 Power supply (#3)
    * preliminary
    * Added power supply V2
    * Update Power Supply/Thumbs.db
    * Updated Power Supply Branch
    Updated Power supply branch with newest LTspice models, as well as Eagle Schematic and block diagram. BOM updated as well.
    * Added version with diff amp
    * Made changes to power supply PCB
    * Power supply PCB still in progress
    * Finished PCB
    [Power Supply BOM V4.xlsx, Power Supply Block Diagram.sch, Power Supply Schematic.sch, Power Supply.brd, Power Supply.sch]
2019-01-31 Analog Drum (#4)
    * changes to envolope
    * changes to feedback/osc
    * This is pretty much close to the final form
    Not much needed to change here. Kick sounds great
    * changes to some names and added sounds
    * added block diagram
    * added monochrome pdf print out
    * Update Drum.asc
    * Changed block diagram
    * changed name of BOM
    * updated block diagram
    * moved blocks over
    * Update Sequencer Block Diagram.pdf
    * revert
    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
    [Analog Drum.brd, Analog Drum.csv, Analog Drum.sch, BOM - Analog Drum.xlsx, BOM.xlsx, Drum Block Diagram.sch]
2019-03-05 Sequencer microcontroller (#7)
    * Sequencer State Diagrams update
    * Work on state diagram
    * update State diagram
    * updated state diagram
    * Added to State Diagram
    * Updated sequencer diagram
    * finishing touches
    * K I think this is done
    * k this should be good now
    * BOM
    * Create Flow Chart.vsdx
    * initialize
    * intialized more files
    * Added more intializers
    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
    [BOM - Sequencer.xlsx, Sequencer Block Diagram.sch, sequencer_uC.brd, sequencer_uC.sch]
2019-03-06 Added 100ohm resistor
    [Analog Drum.brd, Analog Drum.csv, Analog Drum.sch]
2019-03-07 Pata breakout sequencer (#10)
    * Just added some SR
    * Update .gitignore
    * Delete Analog Drum_2019-01-31.zip
    * updated gitignore
    * some board layout
    * split board into 2
    * breakout backside
    * Finished routing
    * Update PATA Breakout 2.brd
    * Finished top board - ran DRC
    * generated gerbers
    [PATA Breakout 2.brd, PATA Breakout 2.sch, PATA Breakout Sequencer.brd, PATA Breakout Sequencer.sch]
2019-03-07 Main board (#8)
    * First push
    Initial upload.
    * Schematic
    Only schematic added
    * Delete Main board schematic.zip
    * CIrcuit for switches
    Seperate schematic for switches (Updated)
    * Update MainBoard/Main board schematic.pdf
    * Cleaned up schematics
    Instruments, switches and initial diagram.
    * Updated schematics
    Removed #s files
    * Delete Switches.sch
    * Completed schematics
    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
    [Main board.brd, Main board.sch]
2019-03-07 Pata breakout (#9)
    * PATA breakout
    * did DRC
    * Delete .PATA Breakout.sch.lck
    [PATA Breakout.brd, PATA Breakout.sch]
2019-03-07 Cowbell (#6)
    * Added Cowbell Simulation Files
    * Committing to switch branches
    * Added the Schmitt Triggers
    * Organized folder structure.
    * Added BOM and Astable Multivibrator
    * Just switching branches
    * Minor modifications
    * Cleaned up useless files.
    * Updated LTspice file with values used during prototype on breadboard.
    * Created Cowbell Schematic
    * Touched up schematic and started board layout.
    * Placed parts on .brd file. Have to route yet.
    * Repositioned main header.
    * Completed board layout, generated CAM files, and organized files and folders.
    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
    [Block Diagram.sch, CB_BOM.xlsx, Cowbell.brd, Cowbell.sch, Mixer Block Diagram.sch, Mixer_BOM.xlsx, Wood_Cutting_Outline.SLDPRT]
2019-03-07 Mixer (#5)
    * Created new branch and README.md for Mixer
    * Created Input Module Simulation-Still Under Testing
    * Added Mixer Input Module
    * Added Summing Circuit
    * Deleted Temporary Files
    * Added Amplifier Stage and Selected Caps for Cutoff Frequency=40kHz
    * Just Viewed
    * Updated Mixer
    * Switching Branches Again
    * Revised Mixer
    * Added Mixer_BOM
    * Switching Branches
    * Updated some capacitors
    Changed some caps from 2.2uF to 4.7uF, got rid of a 4.7uF
    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
    [Mixer Characterization.xlsx, Mixer.brd, Mixer.sch, VU Meter values.xlsx]
2019-03-07 Snare (#11)
    * Started Snare PCB
    * Finished Schematic
    Finished Schematic
    * Updated Snare schematic
    updated snare schematic
    * Started PCB
    Started working on the PCB
    Finished the snare PCB
    * Finished Silkscreen
    * Added a few missing components
    Added a few missing components. 3 coupling capacitors were missing
    * Generated Gerbers
    * Created Gerbers again and fixed Seeed DRC errors
    Created Gerbers again and fixed Seeed DRC errors
    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
    [Analog Drum.csv, Snare.brd, Snare.sch]
2019-03-11 added rotary switch classs
2019-03-15 Did work on rotary encoder class
2019-03-16 Changes to output printing behaviour
    -still bugs
    [BPM.h, DigitalInput.h, PrintOutput.cpp, PrintOutput.h, RotaryEncoder.cpp, RotaryEncoder.h, Sequencer.h, SevenSeg.cpp]
2019-03-28 More major object building
    - Issue with compiling "RotarySwitch"
    [Blinky.cpp, Blinky.h, DigitalInput.cpp, DigitalInput.h, InputPoll.cpp, InputPoll.h, PrintOutput.h, RotarySwitch.cpp]
